MedAmine-source/Ameloration-of-old-industrial-machinery/new version machine beta/robot-gripper-mechanism-v2-1.snapshot.5/hvataljka v2.jpg

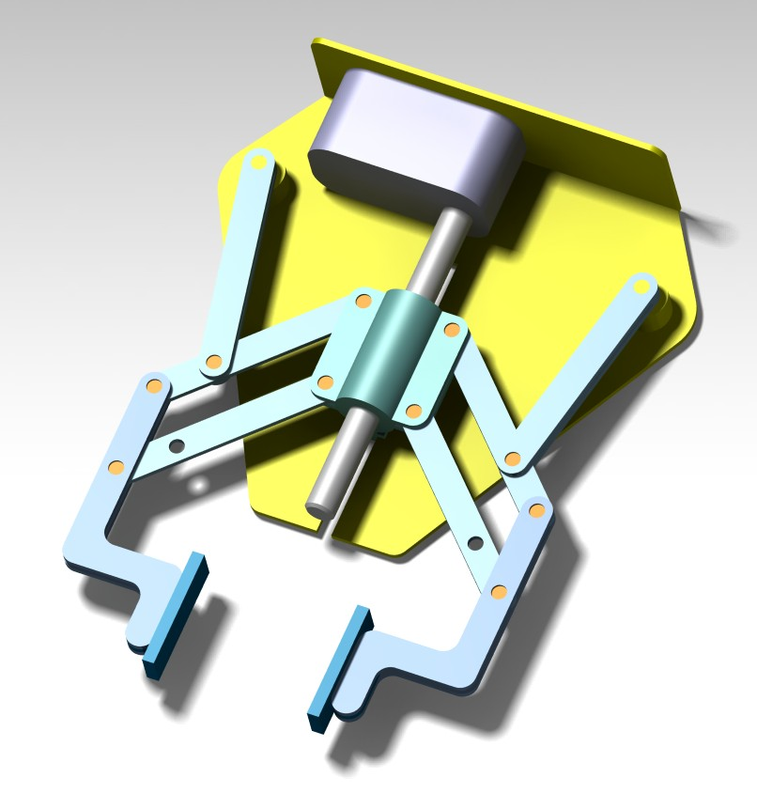
new version machine beta/robot-gripper-mechanism-v2-1.snapshot.5/hvataljka v2.jpg
