MedAmine-source/Ameloration-of-old-industrial-machinery/README.md

# Ameloration-of-old-industrial-machinery
this project is a full work to improve an old machine installed in a wheels factory . the main function of it is the Gluing the 'apex' material in metallic form is called 'trangle' to support the wheel being manufactured.
