MedAmine-source/Ameloration-of-old-industrial-machinery/old version machine/mechanical design/apex machine.docx

Introduction générale

# CHAPITRE 1: Recherche bibliographie

## 1.1 Description de machine :

La machine d’application Apex sur tringle est un équipement industriel utilisé dans le processus de fabrication des pneus. Elle permet l’assemblage d’une bande de caoutchouc rigide appelée « Apex » autour de la tringle métallique du pneu. Cette opération est essentielle car elle contribue à renforcer la zone basse du pneu et à améliorer sa rigidité ainsi que sa stabilité structurelle.

L'installation actuelle repose sur une architecture de commande ancienne utilisant des composants devenus obsolètes, ce qui engendre des difficultés de maintenance, de disponibilité des pièces de rechange et de fiabilité opérationnelle.

## 1.2 Les types de machines :

- Automatic Apex Application System – Steelastic:

L’Automatic Apex Application System[1] développé par Steelastic est une machine industrielle entièrement automatisée utilisée dans le processus de fabrication des pneus. Elle permet l’application précise et continue de la bande Apex autour de la tringle métallique (bead) avant l’étape d’assemblage du pneu.

Ce système intègre :

- Un mécanisme d’alimentation automatique de la bande Apex
- Un système de positionnement et de rotation contrôlée de la tringle
- Des rouleaux presseurs assurant une adhérence uniforme
- Des capteurs de contrôle de tension et de position
- Un système de commande par automate programmable (PLC)

L’objectif principal de cette machine est d’assurer :

- Une haute précision d’application
- Une répétabilité constante
- Une réduction des erreurs humaines
- Une amélioration significative de la productivité

Ce type de solution est généralement utilisé dans les usines modernes de fabrication de pneus à grande capacité de production.

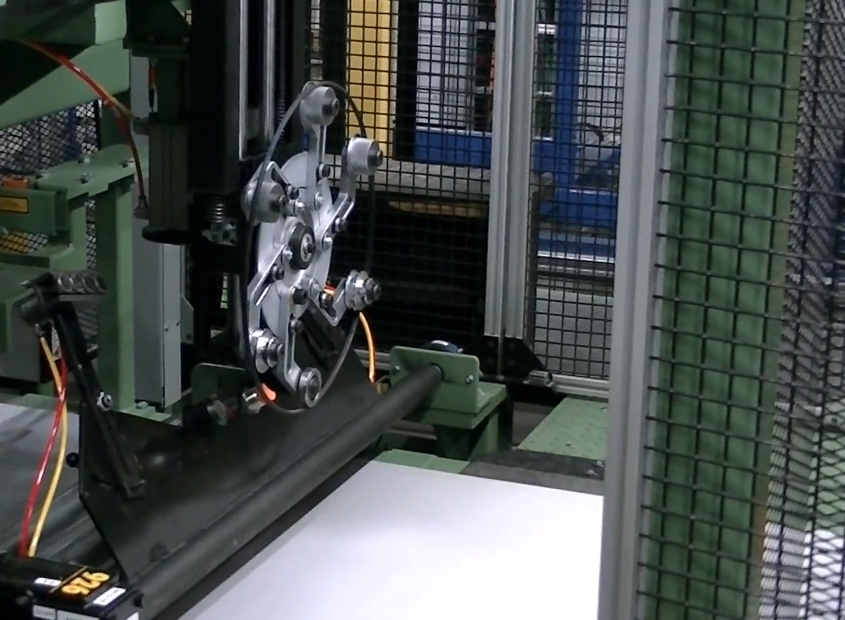
[picture p2: figure]

Figure 1:machine apex steelastic

- Bead Apexing Machines – Intereuropean:

Les Bead Apexing Machines[2] développées par Intereuropean sont des équipements industriels automatiques destinés à l’application de la bande Apex sur la tringle (bead) dans le processus de fabrication des pneus.

Ces machines sont conçues pour garantir une application précise, uniforme et répétable de l’Apex, contribuant ainsi à améliorer la rigidité structurelle et la qualité finale du pneu.

Le système comprend généralement :

- Une unité d’alimentation ou d’extrusion de la bande Apex
- Un dispositif de positionnement et de rotation automatique de la tringle
- Des rouleaux de pression assurant une adhérence optimale
- Des capteurs de contrôle de position et de tension
- Un système de commande automatisé (PLC + interface opérateur)

Les machines d’Intereuropean peuvent être intégrées dans une ligne complète comprenant également l’application du flipper, permettant ainsi une automatisation avancée du processus de préparation de la tringle.

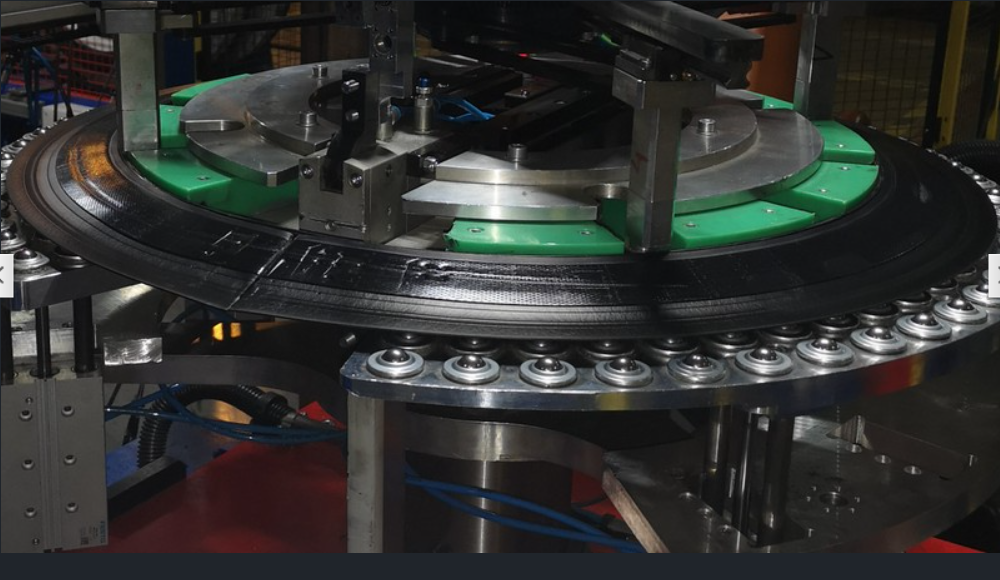
[picture p3: figure]

Figure 2: machine apex INTEREUROPEAN

- Bead Apexing Machines – VIPO:

Les machines semi-automatiques et automatiques d’application Apex[3] développées par VIPO sont destinées au montage précis de la bande Apex sur la tringle dans le processus de fabrication des pneus.

Ces équipements sont conçus pour améliorer la qualité d’assemblage, réduire l’effort humain et garantir une meilleure répétabilité par rapport aux systèmes manuels traditionnels.

Selon le modèle (PCR, TBR, AGRO), les machines peuvent inclure :

- Un système d’alimentation contrôlée de la bande Apex
- Un dispositif de rotation motorisée de la tringle
- Des rouleaux de pression assurant une application uniforme
- Un contrôle de tension de la bande
- Un système de commande programmable (PLC)
- Une interface opérateur pour le réglage des paramètres
- Automatic Truck Bead Apex System:

Les versions semi-automatiques comme le machine apex de la qualité Bartell Machinery [4] nécessitent encore l’intervention de l’opérateur pour certaines étapes (chargement, positionnement), tandis que les versions automatiques assurent un cycle presque entièrement contrôlé par le système de commande.

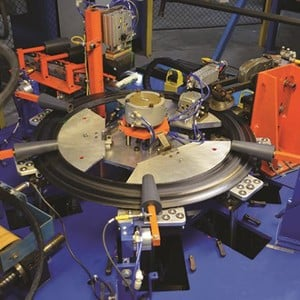
[picture p4: figure]
Automatic Truck Bead Apex System-Image

Figure 3: machine apex Bartell Machinery

- Machine apex tourisme STIP-AMINE :

Le machine apex STIP-AMINE est une machine semi-manuel permet d’assembler le matière apex sur le support trangle par l’opérateur.

L'installation actuelle repose sur une architecture de commande ancienne utilisant des composants devenus obsolètes, ce qui engendre des difficultés de maintenance, de disponibilité des pièces de rechange et de fiabilité opérationnelle

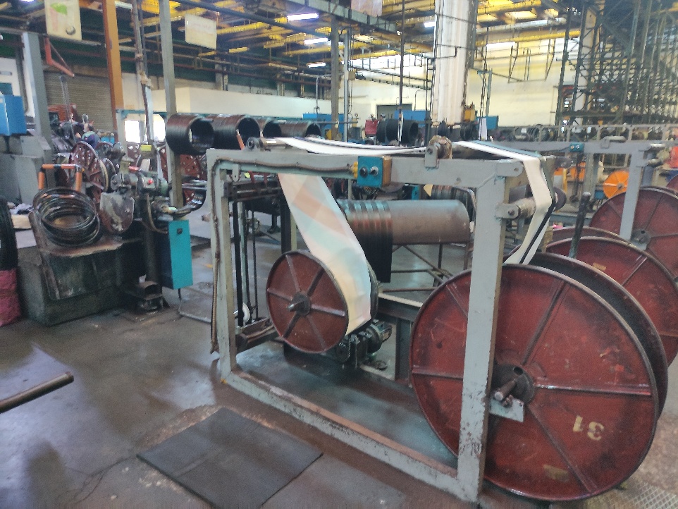
[picture p5: figure]

Figure 4:machine apex tourisme STIP

## 1.3 Domaine d’application des machines Apex :

- Industrie concernée :

Ces machines sont utilisées dans :

- L’industrie des pneus automobiles (PCR – Passenger Car Radial)
- L’industrie des pneus poids lourds (TBR – Truck and Bus Radial)
- L’industrie des pneus agricoles (AGRO)
- L’industrie des pneus industriels et génie civil (OTR – Off The Road)

Les grandes entreprises du secteur pneumatique utilisent ce type d’équipement dans leurs lignes de production automatisées.

- Rôle dans le processus de fabrication :

Dans le processus de fabrication d’un pneu, l’Apex est une bande de caoutchouc rigide appliquée autour de la tringle métallique. Son rôle est :

- D’assurer la rigidité de la base du pneu
- De renforcer la zone de contact avec la jante
- D’améliorer la stabilité et la durabilité du pneu

La machine d’application Apex intervient avant l’assemblage du pneu vert (green tire) et avant la phase de vulcanisation.

- Types de production concernés :

Ces machines sont adaptées aux :

- Lignes de production à grande cadence
- Systèmes de fabrication automatisés
- Usines à haute exigence de qualité
- Environnements industriels nécessitant une précision répétable
- Importance industrielle :

L’application correcte de l’Apex influence directement :

- La qualité du pneu final
- La sécurité du véhicule
- La durée de vie du pneu
- La performance mécanique

Une mauvaise application peut provoquer des défauts structurels ou un déséquilibre du pneu.

## 1.4 Étude de l’existante :

### 1.4.1 Partie mécanique :

La machine se compose principalement de :

-Système de transmission à poulies et courroies.

-Guides mécaniques en queue d’hirondelle.

-Vérins pneumatiques pour des opérations de manutention spécifiques.

-Éléments de transport qui permettent le déplacement de différents axes.

- Limites observées :

-Corrosion mécanique de certains composants.

-Le jeu mécanique affecte la précision.

-Difficulté à ajuster les positions.

-Maintenance fréquente.

### 1.4.2 Partie électrique :

L’armoire électrique contient :

-Connecteurs.

-Relais électromécaniques.

-Sources d’énergie.

-Capteurs de fin de course.

-Électrovannes pneumatiques.

- Limites observées

-Câblage complexe.

-Difficulté à diagnostiquer les erreurs.

-Manque de supervision moderne.

-Maintenance coûteuse.

## 1.5 Conclusion :

Le domaine de la préparation de la tringle dans l’industrie du pneumatique, une étape critique influençant la qualité et la sécurité du produit final.

# CHAPITRE 2: Analyse fonctionnelle

## 2.1 Introduction :

L’analyse fonctionnelle est une démarche méthodologique utilisée en ingénierie pour identifier, structurer et formaliser les fonctions qu’un système doit assurer, indépendamment des solutions techniques adoptées. Dans le cadre du projet de rénovation de la machine d’application Apex, l’analyse fonctionnelle constitue une étape essentielle afin de comprendre le fonctionnement global du système actuel et de définir les améliorations nécessaires.

## 2.2 Analyse de besoin :

### 2.2.1 Saisi de besoin :

Le machine d’apex a plusieurs problèmes a regluer :

- Augmenter la fiabilité du système.
- Améliorez la précision des mouvements.
- Réduire les temps de maintenance.
- Mettez à jour l’interface du lanceur.
- Faciliter le diagnostic des défauts.
- Permettre le développement futur du système.

### 2.2.2 ENONCE DU BESOIN :

- À qui rend service la machine ?

Utilisateur : Opérateur industriel

- Sur quoi agit-elle ?

Matière d’œuvre : Tringle + bande Apex

- Dans quel but ?

Assurer l’application correcte de l’Apex sur la trangle

Diagramme bête corne :

Opérateur industriel

Tringle et bande apex

Machine apex tourisme

Assurer l’application correcte de l’Apex sur la tringle

À qui la machine sert- il

A qui l’imprimante 3D sert- il

Sur quoi agit-il

Sur quoi agit-il

Dans quel but le produit existe-il

Dans quel but le produit existe-il

Figure 5:diagramme bête corne

### 2.2.3 VALIDATION DU BESION :

La machine d’application Apex sur tringle est conçue pour répondre au besoin d’assurer un assemblage précis, uniforme et sécurisé de la bande Apex autour de la tringle métallique dans le processus de fabrication des pneus. Cette opération est essentielle pour garantir la rigidité structurelle et la qualité finale du produit.

Cependant, le système actuellement en service repose sur un fonctionnement semi-manuel nécessitant une intervention humaine permanente, ce qui limite la précision, la répétabilité et la productivité du processus. La modernisation de cette machine vise donc à améliorer l’efficacité de production, à réduire les variations liées à l’opérateur et à renforcer les conditions de sécurité.

Dans un contexte industriel où les exigences de qualité, de performance et d’automatisation sont en constante évolution, il est indispensable que la machine d’application Apex évolue afin de répondre aux standards modernes de l’industrie pneumatique et de maintenir la compétitivité de l’entreprise sur le marché.

### 2.2.4 Diagramme SADT :

Le diagramme SADT (Structured Analysis and Design Technique) est une méthode de modélisation fonctionnelle qui permet de représenter un système de manière structurée, en allant du général vers le détail. Il est particulièrement adapté aux systèmes industriels où coexistent plusieurs flux tels que la matière d’œuvre, l’énergie et les informations de commande.

Dans le cas de la machine d’application Apex, la modélisation SADT repose sur l’interaction entre quatre éléments fondamentaux :

• La fonction globale, qui consiste à assembler la matière Apex sur la tringle métallique afin d’obtenir une tringle assemblée prête pour l’étape suivante du processus de fabrication du pneu.

• Les moyens ou mécanismes (processeurs) intégrés dans le périmètre du système, tels que le moteur réducteur, la structure mécanique, ainsi que le système de logique câblée assurant la mise en marche.

• La matière d’œuvre, représentée par l’ensemble « Apex + tringle non assemblée » en entrée, transformé en « tringle assemblée » en sortie.

• Les données de contrôle et ressources, comprenant l’intervention de l’opérateur, la logique câblée, la commande de mise en marche et l’énergie électrique nécessaire au fonctionnement du système.

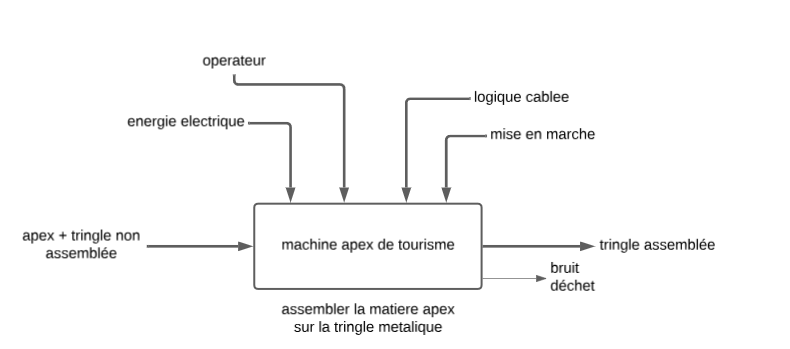
[picture p6: figure]

Figure 6:diagramme SADT

Par ailleurs, le système génère également des éléments secondaires en sortie, tels que le bruit et les déchets, qui constituent des flux environnementaux associés au fonctionnement de la machine.

Ainsi, le diagramme SADT permet de visualiser clairement le rôle de la machine Apex dans la transformation de la matière d’œuvre, tout en identifiant les interactions entre les flux d’énergie, de contrôle et de production.

### 2.2.5 Identification des fonctions de services principales et complémentaires :

Figure 7:diagramme pieuvre

FP

Apex machine tourisme

Milieu ambient

précision

Energie électrique

Utilisateur

Tringle +apex

FC1

FC2

FC3

Énonce des fonctions :

FP : assembler l’apex sur la tringle par un opérateur industriel

FC1 : résister à l’environnement industriel

FC2 : travailler sur une énergie électrique

FC3 : garantir une précision suffisante

### 2.2.6 Comparaison et valorisation des fonctions de services :

Pour hiérarchiser les fonctions de services du système, on utilise l’outil « Tri-croisé » qui correspond à un tableau contenant les différentes fonctions et leurs poids respectifs. Les notes sont attribuées selon la démarche de priorité suivante :

0 : Pas de supériorité.

1 : Légèrement supérieur.

2 : Moyennement supérieur.

3 : Nettement supérieur.

Tableau 1:tri croisé

| FC1 | FC2 | FC3 | Score
FP | 3/FP | 1/FP | 3/FP | 7
| FC1 | 3/FC2 | 3/FC1 | 3
| | FC2 | 1/FC3 | 2
| | | FC3 | 1
| | | TOTAL | 13

Figure 8: histogramme de la fonction

### 2.2.7 Digramme FAST :

Le diagramme FAST (fig.9.) (Function Analysis System Technique) permet d’établir le lien entre le besoin fondamental et l’architecture d’un produit en passant par les fonctions de service et les fonctions techniques.

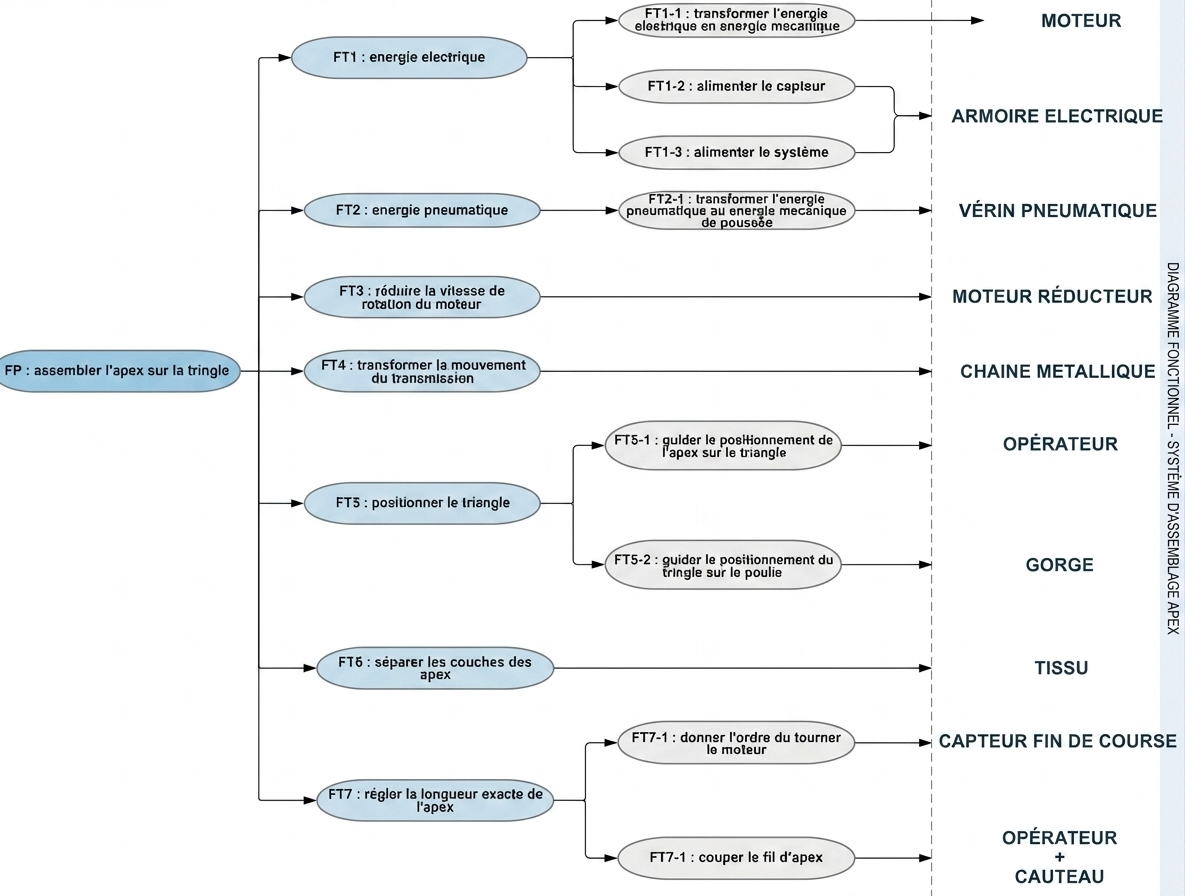
[picture p7: figure]

Figure 9:diagramme FAST

## 2.4 Reduction cahier de charge fonctionnel :

Le cahier des charges fonctionnel vise à définir les exigences nécessaires pour moderniser la machine d’application Apex. L’objectif principal est d’assurer un assemblage précis et fiable de la bande Apex sur la tringle, tout en améliorant la sécurité, la productivité et en réduisant l’intervention humaine. Cette machine a plusieurs problèmes retenus j’ai le diffuser sur plusieurs défauts

Tableau 2:tableau réduction de défauts

Défauts | | Les défauts
D1 | Système de freinage manuel | -usure a cause de pression non ajustée -réglage lente -maintenance lente
D2 | Sécurité | -Faible sécurité limite au buttons de l’urgence
D3 | Vibration de moteur principale | -moteur a haute couple causée de jetée le chaine, cassure le réducteur
D4 | Système de translation | -coincement lors de translation -un mauvais contact avec la capture qui commande le moteur principal a cause de l’emplacement incomplète de rouleau

## 2.5 Proposition des solutions :

Tableau 3:proposition des solutions

Prototypes proposée | | Image | Avantages (+) | Inconvénients (-)

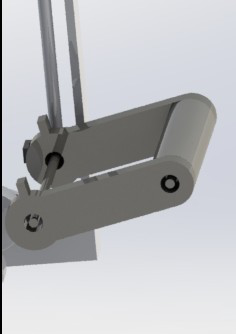
[picture p8: figure]

S1 | Levier rotatif | | -cout réduite -complexité de fabrication faible -vitesse élevée | -faible charge supportée -précision limitée

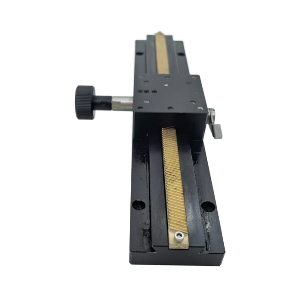
[picture p9: figure]

S2 | Queue d’aronde | | -précision très élevée -bon rigidité -support des charges lourds | -cout très élevée -fabrication complexe

## 2.6 Comparaison entre les solutions :

- Choix de critère :

Pour l’obtention d’une solution bien adaptée au besoin, il est nécessaire de respecter les critères suivants

Tableau 4:choix de critère de la solution

| Les critères
C1 | Cout
C2 | Maintenance
C3 | Facilement de montable et démontable
C4 | La durée de fabrication
C5 | Vitesse de fonctionnement

- Valorisation par critère :

Pour chaque critère, on a attribué une note qui varie entre 1 et 3 suivant l’intérêt de la solution :

Tableau 5:tableau valorisation du choix

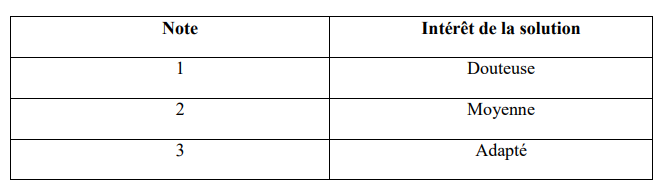
[picture p10: figure]

A partir la valorisation des critères on a dressé le tableau de la valorisation globale sur les solutions proposées ci-dessous :

Tableau 6:valorisation de critère sur solution D4

| Les solutions
| S1 | S2
C1 | 3 | 1
C2 | 3 | 2
C3 | 2 | 3
C4 | 3 | 1
C5 | 3 | 1

- Valorisation globale :

La valorisation globale est donnée par une note de 1 à 5 suivant l’importance des critères :

Tableau 7:Tableau de coefficient

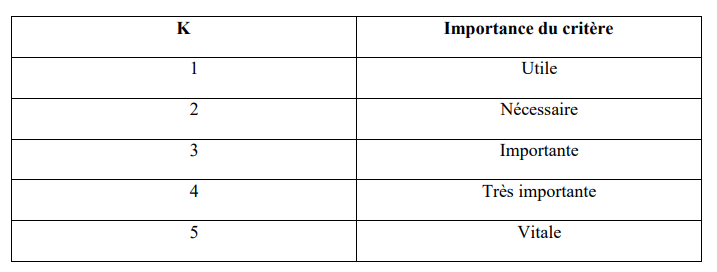
[picture p11: figure]

On applique cette valorisation globale sur les solutions proposées :

Tableau 8:valorisation globale du solution D4

| K | Solutions
| | S1 | | S2
| | note | total | note | total
C1 | 5 | 3 | 15 | 1 | 5
C2 | 2 | 3 | 6 | 2 | 4
C3 | 4 | 2 | 8 | 3 | 12
C4 | 5 | 3 | 15 | 1 | 5
C5 | 3 | 3 | 9 | 1 | 3
Total | | 53 | | 29

## 2.7 Analyse de résultats :

La solution retenue est le type S1 un levier rotatif car elle possède un total pondéré le plus élevé et globalement la plus intéressante

## 2.8 Choix des solutions :

## 2.9 Choix des actionneurs :

Le tableau ci-dessous représente les avantages et les inconvénients de chaque type des actionneurs, mais ça n’est pas suffisant. Les deux tableaux suivants fournissent une évaluation base sur d’autres critères afin que la sélection la plus précise puisse être faite :

Tableau 9:choix de actionneurs

N° | Type | Fonction principale | Avantages (+) | Inconvénients (-)

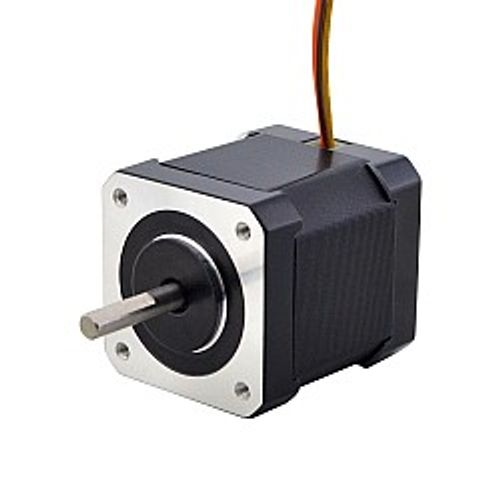
[picture p12: figure]
Nema 17 Moteur pas à pas haute température 59Ncm(84oz.in) Classe d'isolation H 180C

1 | Moteur pas à pas | Produire un mouvement précis | - Positionnement précis - Pas d'encodeur nécessaire - Coût faible - Facile à piloter | - Couple diminue à haute vitesse - Moins performant qu'un servo - Chauffe au maintien

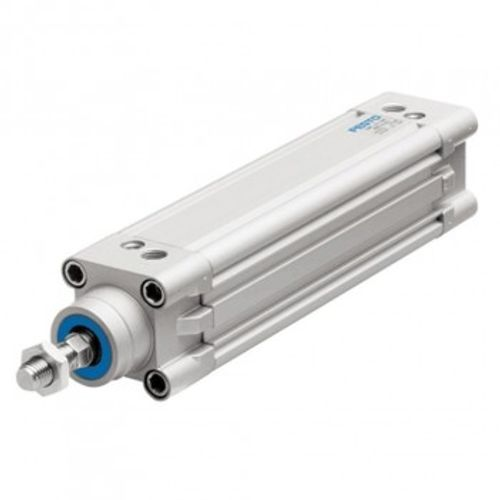
[picture p13: figure]

2 | Verin pneumatique | Produire une translation rapide | - Très grande force - Mouvement rapide - Robuste | - Nécessite une installation - Cout élevée - Positionnement précis difficile - Bruit

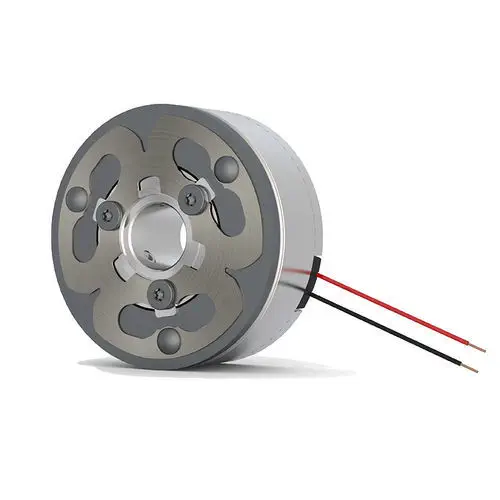
[picture p14: figure]

3 | Aiment à excitation | Bloquer une position | - Maintien sans consommation - Sécurité en cas de coupure électrique - Réponse rapide | - Ne produit pas de mouvement - Sert uniquement à bloquer ou maintenir - Couple limité selon la taille

### 2.9.1 Choix de actionneurs pour système de freinage :

- Choix de critère :

À partir du cahier de charge fonctionnel on choisit de remplacer le système D1donc va décider d’installer actionner de type N°3 ou bien N°2. On choisit de fixer les critères du type d’actionneur comme indique le tableau suivant :

Tableau 10:choix de critère pour les actionneurs D1

| Les critères
C1 | Adaptée au fonctionnement de système
C2 | Performance
C3 | Prix

Valorisation des critères sur les solutions : qui est indiqué dans le tableau

A partir la valorisation des critères on a dressé le tableau de la valorisation globale sur les solutions proposées ci-dessous :

Tableau 11:valorisation de critère du solution D1

| Verin pneumatique | Aiment à excitation
C1 | 3 | 1
C2 | 3 | 2
C3 | 1 | 3

- Valorisation globale :

La valorisation globale est donnée par une note de 1 à 5 suivant l’importance des critères : qui est présenter dans le tableau

On applique cette valorisation globale sur les solutions proposées :

Tableau 12:valorisation globale sur le solution D1

| | S1 | | S2
Critère | K | Note | Totale | Note | Totale
C1 | 5 | 3 | 15 | 1 | 5
C2 | 3 | 3 | 9 | 2 | 6
C3 | 5 | 1 | 5 | 3 | 15
Totale | | 29 | | 26

- Analyse du résultat :

Le vérin obtient une bonne note en termes Adaptée au fonctionnement de système car elle peut combiner avec un patin Ferro pour diminuer l’usure dans le système précèdent et a une performance et durée de vie élevée.

Aiment à excitation obtient le meilleur note en termes de cout car elle se caractériser par le simple mécanisme de fonctionnement qui agir sur elle prix.

### 2.9.2 Choix de critère pour le système automatique :

- Choix de critère :

À partir du cahier de charge fonctionnel on choisit de fabriquer un système intermédiaire pour augmenter la correction de défaut D1 et diminuer le temps perte en production va décider d’installer actionner de type N°1ou bien N°2. On choisit de fixer les critères du type d’actionneur comme indique le tableau suivant :

Tableau 13:choix de critère pour les actionneurs

| Les critères
C1 | Besoin de Structure et des composants auxiliaires
C2 | Précision
C3 | Prix

Valorisation des critères sur les solutions : qui est indiqué dans le tableau

A partir la valorisation des critères on a dressé le tableau de la valorisation globale sur les solutions proposées ci-dessous :

Tableau 14:valorisation des actionneurs

| Verin pneumatique | Moteur pas a pas
C1 | 1 | 3
C2 | 1 | 3
C3 | 1 | 3

- Valorisation globale :

La valorisation globale est donnée par une note de 1 à 5 suivant l’importance des critères : qui est présenter dans le tableau

On applique cette valorisation globale sur les solutions proposées :

Tableau 15:valorisation globale des actionneurs

| | S1 | | S2
Critère | K | Note | Totale | Note | Totale
C1 | 5 | 1 | 5 | 3 | 15
C2 | 3 | 1 | 3 | 3 | 9
C3 | 5 | 1 | 5 | 3 | 15
Totale | | 13 | | 39

- Analyse du résultat :

La solution retenue est le type S2 moteur pas à pas car elle possède un total pondéré le plus élevé et globalement la plus intéressante

## 2.10 Choix d’automatisation :

Pour augmenter les critères des défauts retenus dans la partie réduction de rapport on choisit de faire d’automatisée le système. Le tableau ci-dessous représente les avantages et les inconvénients de chaque type de partie commande qui a une fonctionne principale commun consiste de commander et automatiser notre machine :

Tableau 16:choix d'automatisation de système

N° | Type | Avantages (+) | Inconvénients (-)

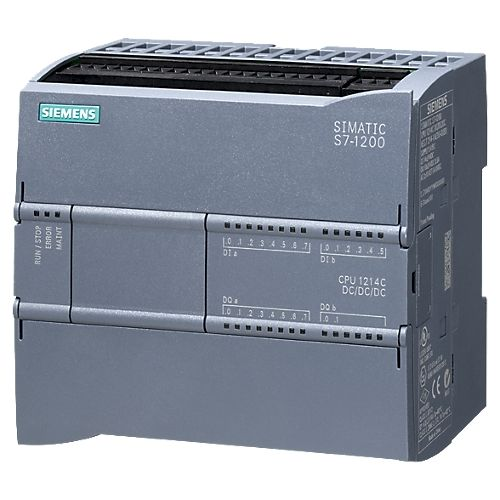
[picture p15: figure]
Unité centrale automate compacte S7-1200 Siemens

1 | Automate s7-1211 | -Fiabilité industrielle Élevée -Logique machine avancée, séquençage, temporisations, compteurs intégrés -diagnostic facile, forçage des variables en live | -Seulement 2 PTO intégrés -Prix élevé comparé aux microcontrôleurs -Écosystème fermé difficile à interfacer avec du matériel non-Siemens

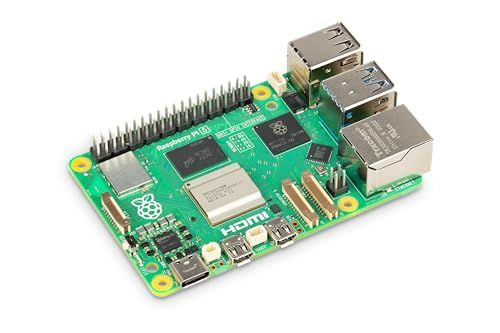
[picture p16: figure]
Raspberry Pi 5 8GB

2 | Carte Raspberry pi 5 | -Puissant quad-core 2.4 GHz, 8 Go RAM -Eco système complète avec écran tactile, interface graphique riche -Très bon rapport qualité/prix | -Aucun PTO hardware impossible de contrôler directement les steppers Sensible aux coupures de courant sans arrêt propre

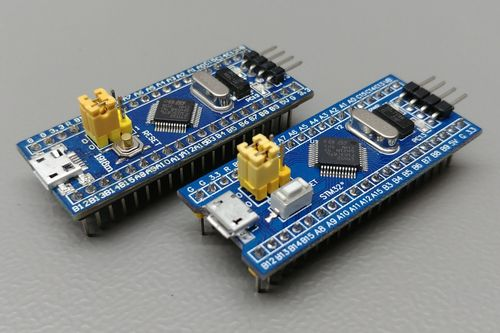
[picture p17: figure]
Blue Pill: Variants

3 | STM32F103 Blue Pill | -Temps réel parfait -7 hardware PTO précis à 72 MHz -Prix imbattable -Consommation très faible ~50 mA en fonctionnement | -Pas de HMI — aucun affichage intégré -Logique machine complexe difficile à programmer (pas de ladder) -Pas de diagnostic facile en production -RAM limitée (20 KB) pas adapté aux traitements lourds
4 | Intégration STM32F103 avec s7-1211 | -7 hardware PTO précis à 72 MHz -Coût bien inférieur au S7-1214C pour le même résultat -Évolutif facile | -Synchronisation entre les 2 systèmes -Câblage supplémentaire RS485, MAX485, alimentation STM32

- Choix de critère :

Le tableau ci-dessous représente les avantages et les inconvénients de chaque type d’API et cartes embarques, mais ça n’est pas suffisant. Les deux tableaux suivants fournissent une évaluation base sur d’autres critères afin que la sélection la plus précise puisse être faite :

Tableau 17:choix de critère pour les appareilles de commandes

| Les critères
C1 | Adaptée au fonctionnement de système
C2 | Performance
C3 | Prix

Valorisation des critères sur les solutions : qui est indiqué dans le tableau

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

Tableau 18:valorisation de cartes

| Automate s7-1211 | Carte Raspberry pi 5 | STM32F103 Blue Pill | Intégration STM32F103 avec s7-1211
C1 | 2 | 1 | 2 | 3
C2 | 3 | 2 | 2 | 3
C3 | 3 | 1 | 1 | 3

- Valorisation globale :

La valorisation globale est donnée par une note de 1 à 5 suivant l’importance des critères : qui est présenter dans le tableau

On applique cette valorisation globale sur les solutions proposées :

Tableau 19:valorisation globale de appareilles de commande

| | S1 | | S2 | | S3 | | S4
Critère | K | Note | Totale | Note | Totale | Note | Totale | Note | Totale
C1 | 4 | 2 | 8 | 1 | 4 | 2 | 8 | 3 | 12
C2 | 3 | 3 | 9 | 2 | 6 | 2 | 6 | 3 | 9
C3 | 5 | 3 | 15 | 1 | 5 | 1 | 5 | 3 | 15
Totale | | | 32 | | 15 | | 19 | | 36

- Analyse du résultat :

Intégration STM32F103 avec s7-1211obtient la meilleure note en termes de compatibilité.

Le point clé à retenir : le seul vrai inconvénient de cette combinaison c'est qu'il faut maîtriser deux environnements de développement en même temps TIA Portal pour le PLC et STM32CubeIDE pour le microcontrôleur.

Mais en contrepartie tu gagnes une architecture industrielle robuste pour moins cher que le S7-1214C seul.

## 2.11 Partie semi-automatique :

Pour diminuer le perte temps de production et augmenter la sécurité de système je suis décédé de faire un mécanisme automatique sur la partie chauffe du système aussi augmente peu la précision de système.

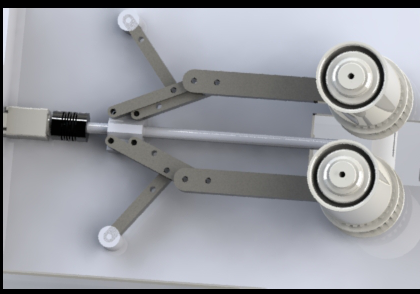
[picture p18: figure]

Figure 10:systeme semi-automatique

## 2.12 Guidage en translation :

Le tableau ci-dessous représente les avantages et les inconvénients de chaque type du système de guidage en translation. Les deux tableaux suivants fournissent une évaluation base sur d’autres critères afin que la sélection la plus précise puisse être faite :

Tableau 20:comparaison entre les différents systèmes de guidages

N° | Système | Avantage | Inconvénient

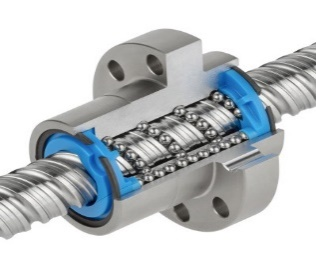
[picture p19: figure]

1 | Vis à bielle | - Résiste aux frottements. - Fonctionnement souple garce au système de recyclage des bielles. - Longue durée de vie. | - A cause du faible coefficient de frottement, les vis à billes n’ont pas d’auto blocage.

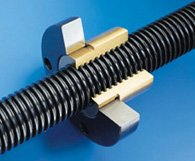
[picture p20: figure]

2 | Vis écrou | - Ce mécanisme peu importe des forces et des pressions importantes. | - Ce mécanisme génère beaucoup de frottement. .

- Choix de critère :

À partir du cahier de charge fonctionnel on choisit de fixer les critères du type de vis comme indique le tableau suivant :

Tableau 21:choix de critère pour les système de translation

| Les critères
C1 | Précision
C2 | Rendement
C3 | Résistance
C4 | Coût

- Valorisation par critère :

Pour chaque critère, une note allant de 1 à 3 a été attribuée, en fonction de l'intérêt de la solution, comme décrit dans le tableau

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

Tableau 22:valorisation de systèmes du guidage

Les critères | S1 : Vis à bille | S2 : Vis écrou
C1 : Précision | 3 | 2
C2 : Rendement | 3 | 2
C3 : Résistance | 2 | 3
C4 : Coût | 1 | 2

- Valorisation globale :

La valorisation globale est donnée par une note de 1 à 5 en fonction de l'importance des critères, comme le montre le tableau.

On applique cette valorisation globale sur les solutions proposées :

Tableau 23:valorisation globale de système de translation

| | S1 | | S2
Critère | K | Note | Totale | Note | Totale
C1 | 3 | 3 | 9 | 2 | 6
C2 | 3 | 3 | 9 | 2 | 6
C3 | 4 | 2 | 8 | 3 | 12
C4 | 3 | 1 | 3 | 2 | 6
Totale | | | 29 | | 30

- Analyse du résultat :

De ces analyses et calculs des valeurs revenant à chaque solution on conclut que la solution 2, le système vis écrou, est la solution la plus efficace pour notre système.

## 2.13 Conclusion :

Permis d’identifier les fonctions essentielles du système et de mettre en évidence les contraintes techniques à prendre en compte lors de sa rénovation. L’étude de l’existant a également révélé plusieurs limites affectant les performances, la sécurité et la fiabilité de la machine.

Sur la base des résultats obtenus et des évaluations multicritères réalisées, les solutions techniques les plus adaptées ont été retenues, notamment le levier rotatif pour le guidage, le moteur pas à pas comme actionneur principal, le vérin pneumatique pour le freinage, l’association STM32F103–S7-1211C pour la commande ainsi que le système vis–écrou pour la translation. Ces choix constituent une base solide pour la suite du projet. Le chapitre suivant sera consacré à la conception détaillée, au dimensionnement et à la validation des différents composants mécaniques et électriques de la machine rénovée.

# CHAPITRE 3: Modélisation et calcul

## 3.1 Introduction :

Dans ce chapitre, nous détaillerons les étapes de la modélisation et du dimensionnement de la machine Apex Tourisme dans le cadre de sa rénovation et de son automatisation. Cette étude comprend l’analyse du fonctionnement mécanique et électrique de la machine, ainsi que l’évaluation des mouvements et des différents systèmes intégrés afin d’assurer un fonctionnement fiable et performant.

Nous présenterons également les calculs nécessaires pour le choix des moteurs, des capteurs, des actionneurs et des composants mécaniques et électriques adaptés aux exigences du système.

L’objectif principal de cette étude est de concevoir une solution de rénovation optimisée, garantissant une amélioration des performances, de la précision et de la sécurité de la machine tout en répondant aux besoins industriels demandés.

## 3.2 Étude cinématique :

### 3.2.1 Schéma cinématique :

Le schéma cinématique de la solution retenue est élaboré comme suit :

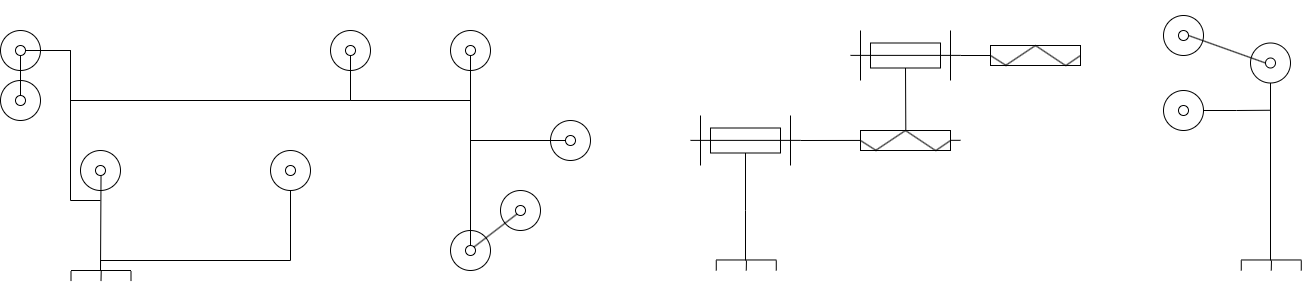
[picture p21: figure]

Figure 11:schéma de système cinématique 2d

## 3.3 Étude dimensionnelle de la solution retune :

Dans cette section, nous aborderons l’étape du dimensionnement des composants de notre système. Pour les composants standard, nous avons utilisé des documents techniques, tels que des catalogues de différents fabricants spécialisés dans des domaines spécifiques. Cependant, pour les pièces nécessitant un usinage et une fabrication, une étape de conception et de modélisation a été réalisée à l'aide du logiciel SolidWorks, parallèlement aux calculs appropriés.

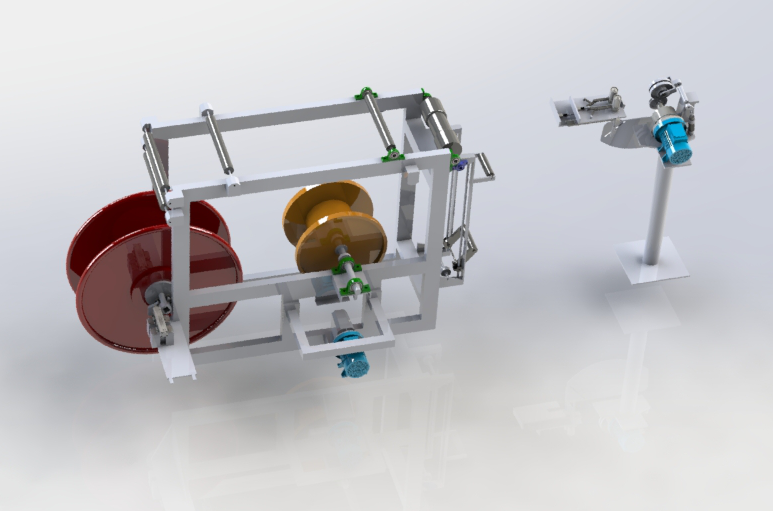
[picture p22: figure]

Figure 12:innovation de machine apex tourisme

## 3.4 Choix de moteurs :

- Charge appliquée en levier rotatif :

On va calculer la force de pesanteur applique à levier rotatif pour calculer exactement la caractéristique de moteur à obtenir. On va simplifier le système pour mieux comprendre on a 2 masses trouvée en notre système m1 et m2

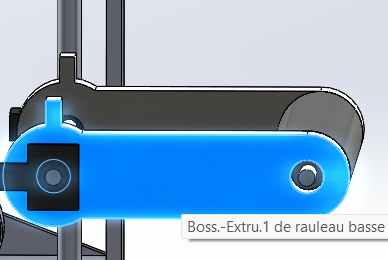
[picture p23: figure]

F

m1

XG

m2

P

Figure 13:concentration de forces

D’après la figure Il faut déterminer le point de centration XG (centre de masse) pour attient la force de pesanteur P

x_G =(∑ mi*xi)/(∑ mi)

x_G =(m1*L/2+m2*L)/(m1+m2)

or m1=3.00696 kg , m2=1.69891 kg et L=0.15 m

x_G =(3.00696*0.15/2+1.69891*0.15)/4.70587=0.10207 m=102.07 mm

=>P=(m1+m2)*g=4.70587*9.81=46.1646 N

Alors après déterminer la force p et sa position il faut calculer la force F nécessaire pour cette étude :

d_F =L=0.15

D’après PFS (principe fondamentale de la statique)

∑ M_(F_(ext)) =0 [1]

M_F -M_G =0

F*L=(m1+m2)*g*x_G

F*0.15=4.70587*9.81*0.10207

F=31.41 N

Donc F = 31,41 N est la force exacte nécessaire pour maintenir la barre en équilibre statique.

=>Si F > 31,415 N → la barre pivote vers le haut ↑

=>Si F <31,415 N → la barre pivote vers le bas ↓

=>Si F = 31,415 N → la barre reste parfaitement immobile

D’après le PFD nous souhaitons d’attient 90 dégrée en 4 secondes

La deuxième loi de rotation de Newton :

∑ M_(Fext) =I*α [ SEQ Équation \* ARABIC 2 ]

Alors utilisant la cinématique pour calculer l’accélération angulaire :

θ=ω_0 *t+1/2*α*t^2 [ SEQ Équation \* ARABIC 3 ]

ou θ=90°=π/2 ,t=4 s et ω_0 =0(car il commence par le repos)

=>π/2=1/2*α*4^2

=>α=π/16=0.1963 rad/s^2

Pour Calculer le moment d’inertie I j’ai la décomposition de la forme il contient rectangle avec deux demi-cercles

M_(F_(ext)) :moment de force exterieur

I :moment d’interie

l_(rect) =longeur de forme rectangle

w=largeur

d_(rect) :position centre de masse

A_(rect) :aire de rectangle

A_(circle) :aire de circle

d_(circle) :position de circle

I_(totale) =I_(m1) +I_(m2) [ SEQ Équation \* ARABIC 4 ]

I_(m1) =I_(rect) +I_(circle) [ SEQ Équation \* ARABIC 5 ]

I_(rect) =(m_(rect))/12*(l_(rect)^2 *w^2 )+m_(rect) *d_(rect)^2 [ SEQ Équation \* ARABIC 6 ]

I_(circle) =1/2*m_(circle) *R^2 +m_(circle) *d_(circle)^2 [ SEQ Équation \* ARABIC 7 ]

l_(rect) =150 mm

A_(rect=) l_(rect) *2R=0.15*0.05=0.0075 m^2 [ SEQ Équation \* ARABIC 8 ]

A_(circle) =π*R^2 =π*0.025^2 =0.001963 m^2

- Fraction des masses :

(m_(rect))/(m1)=(A_(rect))/(A_(circle))=0.0075/0.009463=0.7925

(m_(circle))/(m1)=0.001963/0.009463=0.2075

Avec m1 = 3.00696 kg :

m_(rect) =0.7925*3.00696=2.3830 kg

m_(circle) =0.2075*3.00696=0.6239 kg

- Positions des Centres de Masse :

d_(rect) =R+(l_(rect))/2=0.025+0.075=0.1 m [ SEQ Équation \* ARABIC 9 ]

d_(circle) =R+ l_(rect) = 0.025+0.15 = 0.175 m [10]

=≫I_(rect) =(m_(rect))/12*(l_(rect)^2 +(2*R)^2 +m_(rect) *d_(rect)^2 [ SEQ Équation \* ARABIC 11 ]

I_(rect) =2.3830/12*(0.15^2 +0.05^2 )+2.3830*0.1^2

I_(rect) =0.004965+0.02383=0.02879 kg.m^2

=≫I_(circle) =1/2*m_(circle) *R^2 +m_(circle) *d_(circle)^2 [ SEQ Équation \* ARABIC 12 ]

I_(circle) =1/2*0.6239*0.025^2 +0.6239*0.175^2

I_(circle) =0.000195+0.019094=0.019289 kg.m^2

=≫I_(m1) =0.02879+0.01929=0.04808 kg.m^2

I_(m2) =I_(plein) -I_(trou)

I_(plein) =(m_(plein))/12*(3R^2 *L^2 )+m_(plein) *d^2 [ SEQ Équation \* ARABIC 13 ]

I_(plein) =1.7696/12*(3*0.025^2 +0.19^2 )+1.7696*0.2^2

I_(plein) =0.076391 kg. m^2

I_(trou) =(m_(trou))/12*(3r^2 *L^2 )+m_(trou) *d^2

I_(trou) =0.07069/12*(3*0.005^2 +0.19^2 )+0.07069*0.2^2

I_(trou) =0.003041 kg.m^2

I_(m2) =I_(plein) -I_(trou)

I_(m2) =0.076391-0.003041=0.07335 kg.m^2

Le moment inertie globale :

I_(totale) =I_(m1) +I_(m2)

I_(totale) =0.04808+0.07335=0.12143 kg.m^2

Alors d’après le PFD :

F*L=(m1+m2)*g*x_G +I_(totale) *α

F*0.15=4.70587*9.81*0.10207+0.12143*0.1963

F=31.57 N

- Tension de pose :

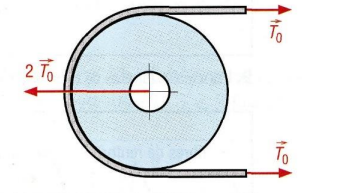
[picture p24: figure]

Figure 14:division d’une force sur la poulie

Alors la force de pose nécessaire dépendent aux nombre cordes de rouleaux en connexion

F_(pouse) =F/(nbre cordes)=31.57/2=15.79N [14]

- Couple moteur :

C_m =F_(pouse) *r_(poulie) =15.79*0.05=0.79 N.m [ SEQ Équation \* ARABIC 15 ]

- Force de vérin de freinage :

Après la validation de choix dans le chapitre précèdent on remplacer le mécanisme manuel de freinage Ancient par un nouveau mécanisme contient un vérin pneumatique avec un patin en Ferro pour résister le mouvement crée par le moteur principal

Vérin

F

Roue de bobine apex

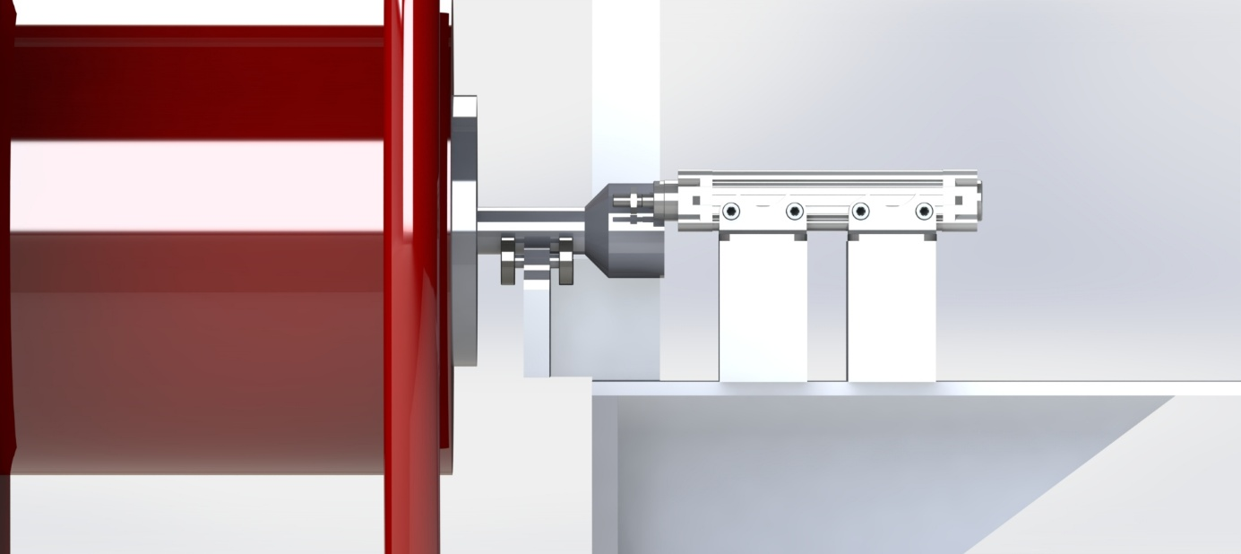
[picture p25: figure]

Figure 15:force appliquée sur la bobine d'apex

La force applique par le vérin produit une force de frottement Ff

F_f =μ*N [ SEQ Équation \* ARABIC 16 ]

D’après le PFD :

∑ M_(Fext) =I*α

M_(moteur) -M_(frottement) =I*α

Accélération :

α=(ω_(moteur))/(t_(arret)) ou t_(arret) =4sec

La vitesse angulaire de moteur

ω_(moteur) =(2πN)/60=2π*140/60=14.661 rad/s [ SEQ Équation \* ARABIC 17 ]

=≫α=14.661/4=3.665 rad/s^2

Moment de freinage :

M_(frottement) =M_(moteur) -I*α

Moment d’inertie calculée :

D’après l’annexe on va calculer le moment d’inertie de chaque roue de système on a deux. Une fixée avec la rotation de moteur principale (roue moteur) et l’autre amené l’apex et le tissu (roue de freinage)

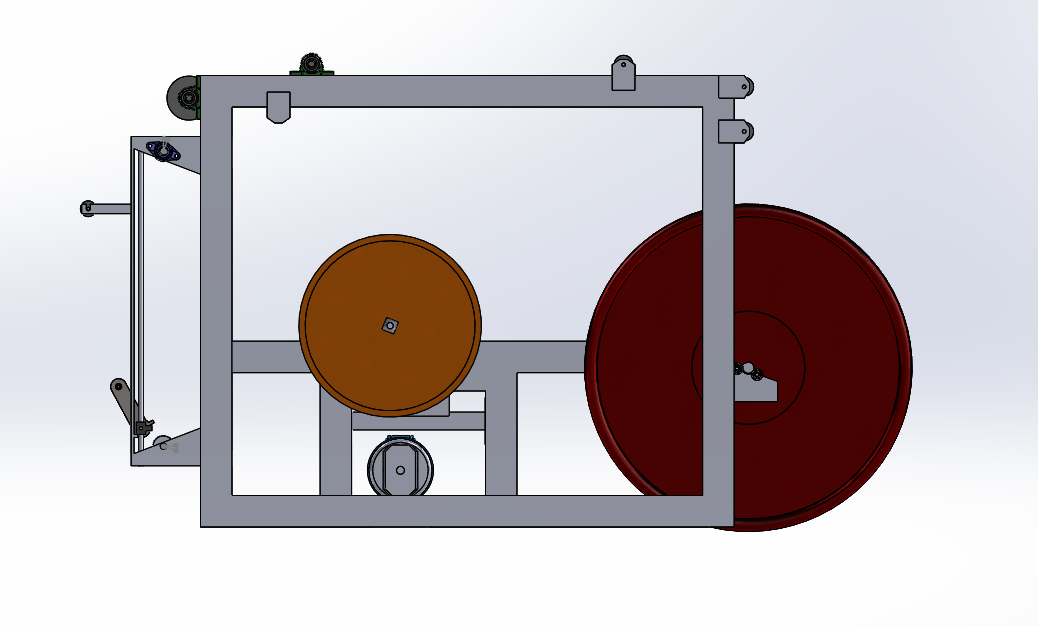
[picture p26: figure]

Roue freinage

Roue motrice

Figure 16:focus sur le mouvement de transmission

I=1/2m(R^2 +r^2 )

- Identification des roues :

Dimension | Valeur
Diamètre extérieur | 580 mm
Diamètre intérieur | 540 mm
Diamètre moyeu | 300 mm
Largeur totale | 365 mm
Épaisseur flasque | 40 mm
Épaisseur gorge | 120 mm
Masse | 48 kg

I_(menee) =1/2*48*(0.29^2 +0.27^2 )

I_(menee) =3.768 kg.m^2

Dimension | Valeur
Diamètre extérieur | 380 mm
Diamètre intérieur | 360 mm
Diamètre axe | 35 mm
Largeur totale | 375 mm
Rayon gorge | 20 mm
Largeur gorge | 285 mm
Masse | 20 kg

I_(motrice) =1/2*20*(0.19^2 +0.18^2 )

I_(motrice) =0.685 kg.m^2

R₁ = 150 mm = 0.15 m ; R₂ = 180 mm = 0.18 m

Rapport de Transmission :

r=(R2)/(R1)=0.18/0.15=1.2

Vitesse de roue freinage :

N_(menee) =(N_(moteur))/r=140/1.2=116.67 tr/min

ω_(menee) =116.67*(2π)/60=12.217 rad/s

Inertie menée ramenée sur l’arbre moteur :

I_(menee)^(ramenee) =I_(menee) *1/(r^2)=3.768/(1.2^2)=2.617 kg.m^2

Moment d’inertie totale :

I_(totale) =I_(menee)^(ramenee) +I_(motrice)

I_(totale) =0.685+2.617

I_(totale) =3.302 kg/m^2

alors le moteur a un reducteur de rapport1/10 le couple finale de moteur egale 51.16 N.m

donc =≫ M_(frottement) =M_(moteur) -I*α

M_(frottement) =51.16-(3.302*3.665)

M_(frottement) =39.06 N.m

Le force de vérin :

Le vérin est assemblé avec un patin de frottement pour éjecter l’usure en plateau de vérin. Ce patin en forme prismatique de longueur et largeur égale 45.5 mm avec un distance loin de centre de roue de 64 mm

R_(contact) =√((R/2)^2 +d^2) [ SEQ Équation \* ARABIC 18 ]

R_(contact) =√((45.5/2)^2 +64^2)

R_(contact) =67.92 mm=0.06792 m

F_f =(M_(freinage))/(R_(contact))=39.06/0.06792=574.9 N

Le contact de frottement se passe par deux matériaux diffèrent acier inoxydable/Ferro avec de coefficient de frottement μ=0.2

N_(verin) =(F_f)/μ=574.9/0.2=2874 N

Pression d’installation dans usine P=6 bars

Alors P=F/S ou S=(πd^2)/4 [ SEQ Équation \* ARABIC 19 ]

d= √(4*F/(Pπ)) [ SEQ Équation \* ARABIC 20 ]

d=√((4*2874)/(π*60000))=78 mm

→il faut choisir un verin avec diamatere de piston suprieur a 80 mm

→finalement j^(') ai choisi verin de type 'Festo DNC_80_125_PPV_A '

## 3.5 Conclusion :

Dans ce chapitre, j’ai rassemblé tous les calculs mécaniques essentiels pour dimensionner les éléments moteurs et de transmission du système. On a d’abord dimensionné les vérins, puis choisi et vérifié le moteur, calculé les poulies, et fini par évaluer la concentration des masses. Ces calculs ont permis de choisir des composants vraiment adaptés aux efforts réels et aux conditions de fonctionnement définies dans le cahier des charges. On remarque aussi que les résultats (couples, forces, inerties et rapports de transmission) restent cohérents entre eux, ce qui confirme qu’on tient une solution mécanique fiable. Toutes ces données dimensionnelles donnent une base technique solide pour la phase de conception, qu’on verra au prochain chapitre. Elles vont servir à modéliser le système dans SolidWorks et à établir les plans d’implantation de la solution définitive.

# CHAPITRE 4: Conception et élaboration sur la solution

## 4.1 Introduction :

Ce chapitre est consacré à la conception et au développement de la solution proposée, constituant le noyau technique du projet. Après avoir analysé les besoins et défini les exigences fonctionnelles dans les chapitres précédents, il s’agit maintenant de traduire ces spécifications en une solution concrète et réalisable, à la fois électriquement et mécaniquement.

La conception a été réalisée selon deux axes complémentaires et inséparables :

D’une part, la conception électrique, réalisée à l’aide du logiciel EPLAN, couvre la modélisation des schémas électriques, le câblage, la distribution de puissance et l’intégration des composants de contrôle et de puissance. Cette étape assure la cohérence, la sécurité et la conformité de l’architecture électrique de la solution.

D’autre part, la conception mécanique, développée sous SolidWorks, permet de définir la structure physique du système, les assemblages, les dimensions des pièces et leur disposition dans l’espace. Il assure la faisabilité de l’intégration des composants électriques au sein du châssis ou de l’armoire.

Enfin, une attention particulière est portée à la liste des composants à acquérir, établie à partir des deux études précédentes, afin d’orienter les choix d’approvisionnement en tenant compte des contraintes techniques, de la disponibilité et des coûts.

L’objectif global de cette approche est de produire une conception fiable et documentée qui peut être utilisée directement pour la phase de mise en œuvre.

## 4.2 Conception mécanique :

La conception mécanique ce fait par SolidWorks pour faire la conception de diffèrent composantes de machine apex à l’aide de Equipment de mesure comme pied a coulisse pour dimensionner chaque pièce et le redessiner sur le logiciel à cause de la anciennement et manquant de mises en plans de machine. la conception suivante est la reconception de machine en son version zéro avant la rénovation

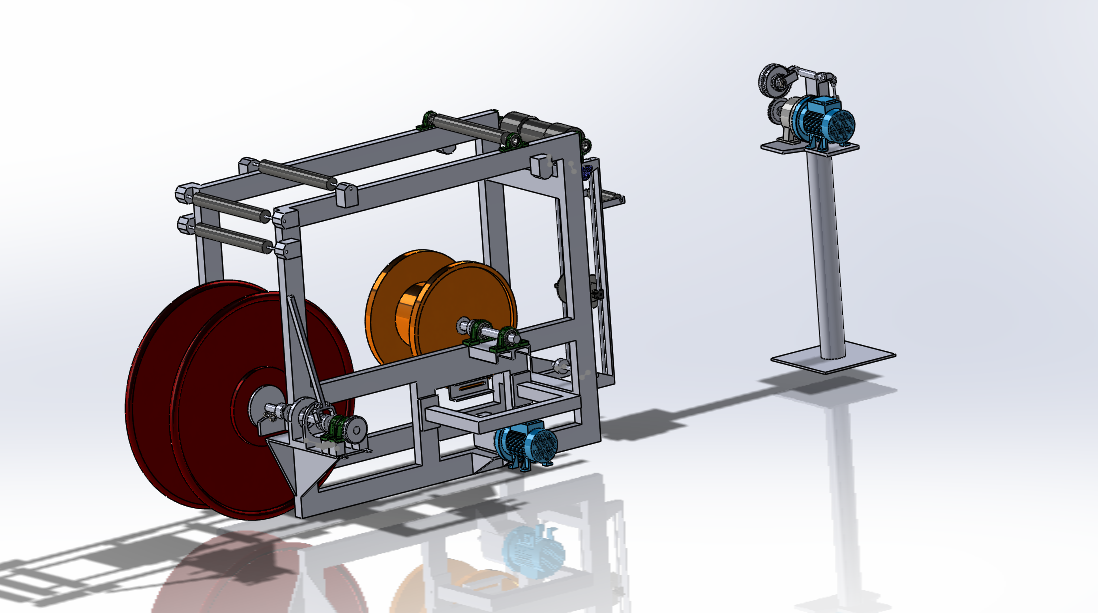
[picture p27: figure]

Figure 17:la reconception de machine apex

### 4.2.1 Les défauts mécaniques de machine Ancient :

Il y a 2 grandes défauts mécaniques dans la machine apex :

- Rouleau apex : Coincement rouleau d’apex lors de transmission par l’attirer inaliéné par l’opérateur fait un stoppage tout à coup du système. Ce rouleau a un capteur de contact lors d’attirer de l’apex cette rouleau va monter qui effectuer une un contact avec le capteur qui excité le moteur pour tourner.

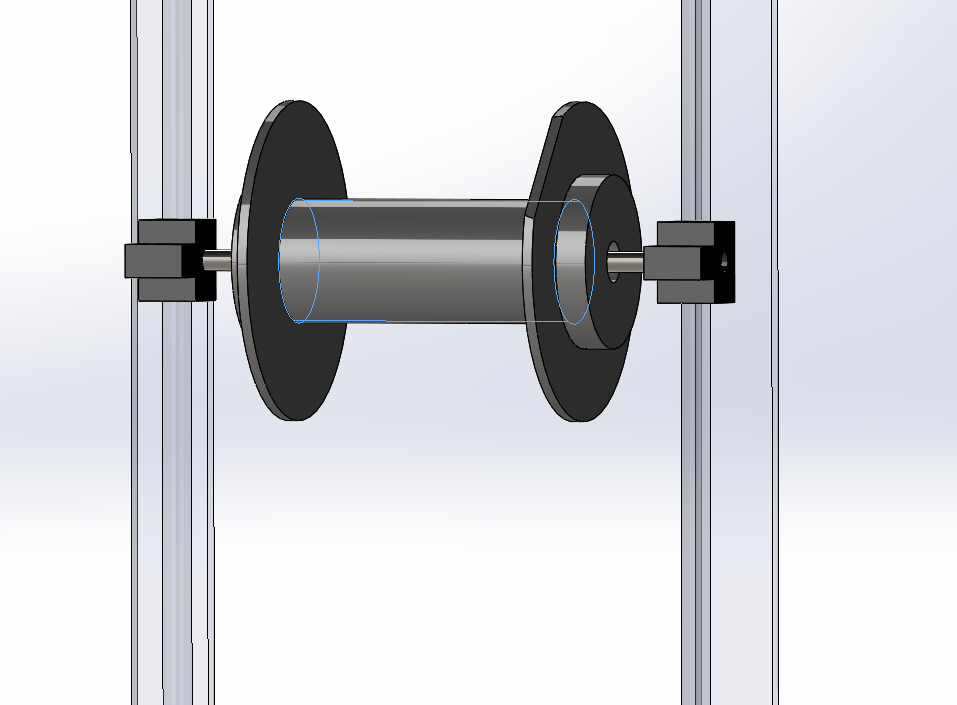
[picture p28: figure]

Figure 18:rouleau d'apex

- Système de freinage : ce système fait un freinage manuel de la bobine d’apex pour résister leur mouvement de rotation de but ne rejeter pas le produit apex. Ce système ne pas faire un freinage complet ou n’est freinée pas dans certains cas a cause de l’usure de son piston et le frottement interne par ses arbres.

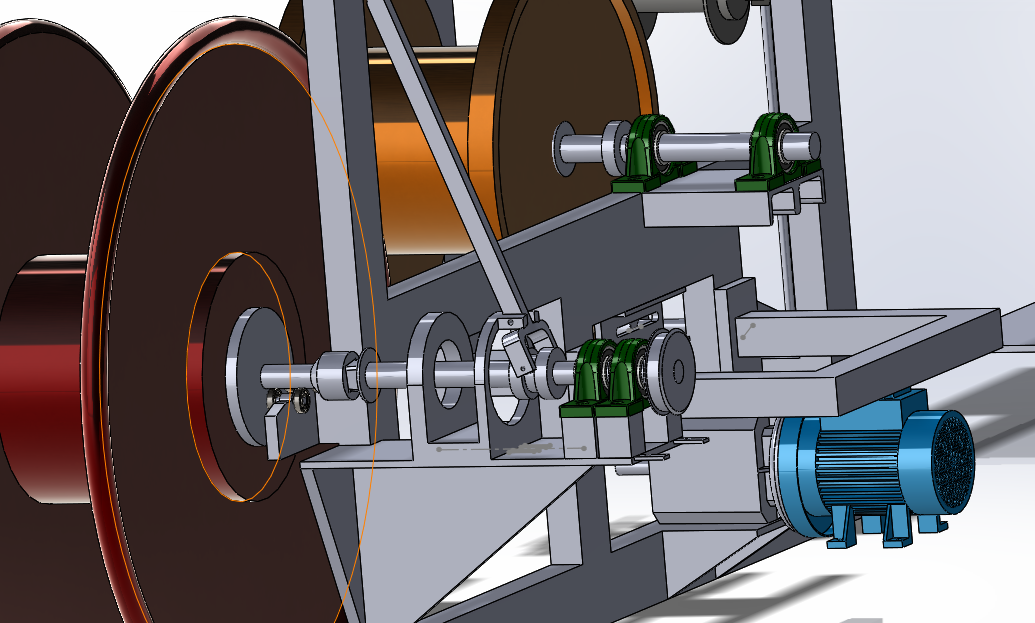
[picture p29: figure]

Figure 19:systeme de freinage Ancient

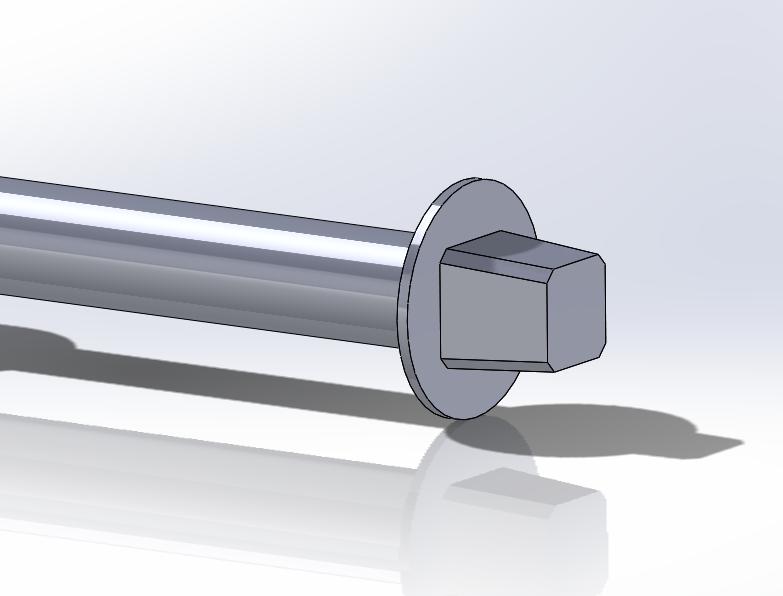
[picture p30: figure]
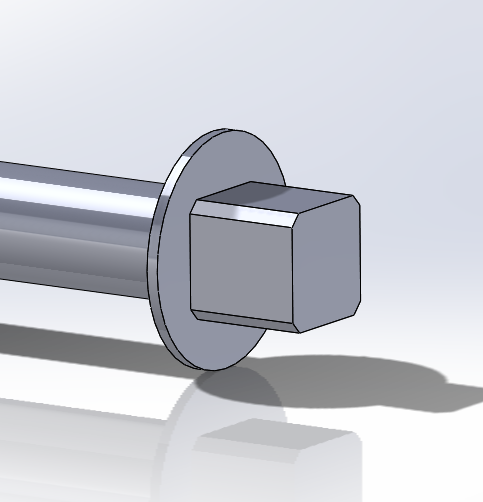
[picture p31: figure]

Usure

Forme originale

Figure 20:usure du piston de freinage

### 4.2.2 Les solutions mécaniques proposées :

- Levier rotatif : Le levier rotatif est un mécanisme de guidage et de serrage constitué d'un bras articulé autour d'un axe de rotation fixé sur le bâti de la machine. Dans le cadre de la rénovation de la machine Apex tourisme, il remplace le système de guidage existant défaillant en assurant le maintien et le serrage de la bande Apex contre la tringle lors de l'opération d'assemblage.

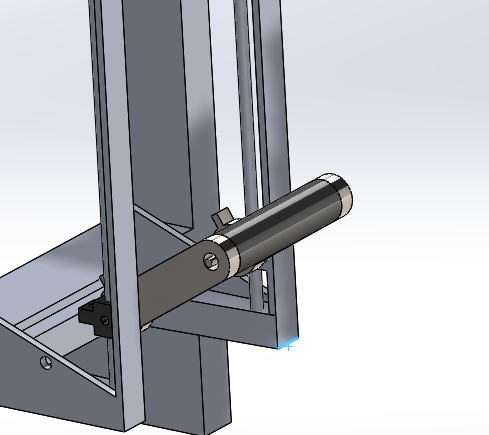
[picture p32: figure]

Figure 21:levier rotatif

- Système de freinage pneumatique (vérin) : Le système de freinage pneumatique est la solution retenue pour remplacer le mécanisme de freinage manuel ancien (D1) qui présentait une usure excessive de son piston et un freinage insuffisant ou inexistant dans certains cas de fonctionnement. Il est constitué d'un vérin pneumatique double effet Festo DNC-80-125-PPV-A (diamètre d'alésage 80 mm, course 125 mm) associé à un patin en matériau Ferro fixé à l'extrémité de la tige du vérin. Ce patin vient exercer une force de frottement contrôlée sur la roue de la bobine Apex pour résister à son mouvement de rotation et éviter le rejet incontrôlé du produit lors de l'arrêt du moteur principal MS2.

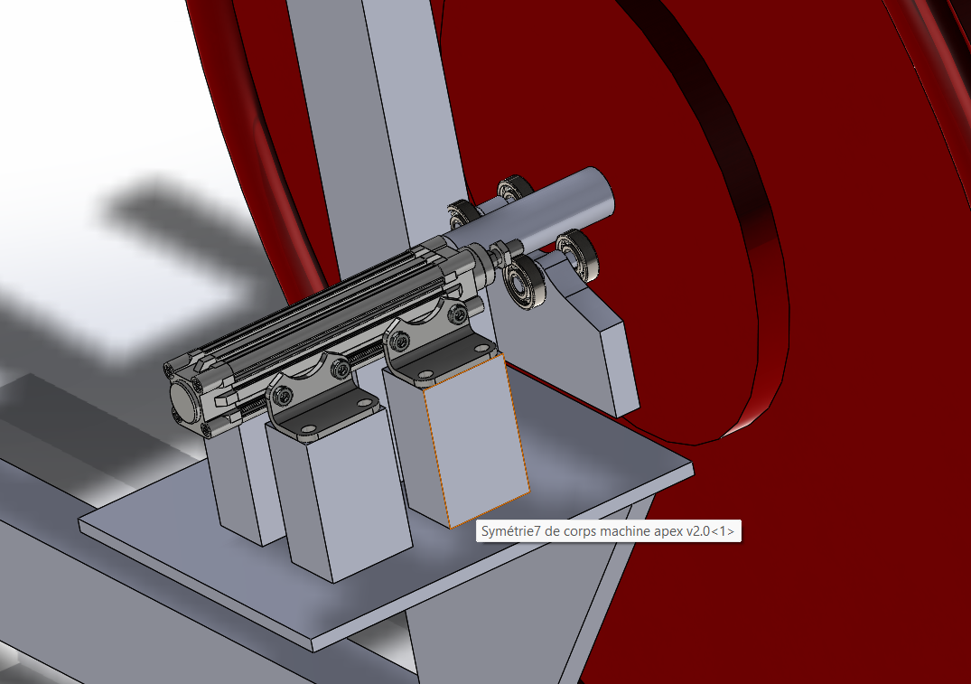
[picture p33: figure]

Figure 22:système de freinage pneumatique

## 4.3 Appareillage :

Afin d’améliorer le fonctionnement de notre machine et de renforcer sa fiabilité,

Nous envisageons d’ajouter les équipements suivants : capteurs, alimentation électrique, protection, Commande, actionneur, pré-actionneur …

### 4.3.1 Les captures :

Capteur de proximité inductif : Un capteur de proximité inductif NPN est un capteur électronique capable de détecter la présence d’un objet métallique sans contact physique. Il fonctionne grâce à un champ électromagnétique généré par son côté sensible. Lorsqu’un objet métallique pénètre dans la zone de détection, le champ électromagnétique est perturbé et le capteur modifie l’état de sa sortie électrique.

Le terme NPN signifie que la sortie du capteur est de type collecteur ouvert NPN (enfonçage). Lorsque le capteur détecte un objet, il relie sa sortie au potentiel 0 V (masse).

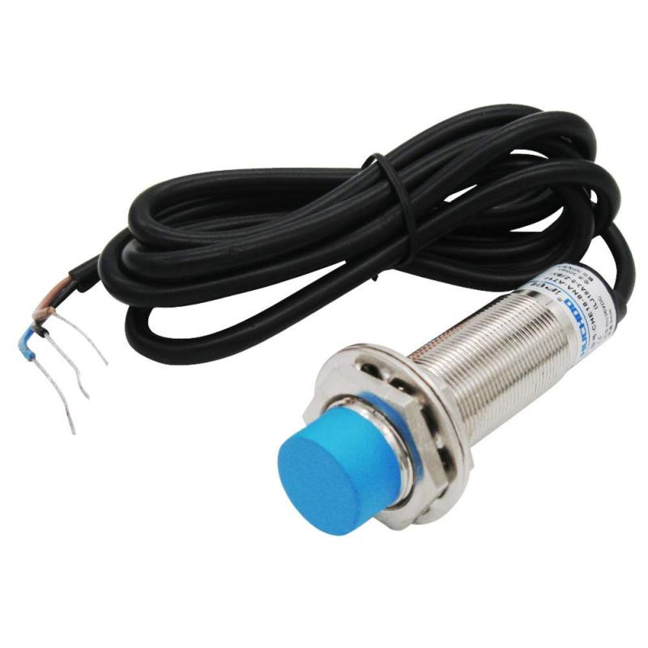
[picture p34: figure]

Figure 23:capteur de proximité NPN

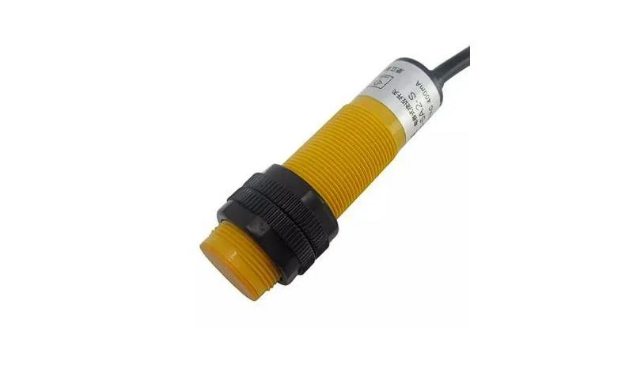
[picture p35: figure]

Capteur de proximité capacitif : Un capteur de proximité capacitif est un capteur électronique capable de détecter la présence ou l’approche d’un objet avec ou sans contact, en mesurant la variation de capacité électrique créée par l’objet dans son champ électrique. Le capteur crée un champ électrique devant son côté sensible. Lorsqu’un objet entre dans cette zone, la capacité électrique du système change. L’électronique interne détecte cette variation et commute la sortie du capteur

Figure 24:CJM18M-8A1 capteur de proximité capacitif

### 4.3.2 Dispositifs de commandes :

Automate programmable (API) :

Le Siemens S7-1211C DC/DC/DC est un automate programmable industriel compact utilisé pour le contrôle et l'automatisation des machines industrielles.il offre 6 entrées numériques, 2 analogiques et 4 sorties numériques avec deux sorties du train d’impulsions (PTO) pour le contrôle des moteurs pas à pas et des servomoteurs. Communication Ethernet intégrée (Profinet).

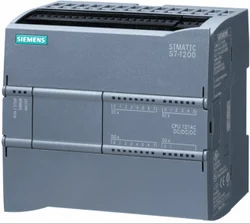
[picture p36: figure]
6ES7214-1AG40-0XB0 Siemens S7-1200, CPU 1214C, DC/DC/DC

Figure 25:Siemens S7-1211C DC/DC/DC

Carte de développement STM32 :

Le STM32F103 est un microcontrôleur 32 bits basé sur l'architecture ARM Cortex-M3 développé pour la commande intelligente des systèmes son bute dans ce projet est commandée les moteurs pas à pas car Le S7-1211C possède seulement 2 sorties PTO intégrées.

Figure 26:microcontrôleur STM32F103

### 4.3.3 Les actionneurs :

Verin double effet :

Le vérin Festo DNC-80-125-PPV-A à double effet est un actionneur Avec un diamètre d'alésage 80mm qui produit un mouvement linéaire bidirectionnel (extension et rétraction) en utilisant la pression d’un fluide (huile ou air) appliqué alternativement des deux côtés du piston. Contrairement au vérin à simple effet, qui dépend d’un ressort ou de la gravité pour le retour, le vérin à double effet offre un contrôle précis et une force constante dans les deux directions.

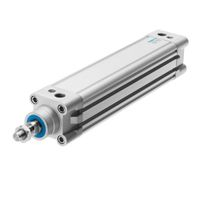
[picture p37: figure]

Figure 27:verin Festo DNC-80-125-PPV-A

Moteur pas à pas NEMA 17 avec réducteur :

Le moteur pas à pas NEMA 17 est un actionneur électromécanique qui convertit les impulsions électriques en mouvements angulaires précis. Il est largement utilisé dans les systèmes automatisés nécessitant un contrôle précis de la position et de la vitesse. C’est un excellent choix pour les applications qui nécessitent une bonne précision mais à faible coût parce que le réducteur de la série MG intègre un accouplement d’arbre, vous pouvez facilement changer le moteur ou le réducteur.

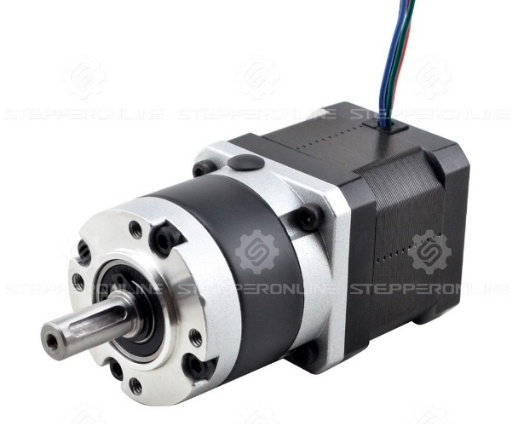
[picture p38: figure]

Figure 28:moteur pas à pas 17HS15-1584S-MG10

### 4.3.4 Les Pré-actionneurs :

Électrovanne 33w :

Électrovanne est un dispositif électromécanique pour contrôler l’ouverture ou la fermeture d’un flux de fluide (air, eau, huile, etc.) à l’aide d’un signal électrique. Le nombre 33W indique que la bobine consomme 33 watts. L’énergie électrique lorsqu’elle est activée.

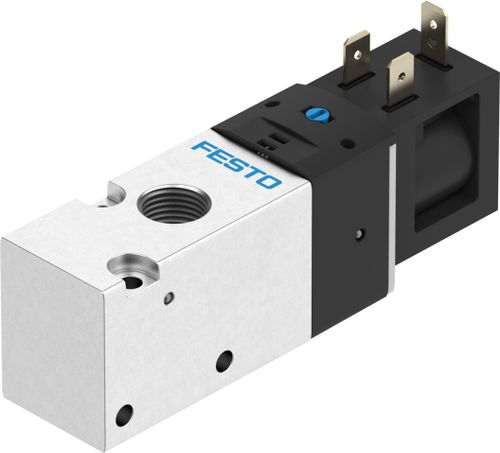
[picture p39: figure]
VUVS-LK25-M32C-AD-G14-1B2-S

Figure 29:electrovanne Festo VUVS-LK25-M32C-AD-G14-1B2-S

Variateur de moteur pas à pas :

Le TB6600 est un contrôleur de moteur pas à pas bipolaire (2 phases) professionnel conçu pour entraîner des moteurs de puissance tels que NEMA 17, 23 et 34. Son rôle principal est de recevoir des signaux de commande numériques (impulsion et direction) d’un microcontrôleur et de fournir le courant nécessaire au moteur.

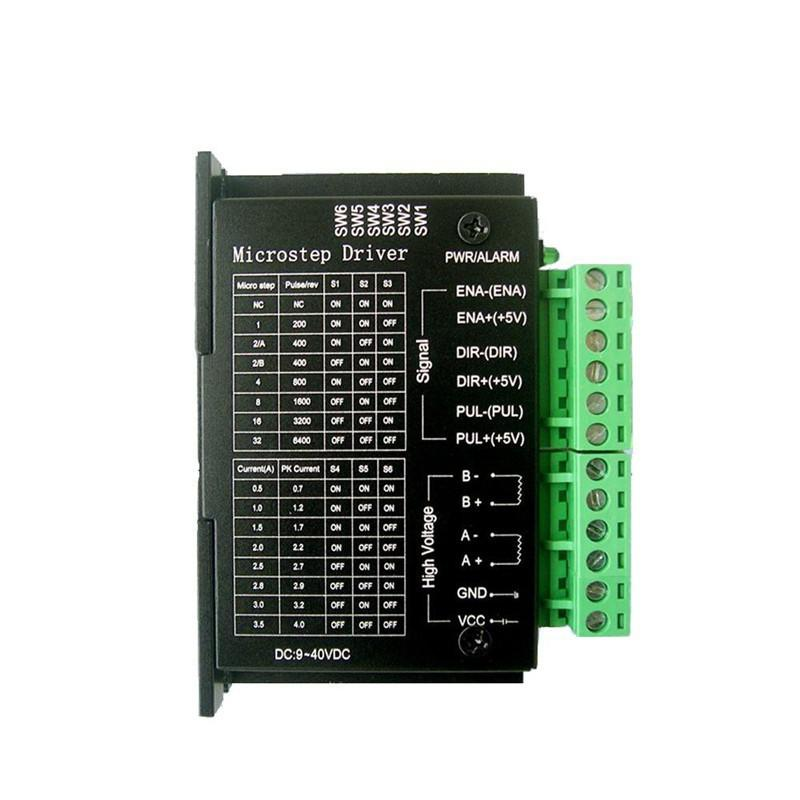
[picture p40: figure]

Figure 30:variateur de moteur pas à pas TB6600

### 4.3.5 Cartes de communication :

CB1241 : Le CB1241 est une carte de communication RS485 (Communication Board) fabriquée par Siemens, conçue spécifiquement pour les CPU S7-1200. Il ajoute un port série RS485 physique au CPU S7-1211C qui n'en possède pas nativement. Il se branche directement sur le dessus du CPU dans le slot prévu à cet effet. Le S7-1211C n'a pas de port RS485 intégré. Le CB1241 lui permet de communiquer en Modbus RTU avec le STM32.

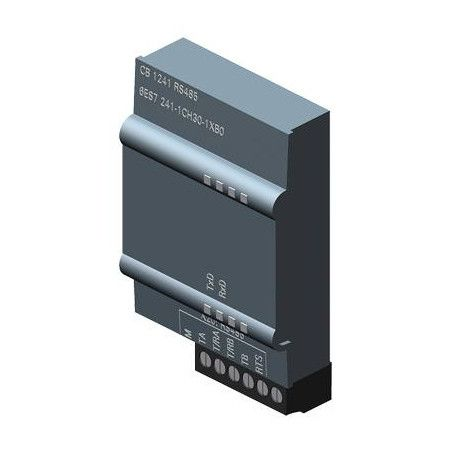
[picture p41: figure]
Moduł CB 1241, RS485

Figure 31:carte de communication RS485

MAX485 : Le MAX485 est un circuit intégré transceiver RS485 fabriqué par Maxim Integrated. Il convertit un signal UART logique (TX/RX) en signal différentiel RS485 (A+/B−) et vice versa. Il joue le rôle d'adaptateur de protocole et de niveau de tension. Le STM32F103 communique nativement en UART (3.3V logique) mais ne peut pas piloter directement un bus RS485 industriel.

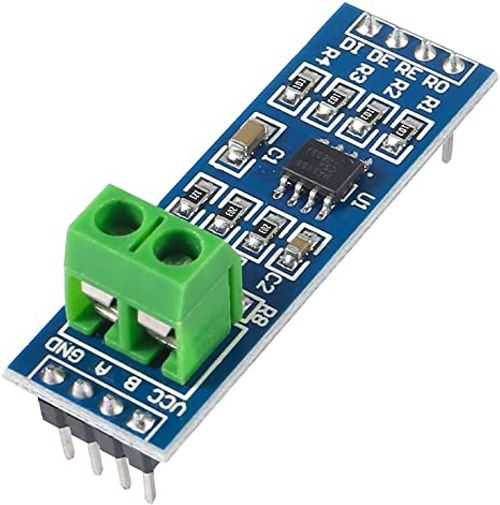
[picture p42: figure]
5PCS MAX485 RS485 Transceiver Module TTL UART Serial to RS485 Instrument Interface Module Max458 Chip RS-485 Communication Transceiver 5V SCM Development Accessories Board for Raspberry Pi - SunFounder

Figure 32:circuit intégré transceiver MAX485

## 4.4 Principe de fonctionnement :

Le principe de fonctionnement de système s’effectuer selon 3 modes qui présente par 3 buttons MPN (mode production normal), MM (mode manuelle) et MA (mode automatique) on a deux voyants qui signifie que le machine en marche MAS ou en arrête MAN.

Mode automatique : l’opération commence après l’mise en marche de machine et avant l’appuie sur Button de mode a choisi MA dans notre cas par place de tissu dans la roue moteur et attirer la ligne apex à assembler jusqu’à a la partie semi-automatique qui contient les deux bras en forme ciseau amenée chaque rouleau de rotation, adaptée sur la largeur de apex sélectionnée.

Après l’appuie sur MA et la présence d’apex par le capteur capacitif CAP1. Les deux rouleaux ferment sur le produit (apex) par le moteur pas à pas M3. Le plateau d’accrochement apex (semi-automatique) commence a avancé grâce motrice pas à pas M2 jusqu’à une distance déterminée pour coller l’extrémité d’apex afin de touche un couteau chaud commande par un moteur pas à pas M4. Afin de collage sur de l’apex sur poulie et la déclenche de temporisateur temp2 l’ouvrir de rouleaux d’accrochage et lorsque le plateau revenir à son position précèdent les rouleaux raccrocher sur l’apex pour guide la transmission d’apex.

Après le collage de apex sur la poulie de moteur de rotation 1 MS1(moteur asynchrone) simultanée avec le verin1qui démente la poulie haut a l’apex pour guide son trajectoire sur tringle le moteur pas a pas M1 qui actionnée montage du la levier rotatif pour devient sans contact avec la capteur indicatif CAP2 alors cette étape actionner la rotation de moteur de rotation 2 MS2 (moteur principale) qui guider la rotation de bobine apex pour aider l’envoie de l’apex à la position d’accrochage.

Après certain temp compter par le temporisateur temp1 les moteurs M1, MS1, MS2 s’arrêtent et le boucle se répéter.

Remarque : lorsque le moteur principal MS2 s’arrête simultanée le vérin 2 de freinage sorti pour freiner la bobine d’apex et rendre en position initiale quand le moteur revient a tournée

Mode manuelle : cette mode est une décomposition de chaque action se faire en mode automatique pour faciliter le test et la maintenance de système ou bien l’accès à la certaine étape a problème de fonctionnement.

-appuie sur le button MD11 pour permet d’exécuter la moteur principale MS1 à tourner dans le sens1 et MD12 pour le sens 2.

-appuie sur le button MD21 pour permet d’exécuter la moteur MS2 à tourner dans le sens1 et MD22 pour le sens 2.

-appuie sur le button M1+ (rouleau tourne dans sens 1) qui permet de tourner le moteur M1 dans le sens 1 et M1- dans le sens contraire.

-appuie sur le button F1 qui permet de fermer les deux bras et F2 dans le sens contraire.

-appuie sur le button A1 qui permet de l’avance de plateau et A2 dans le sens contraire.

-appuie sur le button C1 pour sortie de couteau chauffant et C2 dans le sens contraire.

-VF1 pour sortie le vérin 2 de freinage et VF2 pour revenir à sa position initiale.

-V1 pour sortie le vérin 1 et V2 pour revenir à sa position initiale.

Mode production normale : ce le mode de fonctionnement similaire a l’Ancient de système avant la rénovation de système. Ce un mode facile permet de tourner le moteur MS2 lorsque la CAP2 ne détecte pas la levier rotatif (levier montée) Et appuie sur le bouton MD11(pour tourner MS1) lorsque l’opérateur lisser avec le couteau chauffant séparée et collage l’apex sur poulie de MS1.

-clique sur V1 fait sortie le vérin 1 pour descende sur le tringle et V2 pour revenir à sa position initiale.

Tableau 24:tableau les sorties physiques d'API

| Les composantes | Symbole | Adresse | Type
Sorties | Moteur MS1 tourne dans sens 1 | MS11 | | Bool
| Moteur MS1 tourne dans sens 2 | MS12 | | Bool
| Moteur MS2 tourne dans sens 1 | MS21 | | Bool
| Moteur MS2 tourne dans sens 2 | MS22 | | Bool
| Sortie Verin1 | EV11 | | Bool
| Retour Verin1 | EV12 | | Bool
| Sortie Verin de freinage | EV21
| Retour Verin de freinage | EV22 | | Bool
| Bouton MS2 sens2 | MD22
| Lampe mode automatique | LA | | Bool
| Lampe mode manuel | LM | | Bool
| Lampe mode production normale | LPN | | Bool
| Lampe mise en marche | Ldcy | | Bool
| Lampe arrête d’urgence | ALR | | Bool

Tableau 25:tableau les entrées physiques d'API

| Les composantes | Symbole | Adresse | Type
Entrées | Bouton mise en marche | m1 | | Bool
| Bouton mode automatique | MA | | Bool
| Bouton mode manuel | MM | | Bool
| Bouton mode production normale | MPN | | Bool
| Bouton d’urgence | URG | | Bool
| Bouton amène d’apex (MS1 sens1) | MD11 | | Bool
| Bouton MS1 sens2 | MD12
| Bouton MS2 sens1 | MD21 | | Bool
| Bouton MS2 sens2 | MD22
| Bouton rouleau sens1 | M1+ | | Bool
| Bouton rouleau sens2 | M1-
| Bouton fermeture de bras | F1 | | Bool
| Bouton ouverture de bras | F2
| Bouton l’avancement de plateau | A1 | | Bool
| Bouton revenir de plateau | A2
| Bouton montant de couteau | C1 | | Bool
| Bouton descendent de couteau | C2
| Bouton freinage | VF1 | | Bool
| Bouton lèchement de freinage | VF2
| Bouton sortie verin1 | V1 | | Bool
| Bouton position initiale verin1 | V2
| Capture de présence apex | CAP1 | | Bool
| Capture de contact levier | CAP2 | | Bool

- Grafcet point de vue système : représente le comportement global et structuré d’un système automatisé, indépendamment des détails d’implémentation. Il décrit les états (ou phases) que traverse le système et les conditions de passage entre ces états

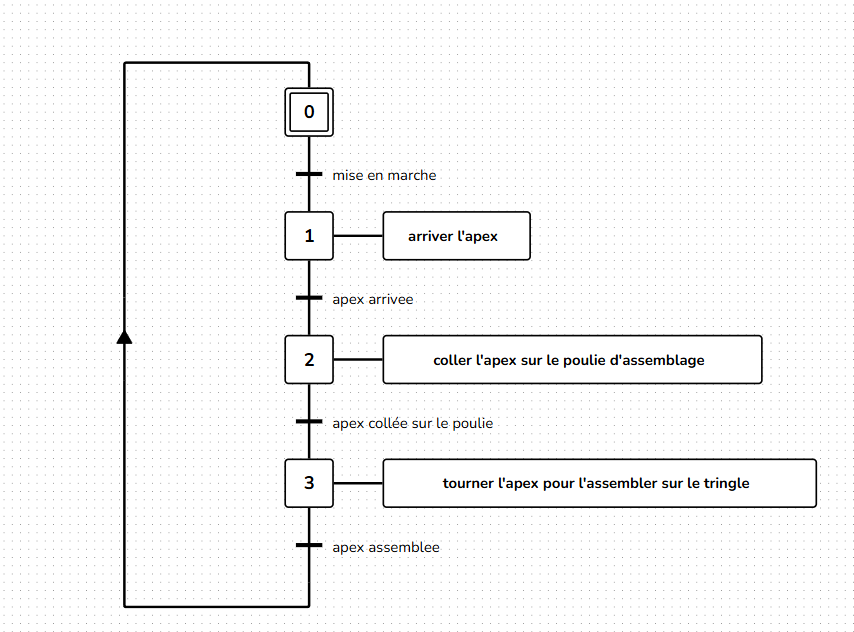
[picture p43: figure]

Figure 33:Grafcet point de vue système pour Mode Automatique

## 4.5 Schema électrique :

La conception électrique de système fait en but d’organisée les entrées et les sorties de système pour faciliter l’application en programmation automatisme et le câblage entre les composantes réellement.

# CHAPITRE 5: Automatisation de système

## 5.1 Introduction :

Dans le cadre de la rénovation de la machine d'application Apex tourisme STIP-AMINE, l'automatisation constitue l'objectif central de ce projet. L'analyse fonctionnelle du chapitre précédent a mis en évidence les limites du système semi-manuel existant manque de précision, faible répétabilité et risques pour l'opérateur justifiant le passage à une architecture de commande automatisée. L'architecture retenue repose sur trois niveaux complémentaires. L'automate Siemens S7-1211C, programmé en Ladder sous TIA Portal, assure la logique de séquençage et le traitement des capteurs. Le microcontrôleur STM32F103, programmé en C++, génère les signaux de commande précis pour les quatre moteurs pas à pas NEMA17 via ses timers hardware, compensant la limitation du PLC en sorties PTO. La communication entre les deux est assurée par le protocole Modbus RTU sur RS485 via le module CB1241.

Ce chapitre détaille la conception logicielle de cette architecture, depuis la configuration Modbus jusqu'à la programmation des blocs fonctionnels PLC et du firmware STM32.

## 5.2 Objectifs de l’automatisation :

Améliorer la précision de l'application Apex : Remplacer les réglages manuels par des moteurs pas à pas NEMA17 commandés par le STM32F103, garantissant un positionnement répétable au dixième de millimètre lors de l'enroulement de la bande Apex sur la tringle.

Assurer la répétabilité des cycles de production : Le S7-1211C exécute un programme Ladder structuré en blocs fonctionnels FB, garantissant que chaque cycle — détection Apex, fermeture des rouleaux, avancement du plateau, collage, rotation — s'effectue de manière identique et indépendante de l'opérateur.

Réduire le temps de cycle : L'automatisation des séquences de mouvement (M1, M2, M3, M4, MS1, MS2) et des actionneurs pneumatiques (vérin de guidage, vérin de freinage) permet d'enchaîner les opérations sans temps d'attente lié à l'intervention humaine.

Améliorer la sécurité de l'opérateur : L'intégration d'un bouton d'urgence (URG), de capteurs de position (CAP1, CAP2) et d'une logique de surveillance dans le PLC permet de détecter toute anomalie et d'arrêter la machine immédiatement en cas de danger.

Faciliter la maintenance et le diagnostic : Le mode manuel (MM) permet d'actionner chaque composant individuellement pour le test et la maintenance. Le diagnostic en temps réel via TIA Portal.

Optimiser le coût de la solution : L'architecture S7-1211C + STM32F103 retenue offre les performances d'un système de commande pour un coût inférieur à une solution Siemens pure (S7-1214C + HMI Siemens), tout en conservant la fiabilité industrielle requise.

## 5.3 Présentation de l’automate programmable industriel API :

L’automate programmable industriel A.P.I (Programmable Logic Controller PLC) est un appareil électronique programmable. Il est défini suivant la norme Française EN-61131- 1, adapté à l'environnement industriel, et réalise des fonctions d'automatisme pour assurer la commande de pré-actionneurs et d'actionneurs à partir d'informations logiques, analogiques ou numériques. C’est aujourd’hui le constituant essentiel des automatismes.

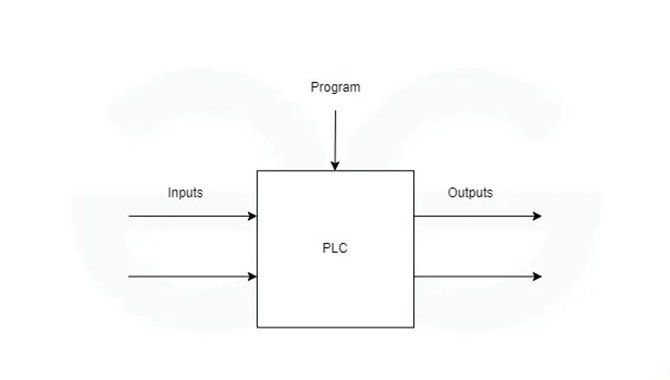
[picture p44: figure]
comment-fonctionne-un-automate-plc

Figure 34:Concept d'un API

### 5.3.1 Structure d’un automate programmable industriel :

Les API comportent quatre principales parties :

- Une unité de traitement (un processeur CPU).

- Une mémoire.

- Des modules d’entrées-sorties.

- Des interfaces d’entrées-sorties.

- Une alimentation 230 V, 50/60 Hz (AC) - 24 V (DC).

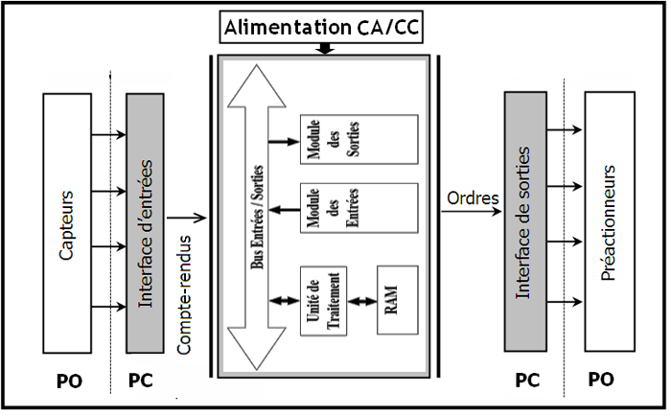
[picture p45: figure]
Structure interne d'un automate programmable industriel (API)

Figure 35:Structure Interne d'un Automate Programmable

## 5.4 Programmation avec STEP7-TIA Portal :

TIA Portal (Totally Integrated Automation Portal) est la plateforme logicielle de Siemens dédiée à la programmation et à la configuration des automates programmables industriels de la gamme S7-1200/1500. Il intègre dans un environnement unique la programmation en langages normalisés IEC 61131-3 (Ladder, FBD, SCL), la configuration matérielle, la gestion des communications et le diagnostic en ligne. Dans le cadre de ce projet, TIA Portal est utilisé pour programmer le S7-1211C en langage Ladder, configurer le module de communication CB1241 en Modbus RTU et développer les blocs fonctionnels FB assurant le séquençage automatique de la machine Apex tourisme.

### 5.4.1 Élaboration du programme :

- Création d’un projet STEP7 : Pour réaliser une tâche d'automatisation au sein d'un gestionnaire de projets, vous devez d'abord créer un nouveau projet :

- Choisissez la commande ‘Créer un projet’.

- Tapez le nom du projet et choisi le chemin d’enregistrement.

- Cliquez sur le bouton "Créer" pour créer le projet.

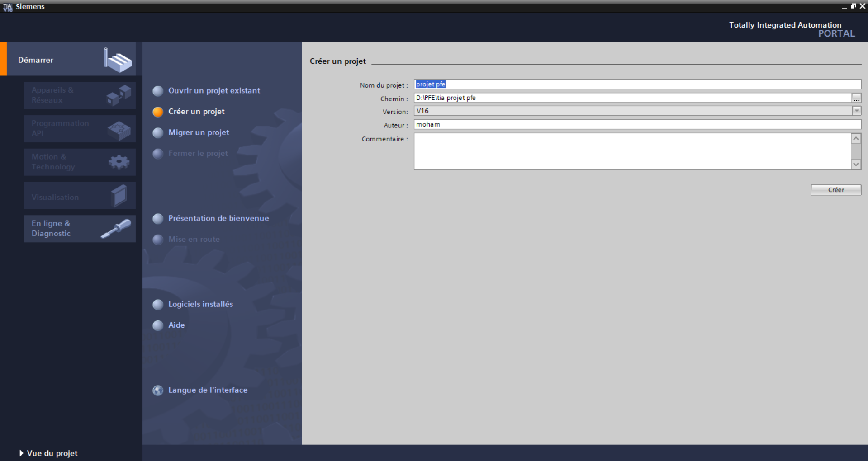
[picture p46: figure]

Figure 36:création d'un projet

- Choix de l’automate : Le choix d'un automate programmable industriel (API) est conditionné par les exigences de la partie commande à programmer. Plusieurs critères ont guidé cette sélection :

-Le nombre d'entrées/sorties nécessaires pour piloter l'ensemble des actionneurs et traiter les signaux capteurs de la machine.

-Le temps de traitement suffisant pour assurer le séquençage en temps réel des cycles de production.

-La capacité mémoire pour stocker le programme Ladder, les blocs fonctionnels FB et les données de communication Modbus.

-La possibilité d'ajouter des modules de communication, notamment le module CB1241 pour assurer la liaison RS485 Modbus RTU avec le STM32F103.

Pour la commande et le contrôle de notre machine Apex tourisme STIP-AMINE, nous avons retenu l'automate Siemens S7-1211C DC/DC/DC, qui répond à l'ensemble de ces critères. Il dispose de 6 entrées numériques, 4 sorties numériques, 2 entrées analogiques et 2 sorties PTO intégrées pour le pilotage direct des moteurs pas à pas. Sa connectivité PROFINET intégrée permet la communication avec l'interface homme-machine

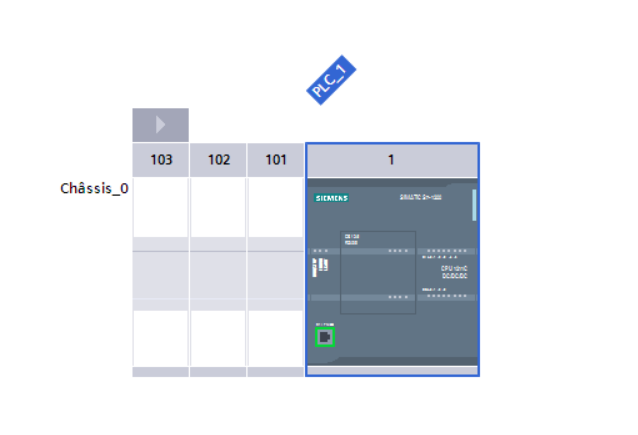
[picture p47: figure]

Figure 37:vue de face de CPU

- Configuration matérielle : Après avoir créé le projet, un appui sur « vue du projet » et on passe à l'importation de matériel :

- Double clique sure « ajouter un appareil ».

- Dans "contrôleur" choisi l’API à utiliser.

- Cliquez sur le bouton "ok" pour valider.

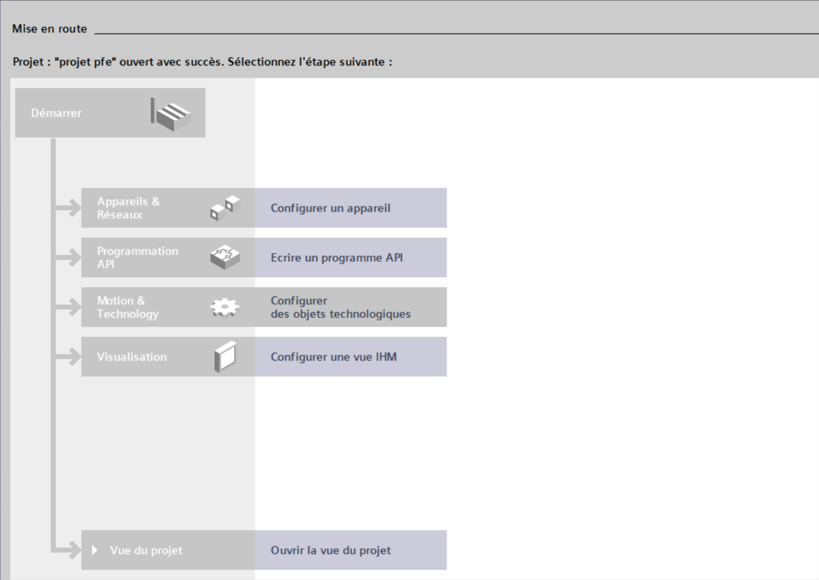
[picture p48: figure]

Figure 38:ouvrir la vue de projet

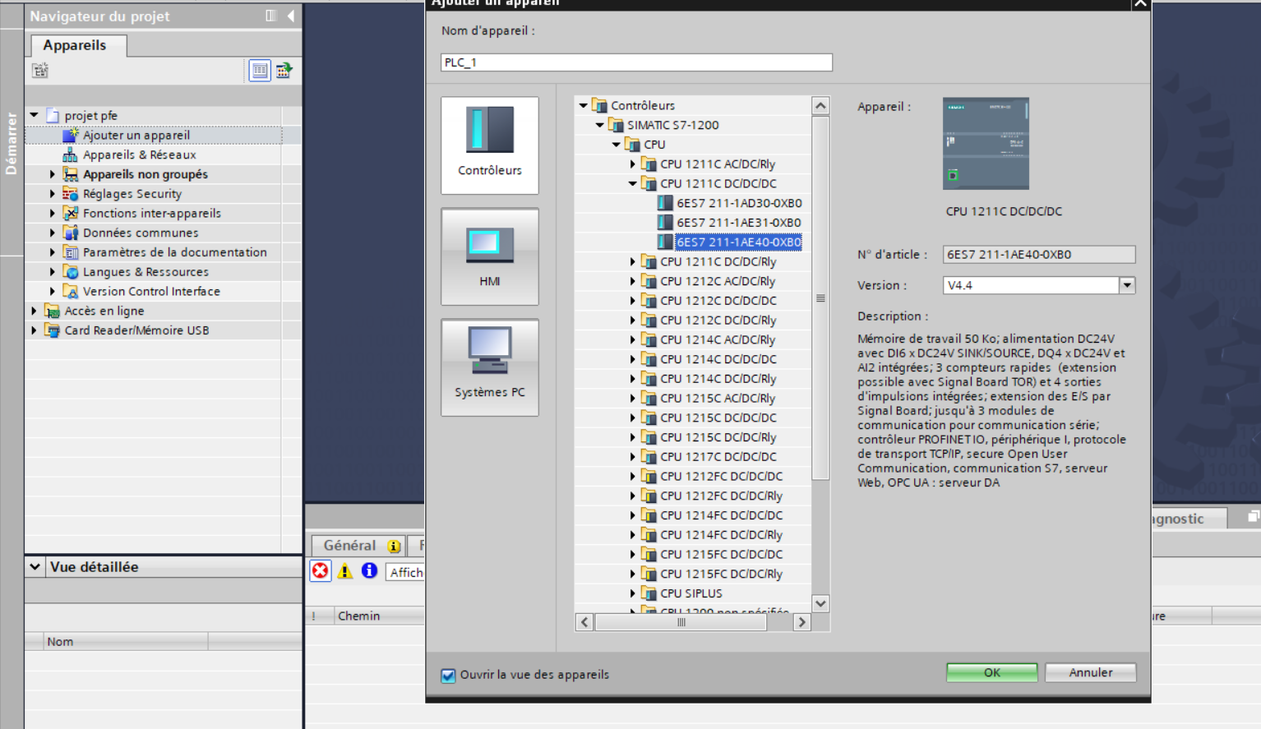
[picture p49: figure]

Figure 39:configuration de l'API

- Ajouter une carte communication : on va ajouter le carte communication CB1241 a cause de limitation des portes PTO (2 PTO dans s7-1211C) on va assembler le carte CB pour acter comme un pont intermédiaire entre API et le carte STM32 qui commander les moteurs pas à pas.

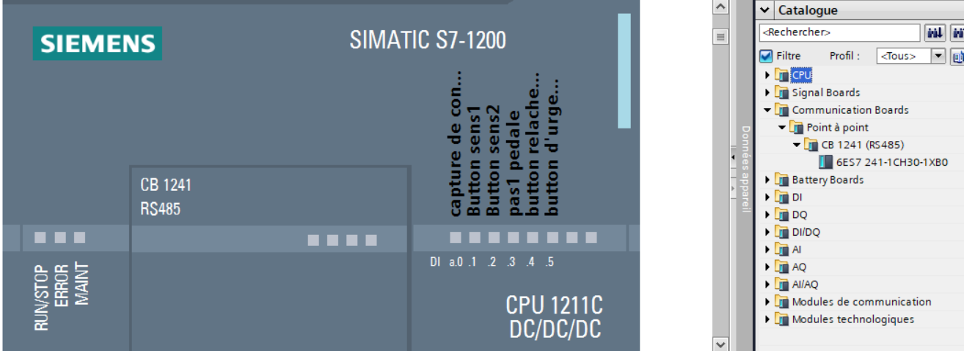
[picture p50: figure]

Figure 40:ajoutation de carte du communication CB1241

Figure 41:concept de carte CB1241

## 5.5 Développement de programme :

Afin de développer notre programme d’une façon organisée et compréhensive, nous avons divisé notre projet en plusieurs fonctions.

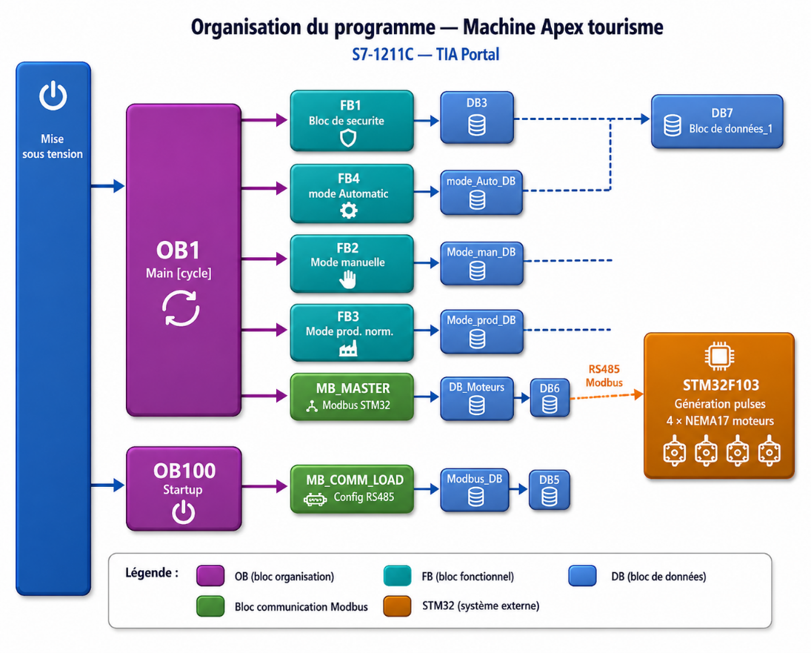
[picture p51: figure]

Figure 42:Organisation du programme

### 5.5.1 Le Bloc MAIN (OB1) :

Le bloc OB1 est souvent appelé Main, c’est un bloc organisationnel principal à exécution cyclique. Normalement, c’est un bloc qui nous permet de faire appel aux autres blocs suivants :

- FC : Un FC (Fonction) est un bloc de programme qui exécute une tâche spécifique et renvoie un résultat. Les fonctions ne conservent pas d'état entre les appels (elles sont sans état), ce qui signifie qu'elles ne mémorisent pas les valeurs de leurs variables locales une fois l'exécution terminée.

- FB : Un FB est un bloc de programme qui peut contenir des données persistantes, ce qui lui permet de conserver des états entre les appels. Cela est utile pour des tâches qui nécessitent de mémoriser des informations entre les cycles de programme.

- DB : Un DB est une zone de mémoire réservée dans le PLC pour stocker des données. Il peut contenir différentes variables de types de données variés (BOOL, INT, REAL, STRING, etc).

### 5.5.2 Le fonction mode automatique (FB4) :

Elle contient des conditions initiales nécessaires au démarrage de cycle. Pour commencer il faut appuie premièrement sur le bouton de mise en marche m1 et bouton mode automatique MA

Et il faut les 2 autre modes sont non active avec l’absence de l’activation d’urgence (si elle active tous les modes sont coupent)

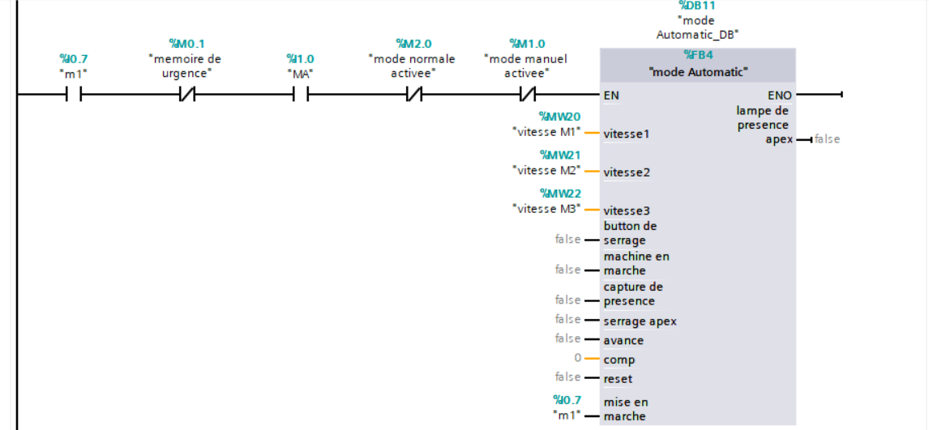
[picture p52: figure]

Figure 43:Capture illustrative de la fonction production appelé dans OB1

### 5.5.3 Le fonction mode manuelle (FB2) :

Cette mode contient les mêmes conditions initiales pour le FB4

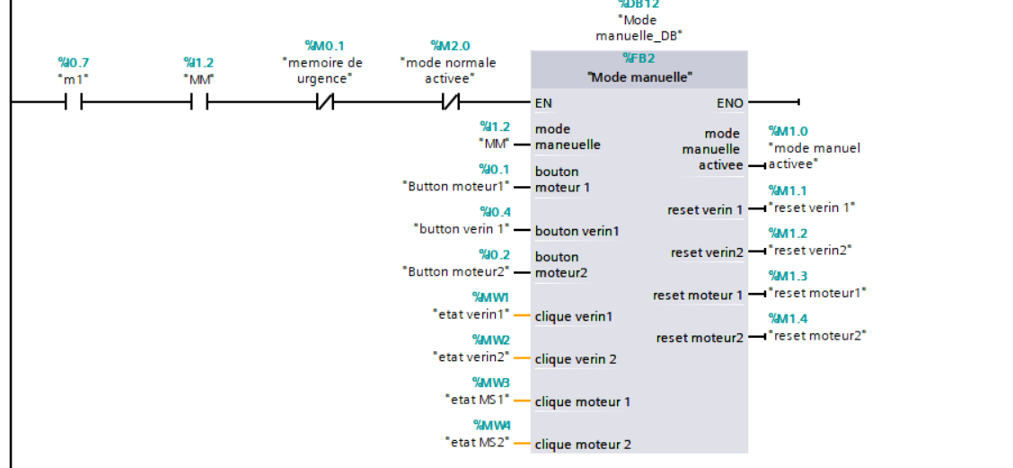
[picture p53: figure]

Figure 44:: Capture illustrative de la fonction action FB2 appelé dans OB1

Il contient possibilité de tester chaque composante et chaque fonction séparée

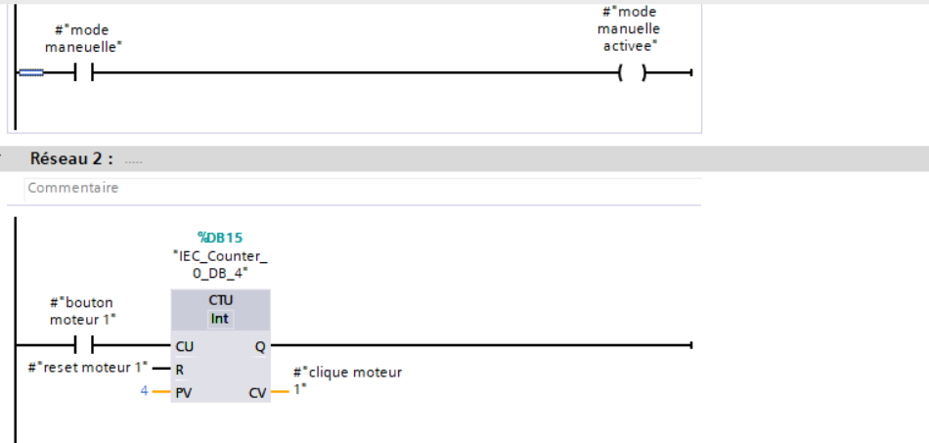
[picture p54: figure]

Figure 45:capture pour l'allumage de mode appuie par bouton

Pour réduire les nombres des buttons entrant et aussi faciliter la commande par l’opérateur nous décident pour applique un seul bouton pour chaque actionner ; Appuie 1(marche), Appuie 2 (arrête), Appuie 3 (marche contraire).

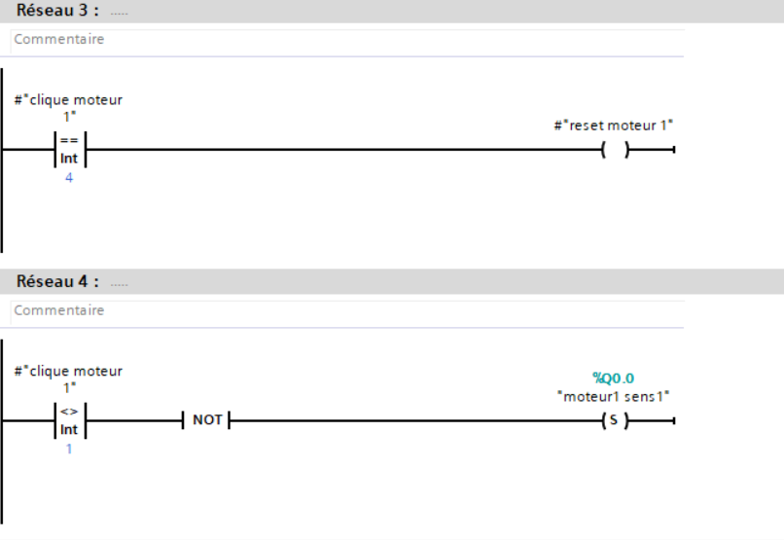
[picture p55: figure]
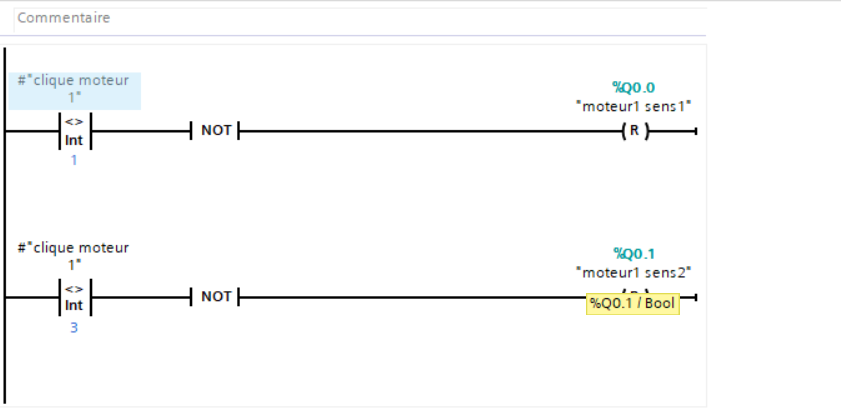
[picture p56: figure]

Figure 46:paramètre de bouton de moteur

### 5.5.4 Fonction de production normale (FB3) :

Cette fonction est la fonction le plus facile et existante dans la machine j’ai faire de reconstruire juste en TiaPortal pour effectuée une machine hybride

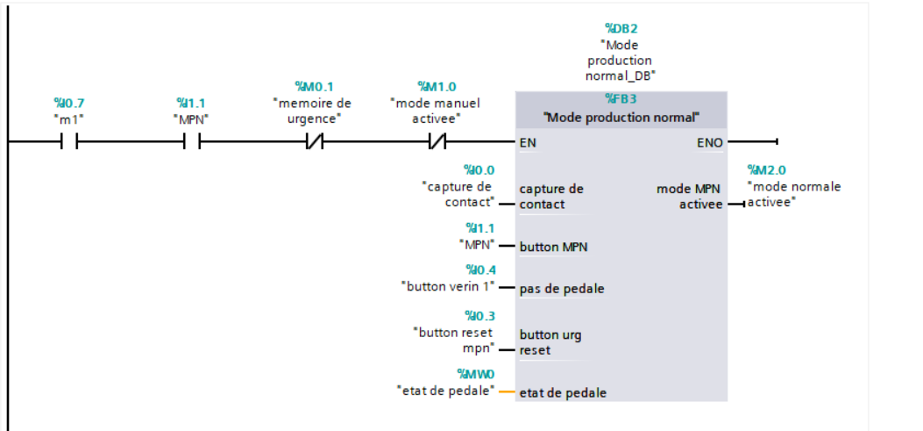
[picture p57: figure]

Figure 47: Capture illustrative de la fonction action FB3 appelé dans OB1

### 5.5.5 Bloc de sécurité (FB1) :

La sécurité industrielle consiste à contrôler voire réduire les risques au sein d’une industrie afin de garantir la sécurité des biens et des personnes, il a été constaté que les activités les secteurs industriels présentent des risques inhérents qui doivent être maîtrisés. Principaux risques de l’industrie est associée à des accidents, ce qui peut avoir un impact significatif sur environnement et dommages causés à des zones entières ainsi qu’à l’emplacement où se trouve le siège de l’entreprise lorsque des réclamations surviennent.

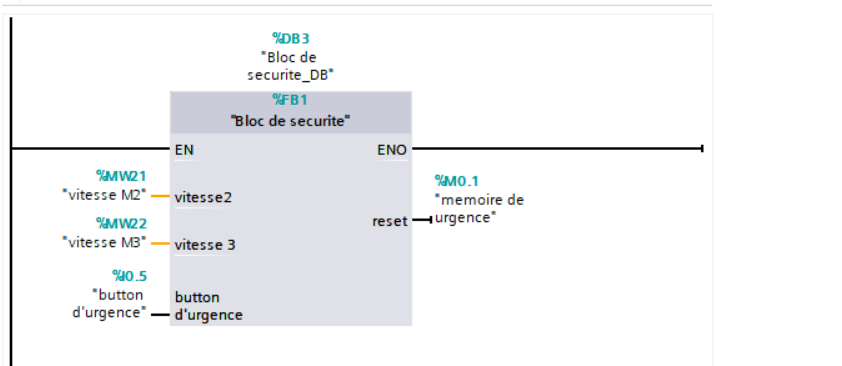
[picture p58: figure]

Figure 48:Capture illustrative de la fonction sécurité appelé dans OB1

### 5.5.6 Paramétrage MODBUS :

A cause de la limitation de ports entrées/sorties sur le s7 1211C nous décidant d’applique une carte communication CB1241(figure 31)

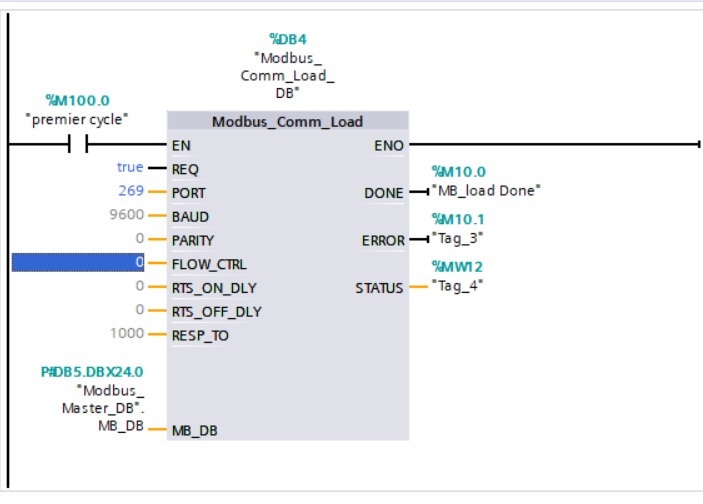
[picture p59: figure]

Figure 49: configuration carte Modbus sur TiaPortal

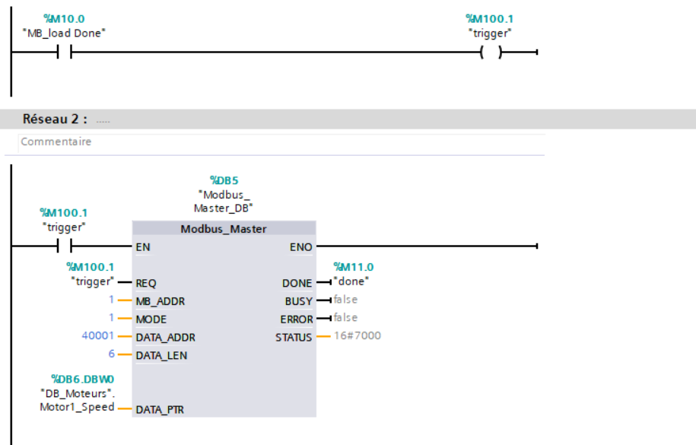
[picture p60: figure]

Figure 50:configuration expéditeur et destinataire de la carte

### 5.5.7 Paramétrages des moteurs pas à pas :

Ce bloc fait les traitements de informations pour les moteurs pas a pas qui va connectée par STM32 à cause de la limitation des portes PTO en notre API

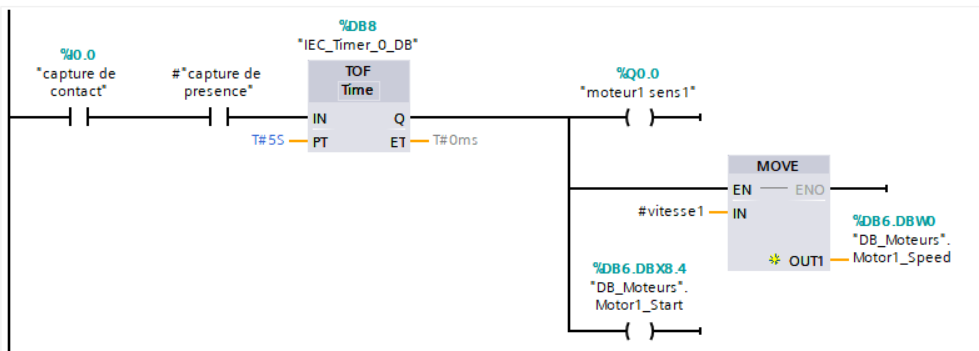
[picture p61: figure]

Figure 51:le bloc de programmation moteur pas à pas 1

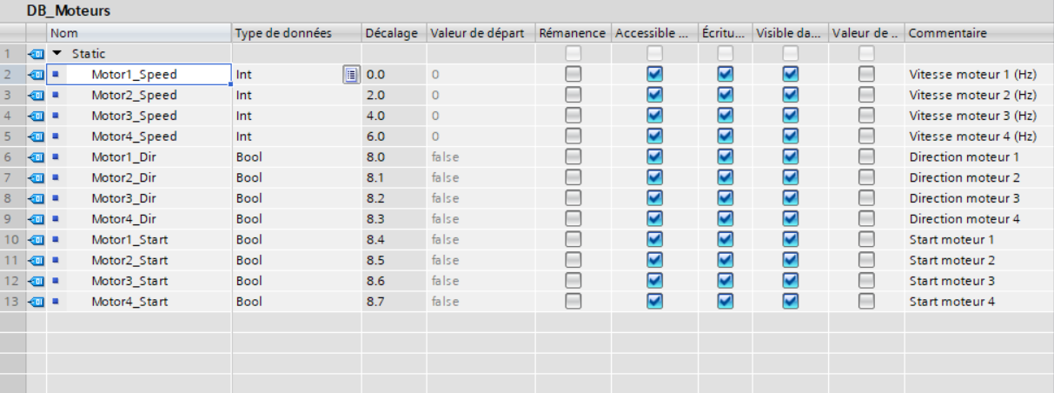
[picture p62: figure]

Figure 52:base de données moteurs pas à pas

### 5.5.8 Programmation de carte STM32 :

Le microcontrôleur STM32F103 (Blue Pill) a été programmé en C++ sous arduino IDE, garantissant une exécution rapide et déterministe des tâches critiques. Le firmware assure principalement la génération des signaux PTO destinés à la commande des trois moteurs pas à pas NEMA17 via les drivers TB6600. Cette fonction est réalisée à l'aide des timers matériels du STM32 (TIM1 à TIM4), configurés en mode PWM à fréquence variable, tandis que les signaux de direction sont gérés par des sorties GPIO dédiées.

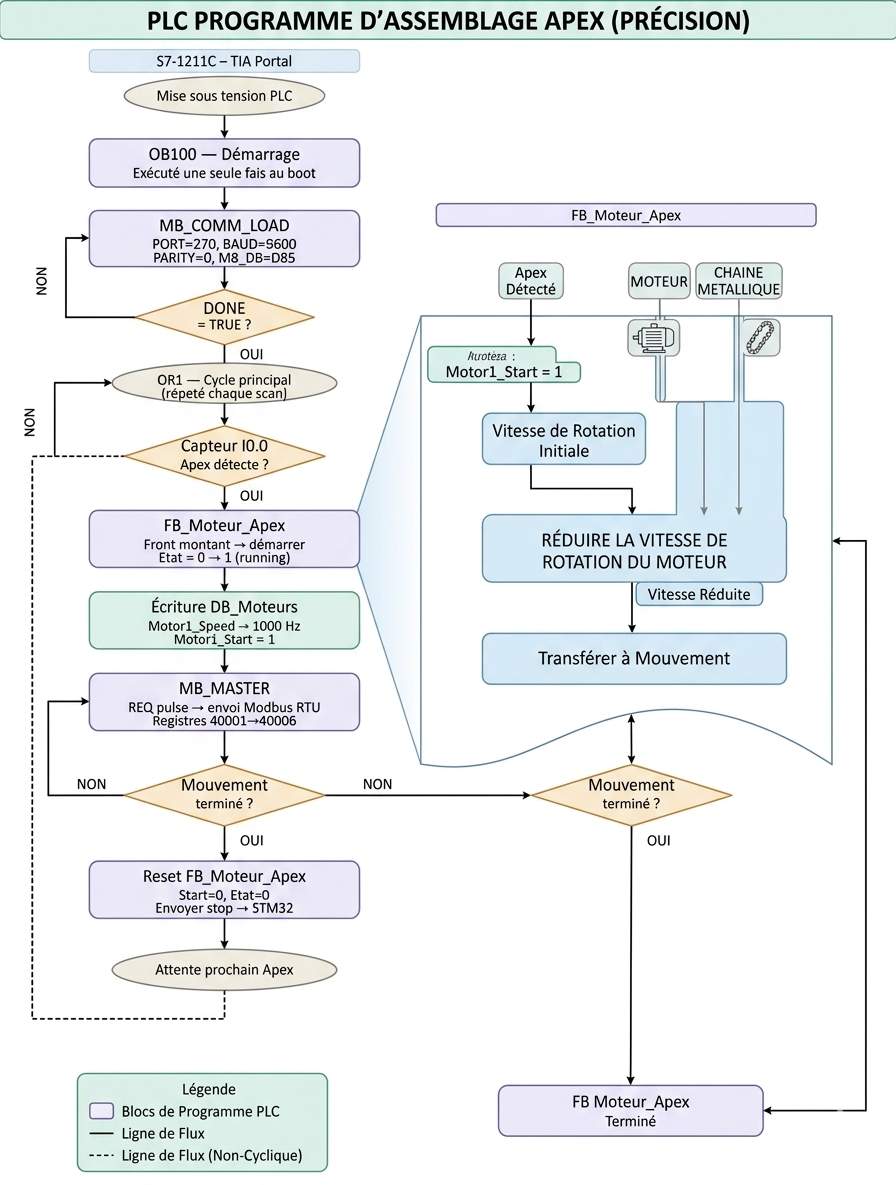
[picture p63: figure]

Figure 53:organigramme de programmation STM32

BIBLIOGRAPHIE

[1] « STEELASTIC® Automatic Apex Machine for Apexed Bead Adhesion ». Consulté le: 15 juin 2026. [En ligne]. Disponible sur: https://www.steelastic.com/tire-component-equipment/apex-application-systems/

[2] I. S. r l-http://www.intereuropean.it, « Home Page », INTEREUROPEAN Tire Machinery Design & Manufacturing. Consulté le: 15 juin 2026. [En ligne]. Disponible sur: http://www.intereuropean.it/index.html

[3] « DUPLEX APEX – TBR – VIPO a.s. » Consulté le: 15 juin 2026. [En ligne]. Disponible sur: https://vipo.sk/en/machinery-electronic/tire/duplex-apex-tbr/

[4] « Automatic Truck Bead Apex System from Bartell Machinery Systems, LLC ». Consulté le: 15 juin 2026. [En ligne]. Disponible sur: https://www.globalspec.com/FeaturedProducts/Detail/BartellMachinerySystems/292043/Automatic_Truck_Bead_Apex_System

ANNEXES

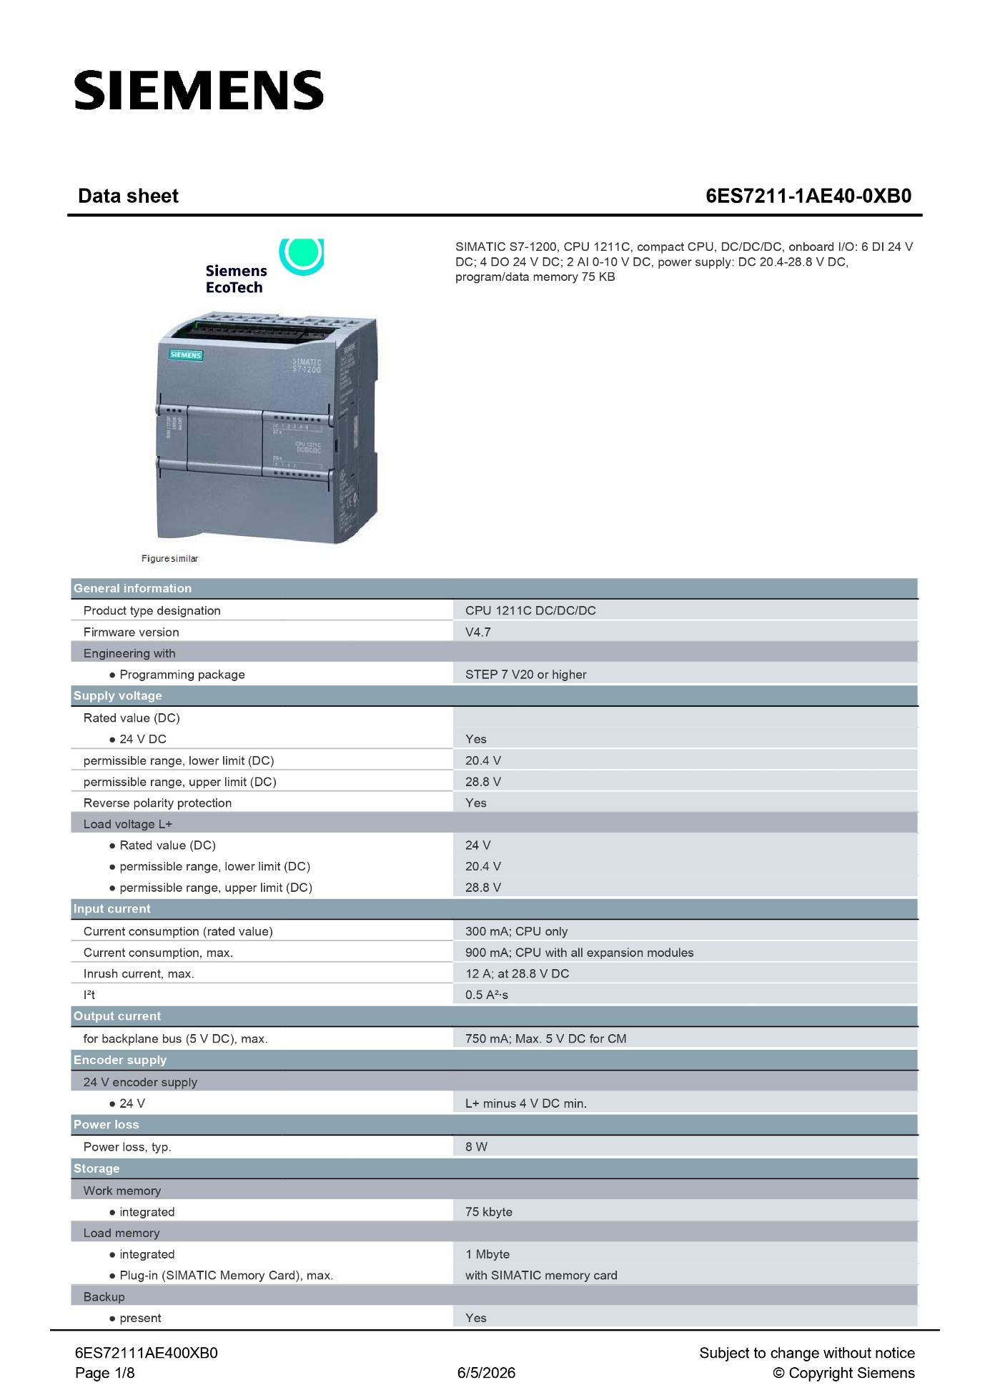
[picture p64: figure]
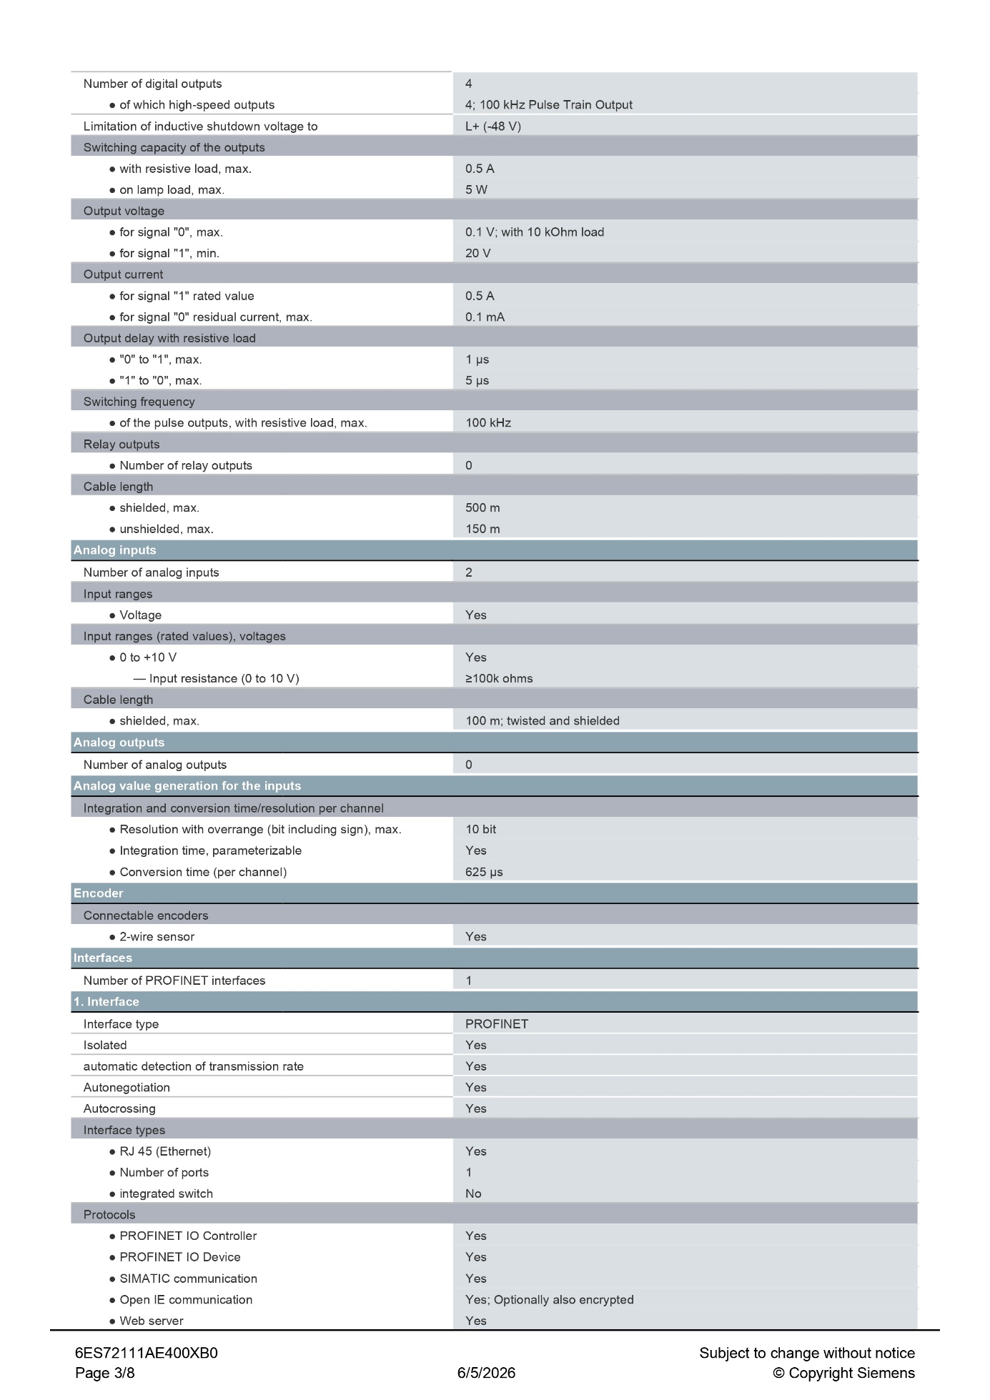
[picture p65: figure]
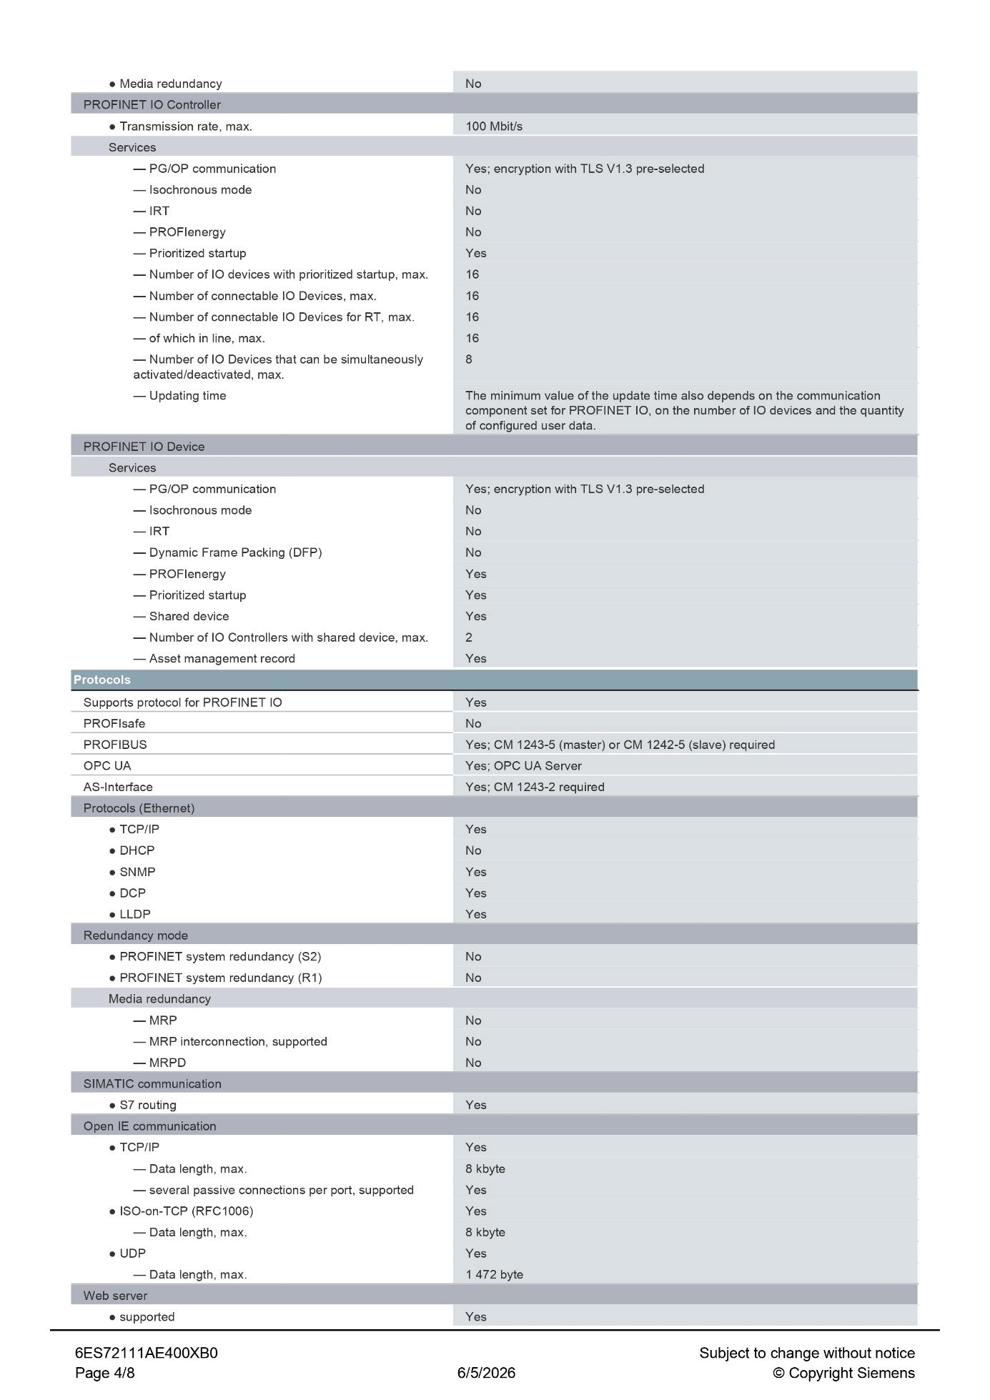
[picture p66: figure]
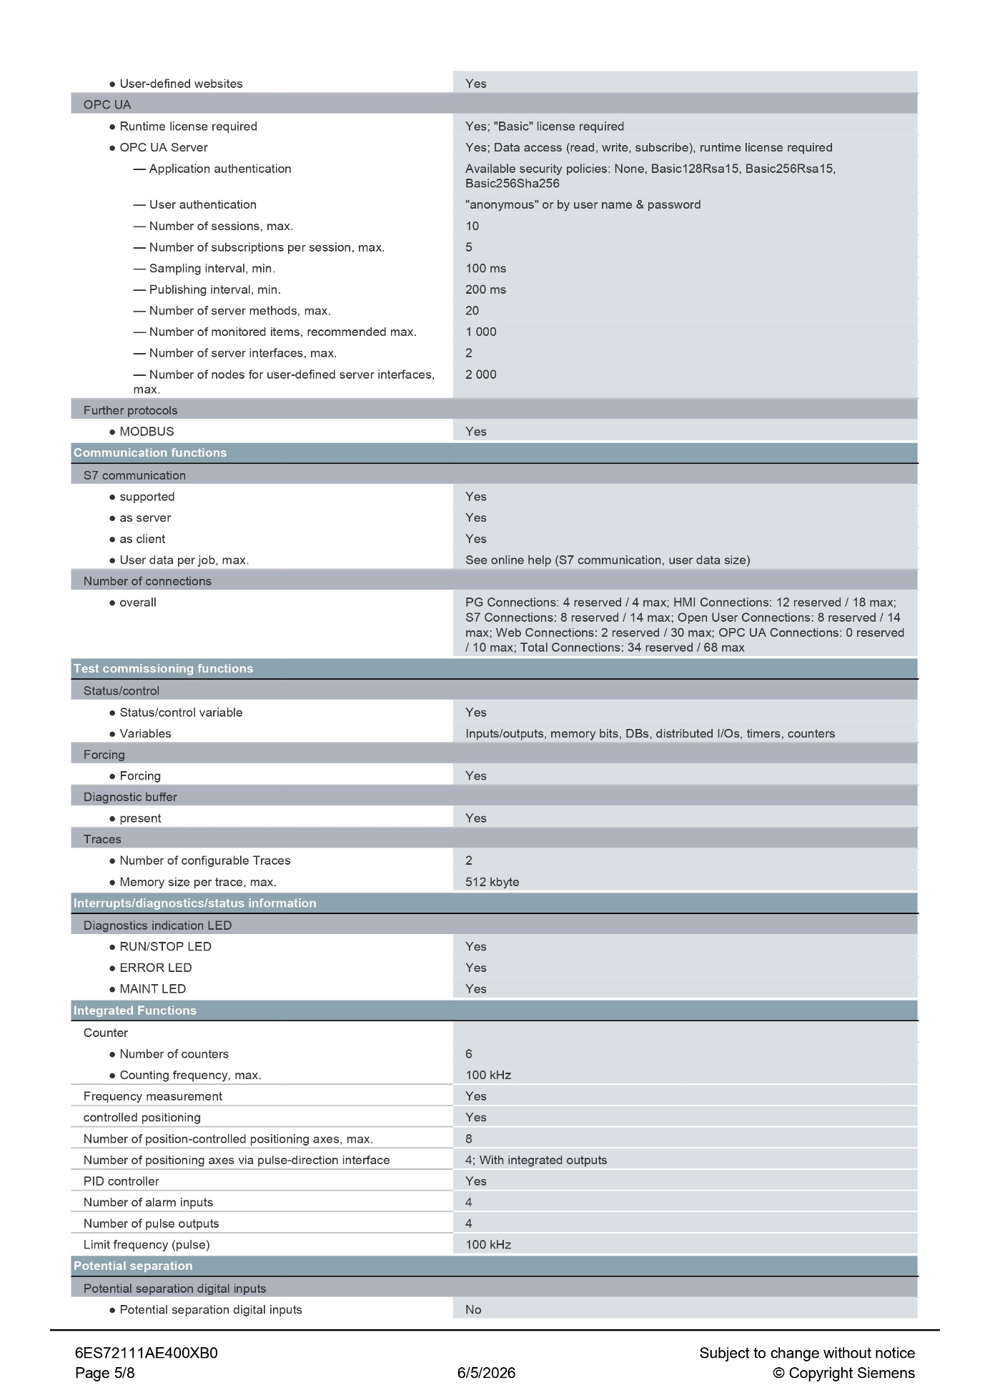
[picture p67: figure]
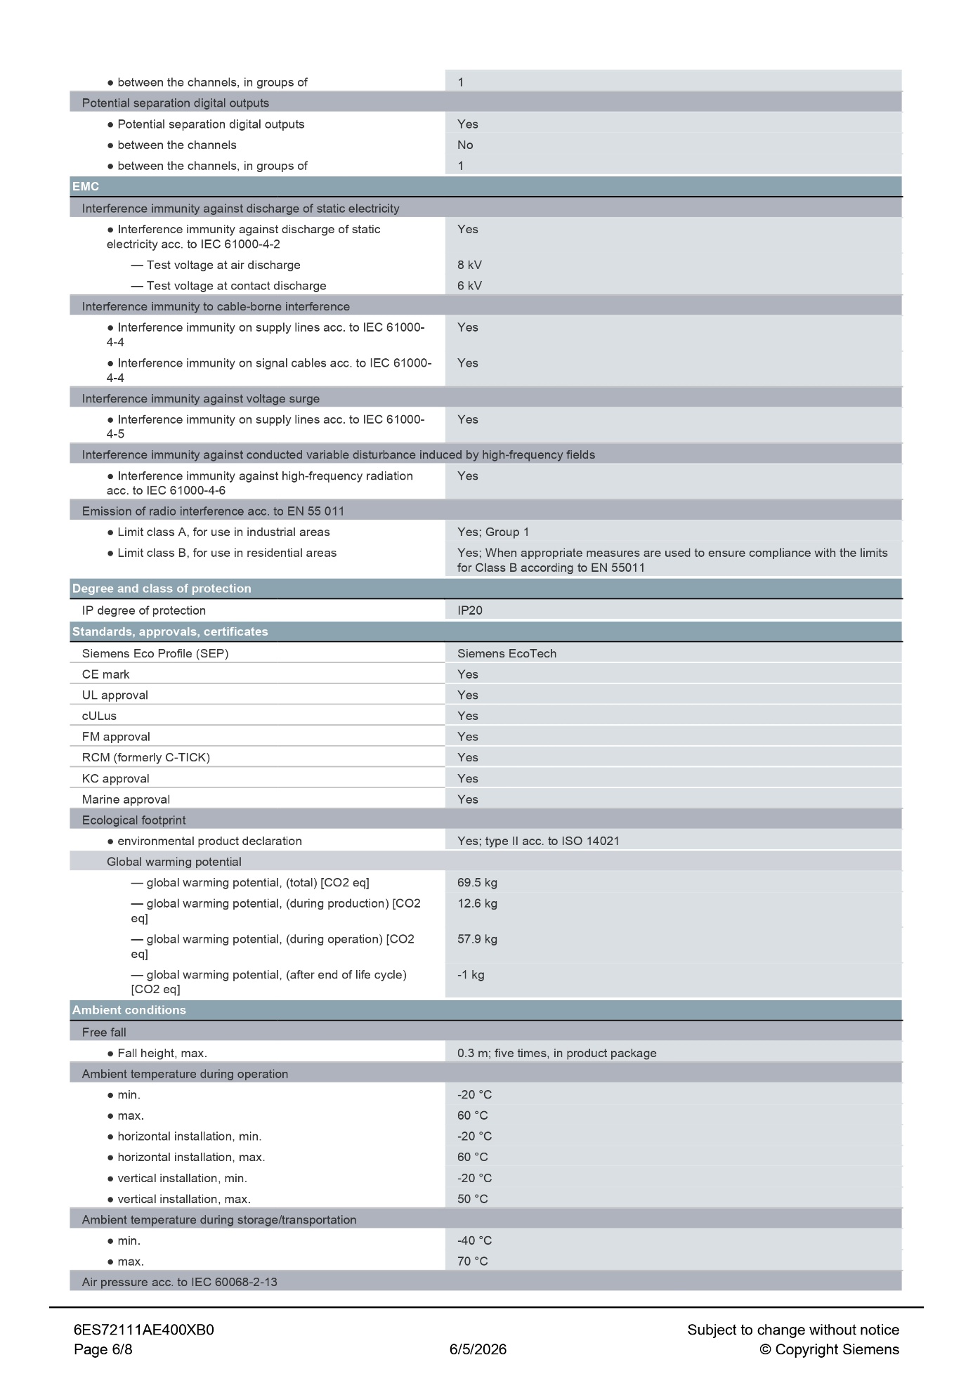
[picture p68: figure]
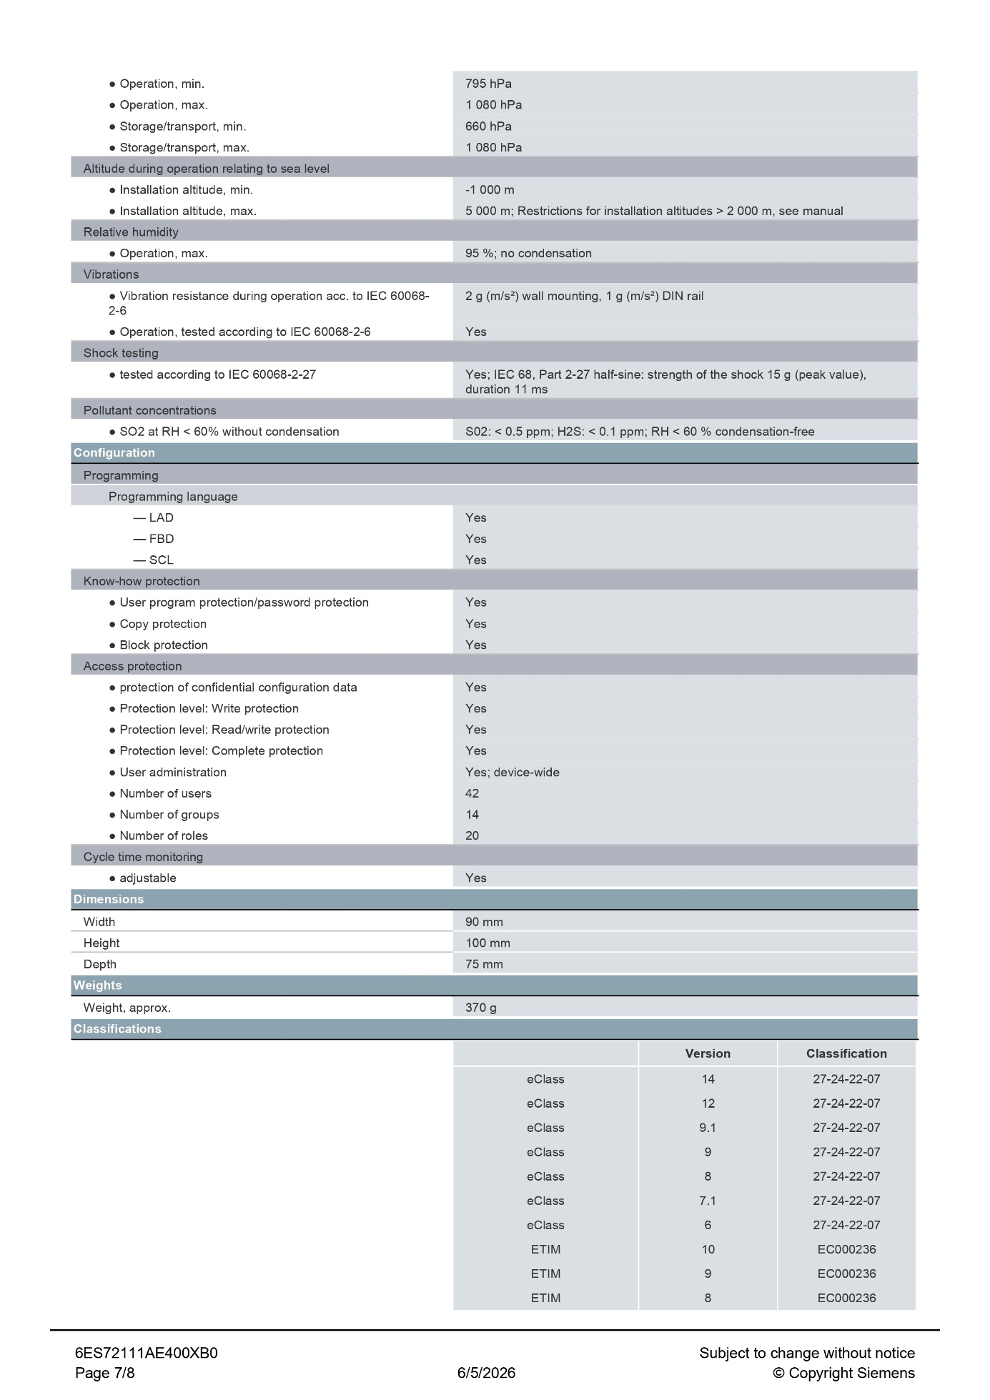
[picture p69: figure]
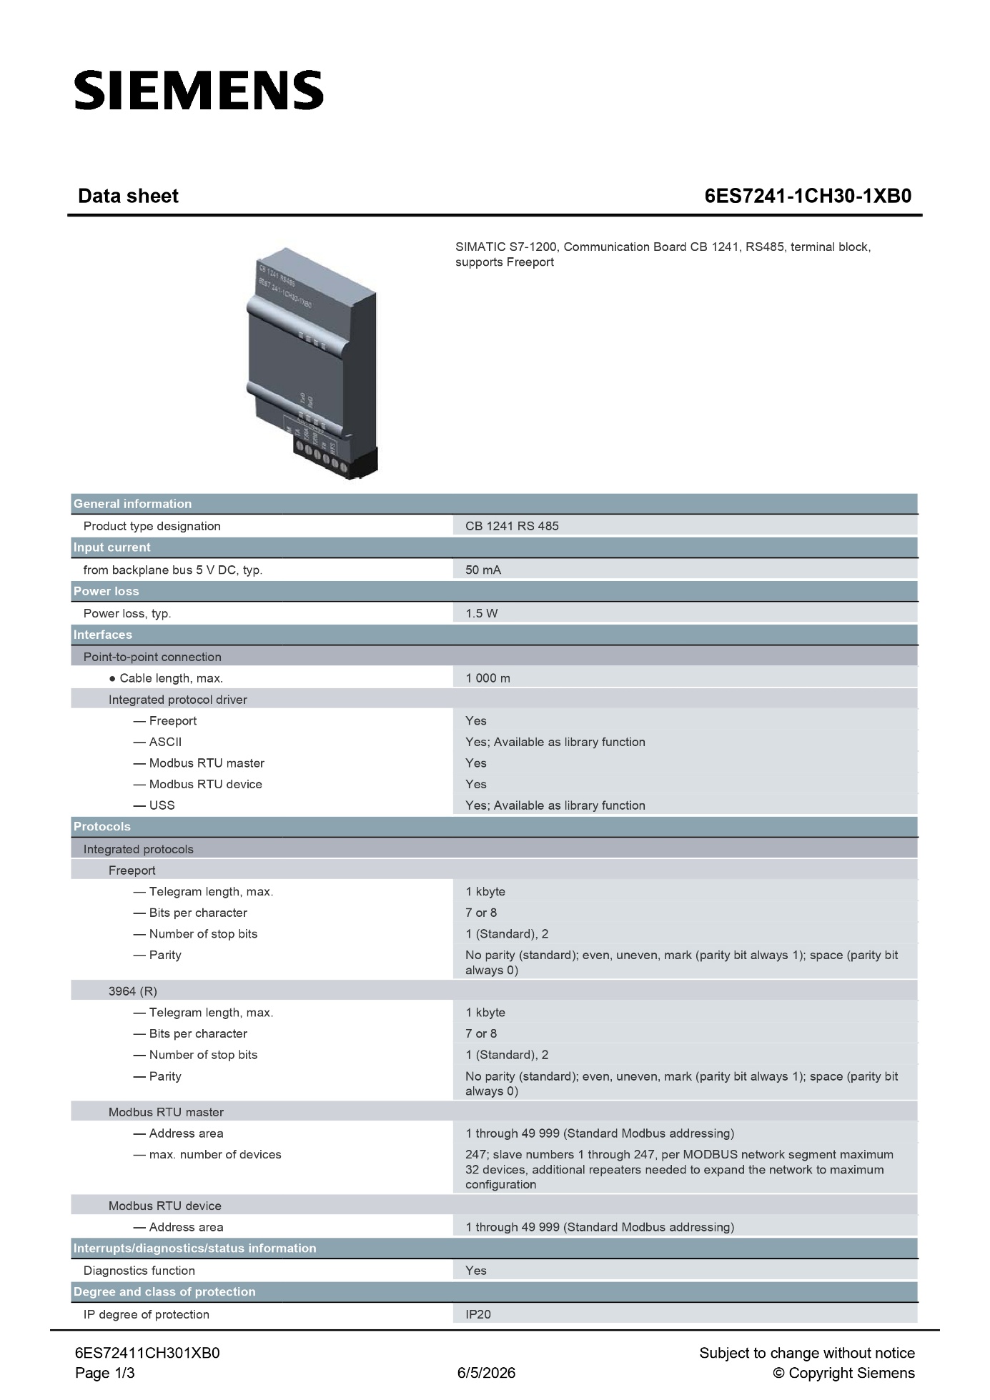
[picture p70: figure]
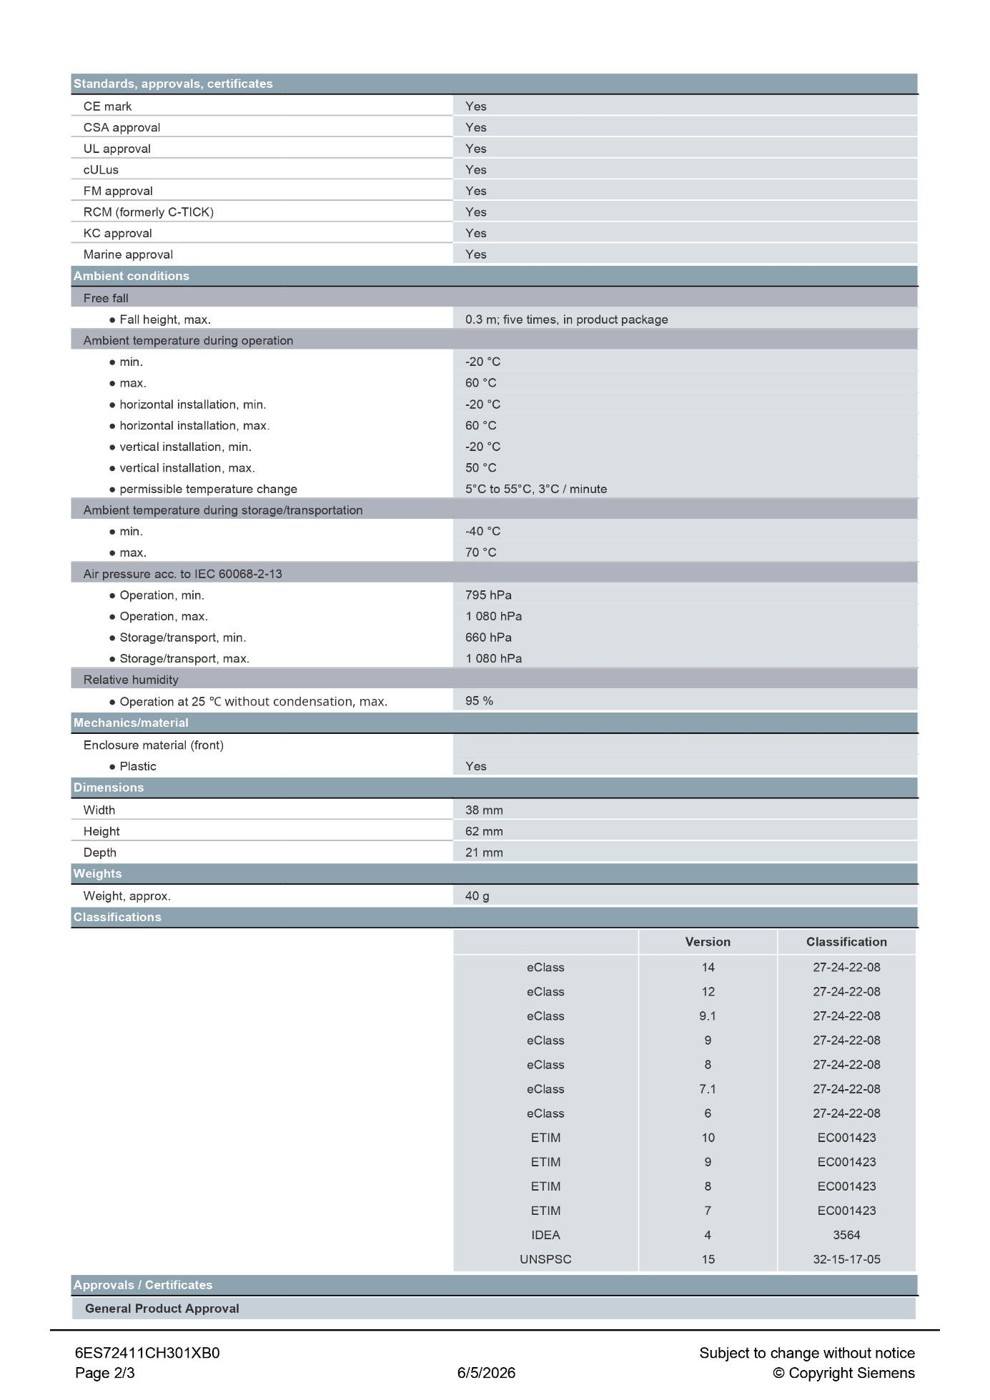
[picture p71: figure]
