MedAmine-source/Ameloration-of-old-industrial-machinery/new version machine beta/Assemblage amine guesmi bbb.SLDPRT

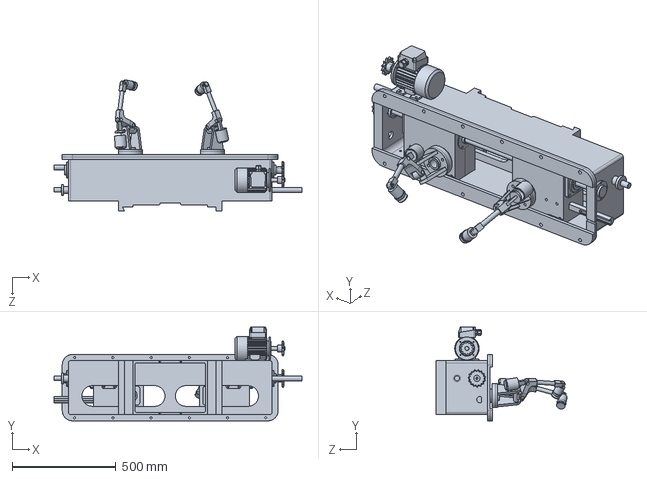
[picture p73: CAD file, 2026-06-09]
new version machine beta/Assemblage amine guesmi bbb.SLDPRT
1194.0 x 451.7 x 632.9 mm
