MedAmine-source/Ameloration-of-old-industrial-machinery/new version machine beta/Assemblage1.SLDASM

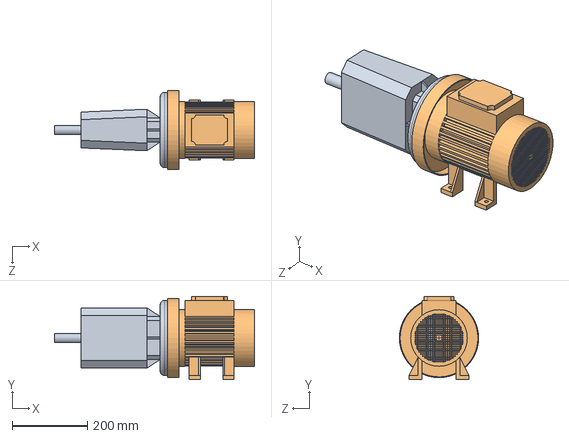
[picture p74: CAD file, 2026-04-25]
new version machine beta/Assemblage1.SLDASM
530.0 x 220.0 x 210.0 mm
moteur stip grand
reducteur moteur
