MedAmine-source/Ameloration-of-old-industrial-machinery/new version machine beta/3dfindit-BENE_INOX_-_Visserie_et_boulonnerie_-_Elé-bene_inox_414653-8X200-0202605121103506540434710e898ce/bene_inox_414653-8X200.sldprt

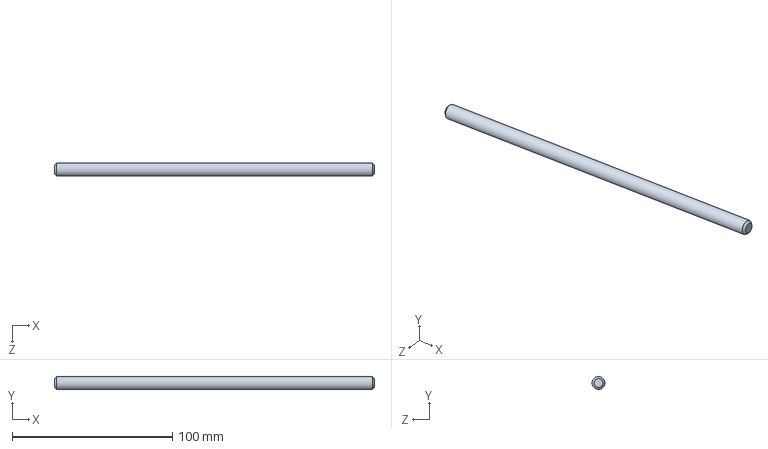
[picture p75: CAD file, 2026-06-09]
new version machine beta/3dfindit-BENE_INOX_-_Visserie_et_boulonnerie_-_Elé-bene_inox_414653-8X200-0202605121103506540434710e898ce/bene_inox_414653-8X200.sldprt
200.0 x 8.00 x 8.00 mm
