MedAmine-source/Ameloration-of-old-industrial-machinery/new version machine beta/corps machine apex v2.0.SLDPRT

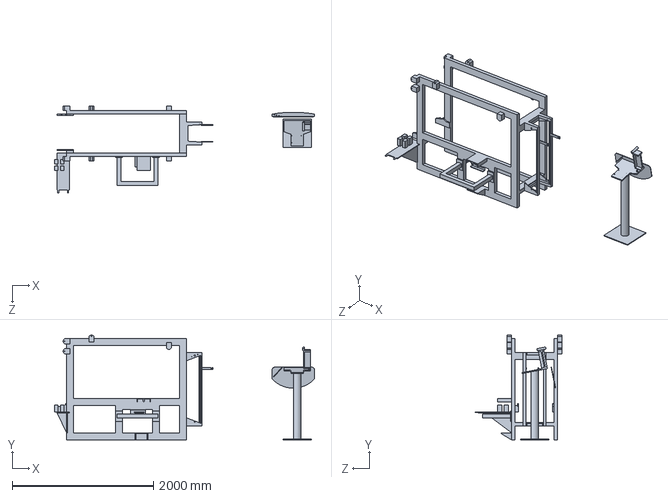
[picture p76: CAD file, 2026-06-09]
new version machine beta/corps machine apex v2.0.SLDPRT
3682.4 x 1485.0 x 1239.0 mm
