MedAmine-source/Ameloration-of-old-industrial-machinery/new version machine beta/robot-gripper-mechanism-v2-1.snapshot.5/hvataljka v2.stp

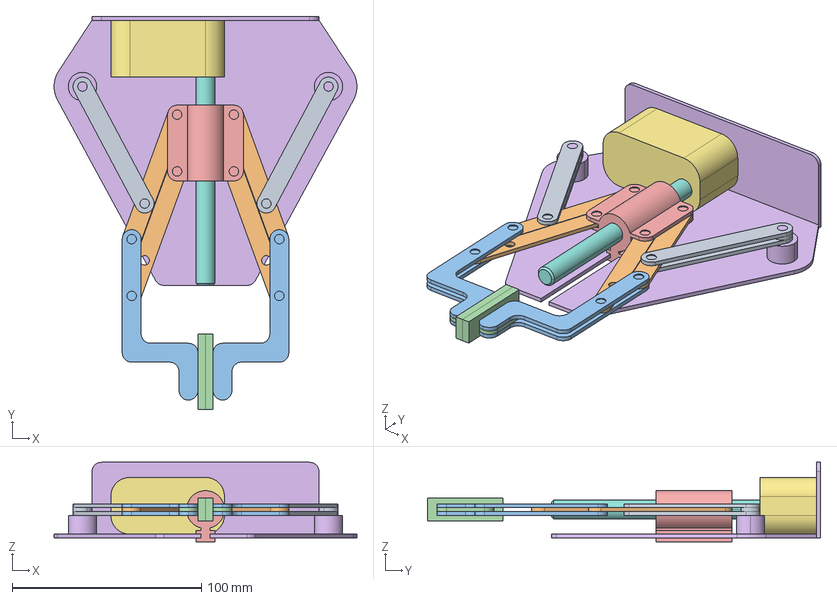
[picture p77: CAD file, 2026-06-09]
new version machine beta/robot-gripper-mechanism-v2-1.snapshot.5/hvataljka v2.stp
160.0 x 207.6 x 42.0 mm
