MedAmine-source/Ameloration-of-old-industrial-machinery/new version machine beta/rouleau support.SLDPRT

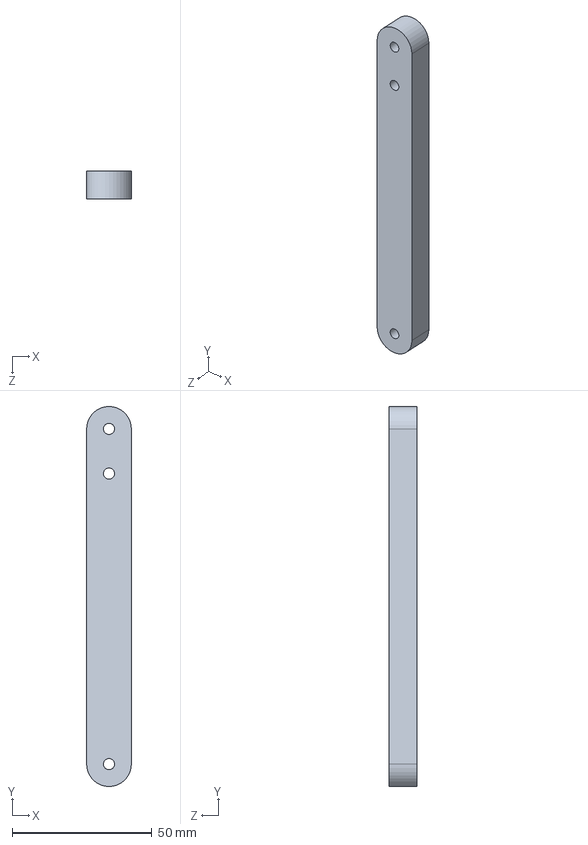
[picture p78: CAD file, 2026-06-09]
new version machine beta/rouleau support.SLDPRT
16.0 x 136.0 x 10.0 mm
