MedAmine-source/Ameloration-of-old-industrial-machinery/new version machine beta/3dfindit-Thomson_Linear-1BA04AH0L12.000-0202605140950544545549810e898ce/SOLIDWORKS/RS-4-12.sldprt

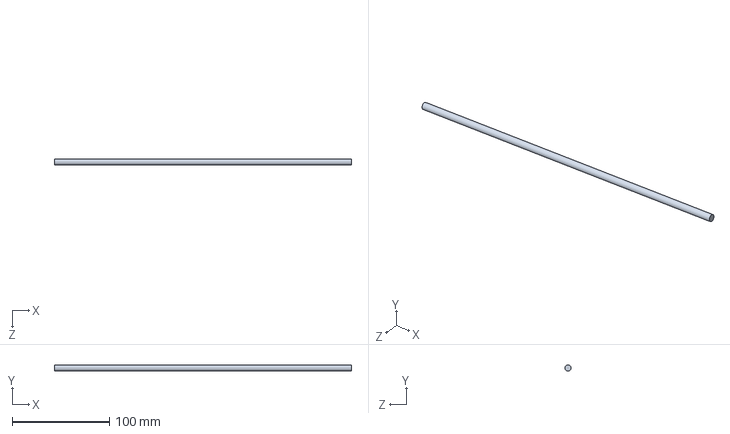
[picture p79: CAD file, 2026-06-09]
new version machine beta/3dfindit-Thomson_Linear-1BA04AH0L12.000-0202605140950544545549810e898ce/SOLIDWORKS/RS-4-12.sldprt
304.8 x 6.35 x 6.35 mm
