MedAmine-source/Ameloration-of-old-industrial-machinery/new version machine beta/support automatique v1.0.SLDPRT

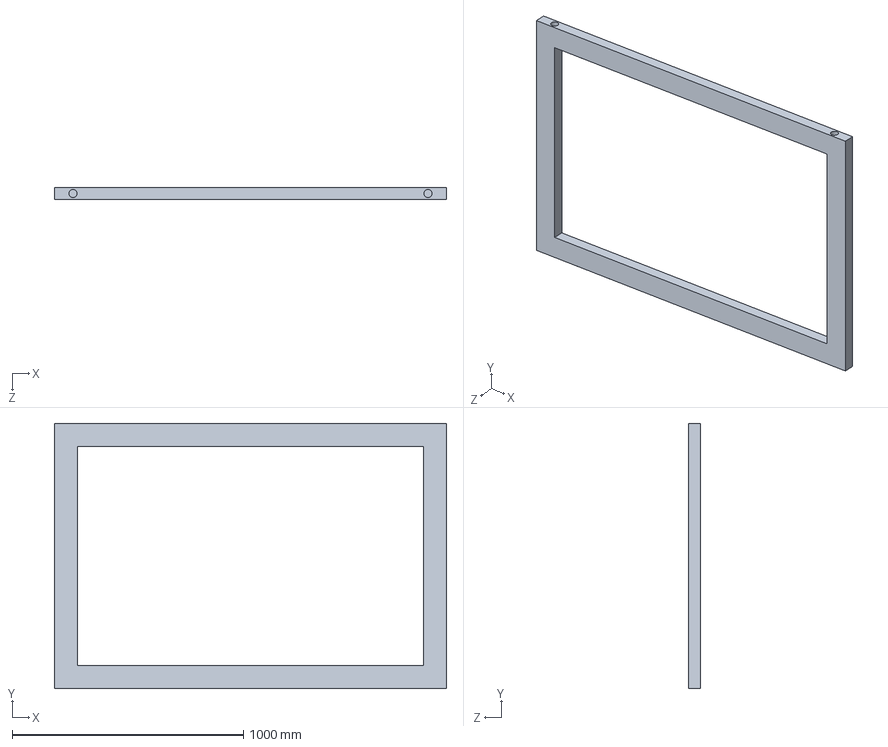
[picture p80: CAD file, 2026-06-09]
new version machine beta/support automatique v1.0.SLDPRT
1695.0 x 1147.0 x 50.1 mm
