MedAmine-source/Ameloration-of-old-industrial-machinery/new version machine beta/cale1 gripper.SLDPRT

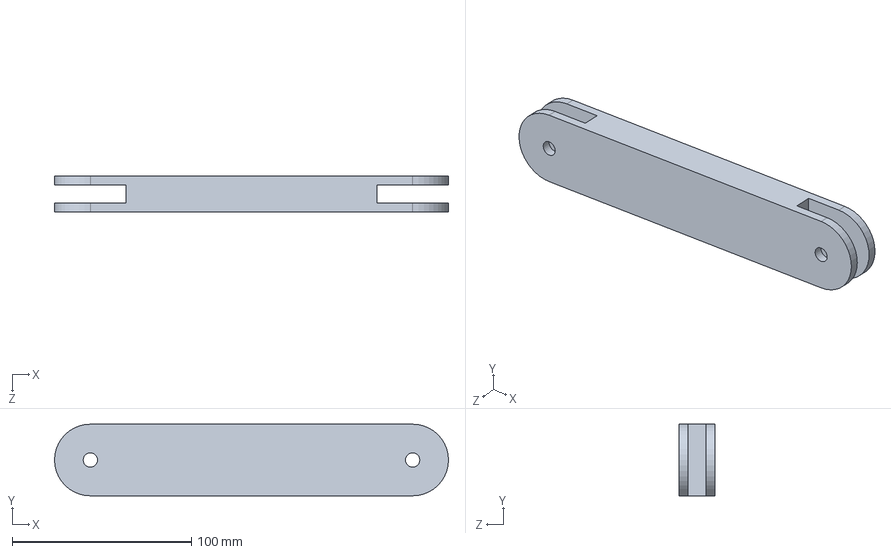
[picture p81: CAD file, 2026-06-09]
new version machine beta/cale1 gripper.SLDPRT
220.0 x 40.0 x 20.0 mm
