MedAmine-source/Ameloration-of-old-industrial-machinery/new version machine beta/Pièce1.SLDPRT

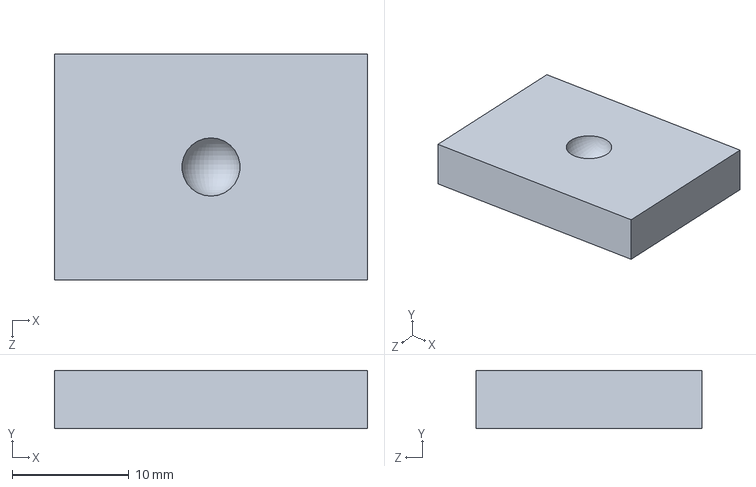
[picture p82: CAD file, 2026-06-09]
new version machine beta/Pièce1.SLDPRT
26.8 x 5.00 x 19.4 mm
