MedAmine-source/Ameloration-of-old-industrial-machinery/new version machine beta/support cale.SLDPRT

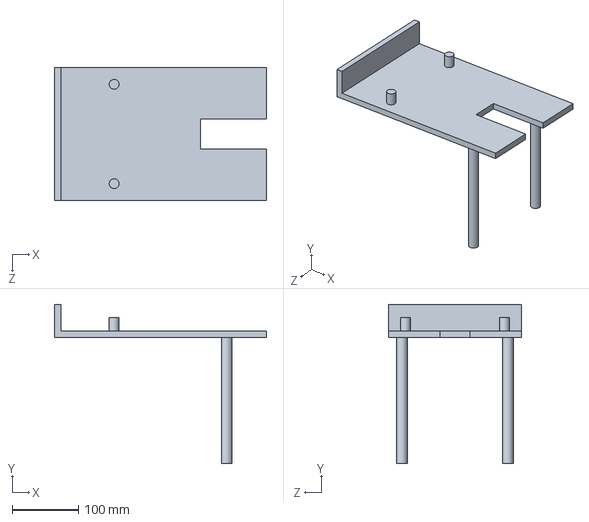
[picture p83: CAD file, 2026-06-09]
new version machine beta/support cale.SLDPRT
320.0 x 240.0 x 200.0 mm
