MedAmine-source/Ameloration-of-old-industrial-machinery/new version machine beta/rauleau basse v2.0.SLDPRT

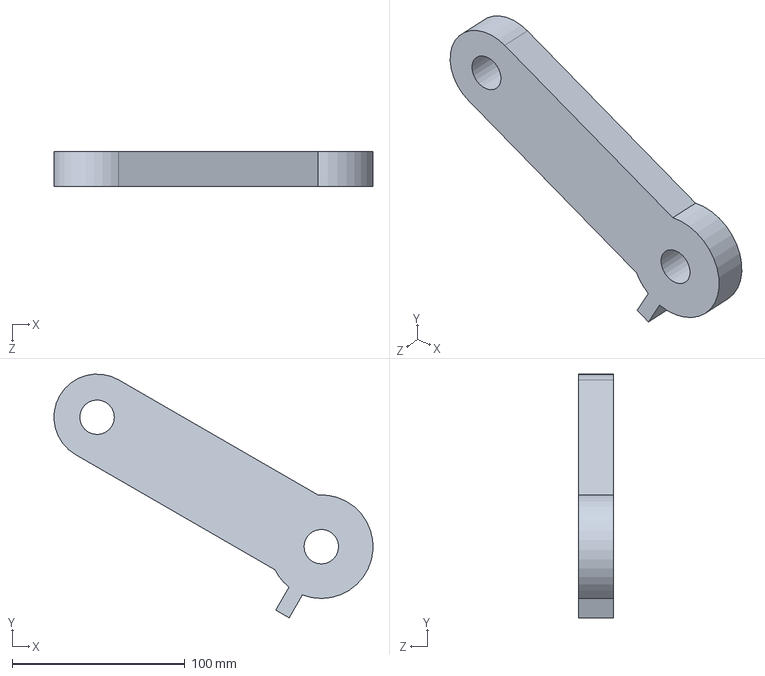
[picture p84: CAD file, 2026-06-09]
new version machine beta/rauleau basse v2.0.SLDPRT
184.8 x 141.2 x 20.0 mm
