MedAmine-source/Ameloration-of-old-industrial-machinery/new version machine beta/test support1.SLDPRT

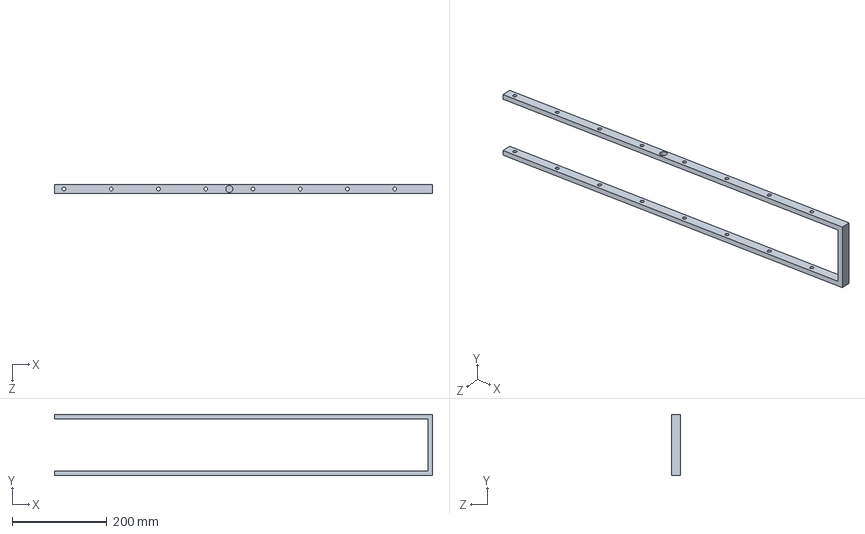
[picture p85: CAD file, 2026-06-09]
new version machine beta/test support1.SLDPRT
800.0 x 130.0 x 20.0 mm
