MedAmine-source/Ameloration-of-old-industrial-machinery/new version machine beta/Pièce4.SLDPRT

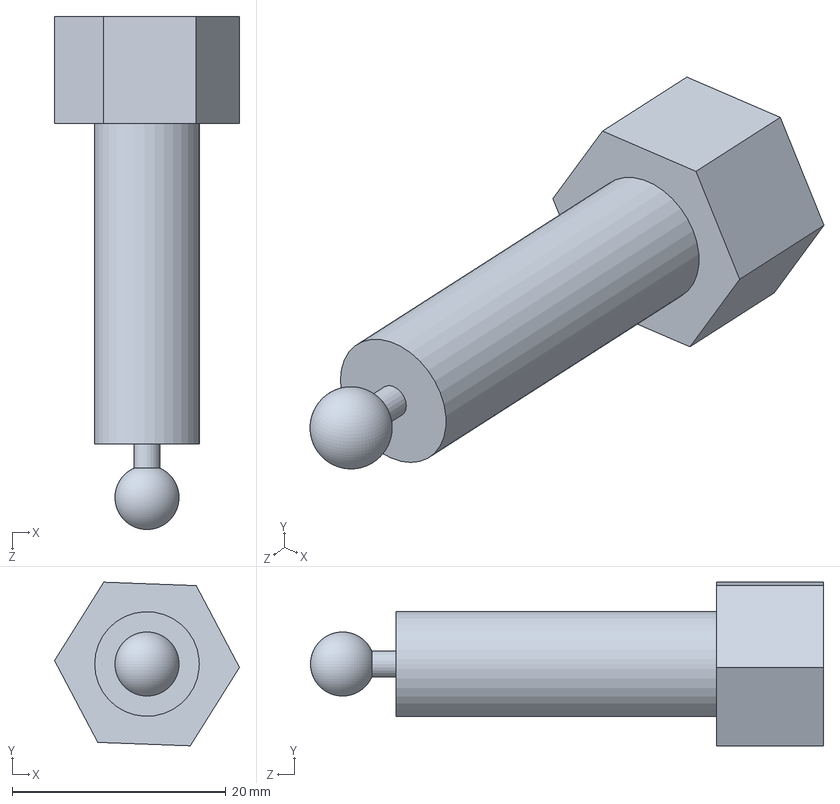
[picture p86: CAD file, 2026-06-09]
new version machine beta/Pièce4.SLDPRT
17.3 x 15.3 x 48.0 mm
