MedAmine-source/Ameloration-of-old-industrial-machinery/new version machine beta/chauffage support.SLDPRT

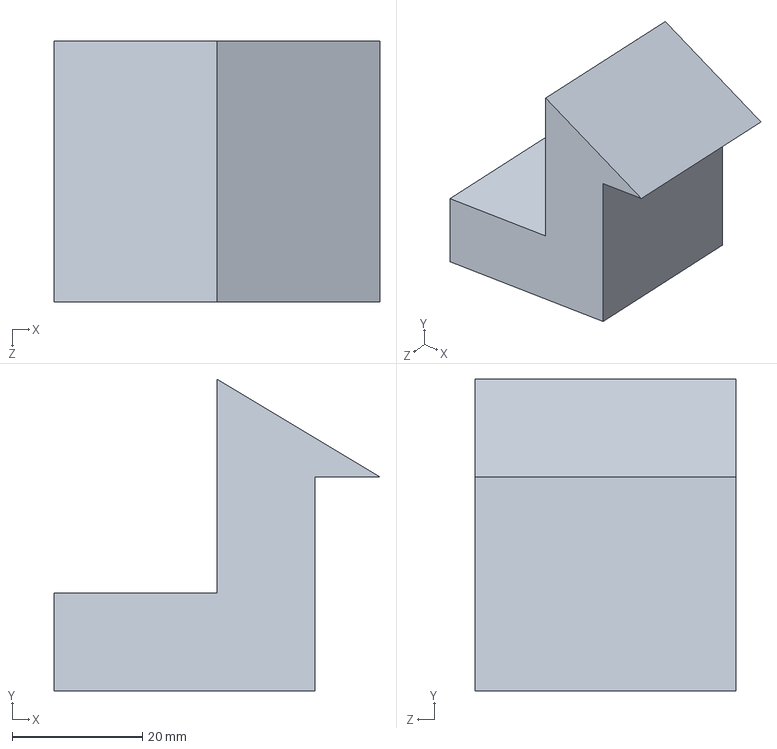
[picture p87: CAD file, 2026-06-09]
new version machine beta/chauffage support.SLDPRT
50.0 x 47.8 x 40.0 mm
