MedAmine-source/Ameloration-of-old-industrial-machinery/new version machine beta/cale2 gripper.SLDPRT

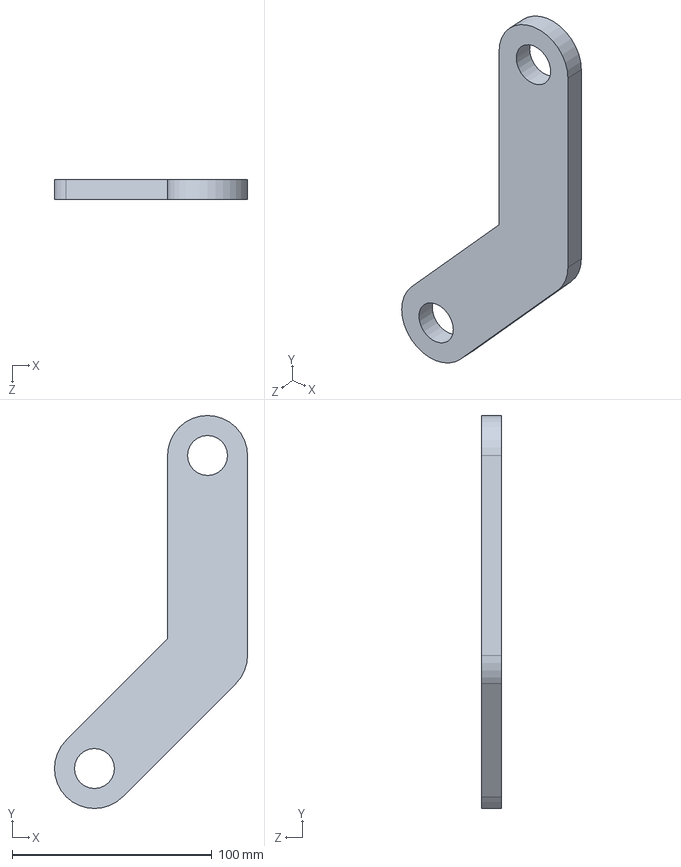
[picture p88: CAD file, 2026-06-09]
new version machine beta/cale2 gripper.SLDPRT
96.6 x 196.6 x 10.0 mm
