MedAmine-source/Ameloration-of-old-industrial-machinery/new version machine beta/tige support.SLDPRT

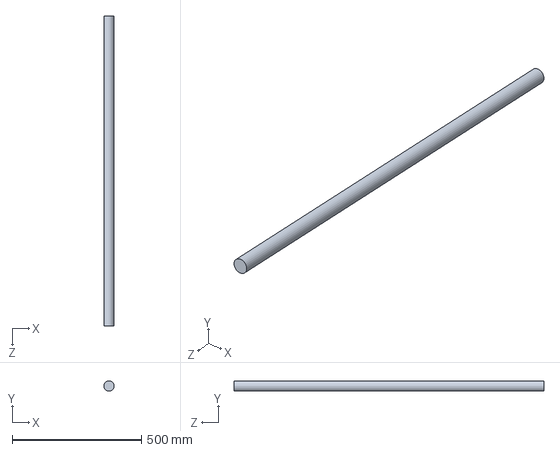
[picture p89: CAD file, 2026-06-09]
new version machine beta/tige support.SLDPRT
40.0 x 39.9 x 1200.0 mm
