MedAmine-source/Ameloration-of-old-industrial-machinery/new version machine beta/Pièce2.SLDPRT

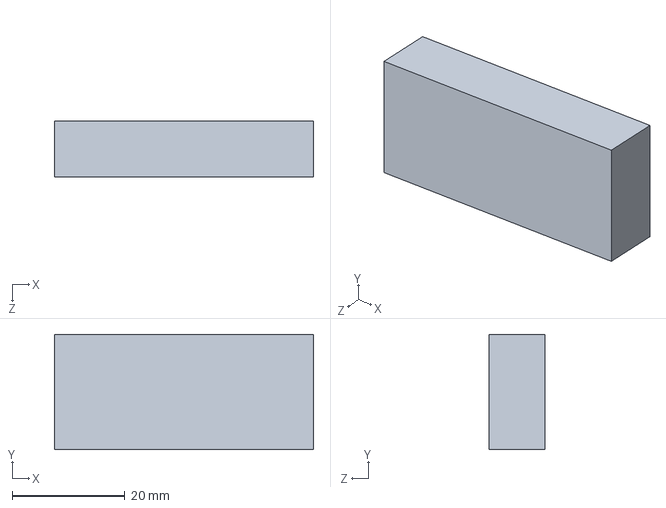
[picture p90: CAD file, 2026-06-09]
new version machine beta/Pièce2.SLDPRT
45.9 x 20.4 x 10.0 mm
