MedAmine-source/Ameloration-of-old-industrial-machinery/new version machine beta/Pièce3.SLDPRT

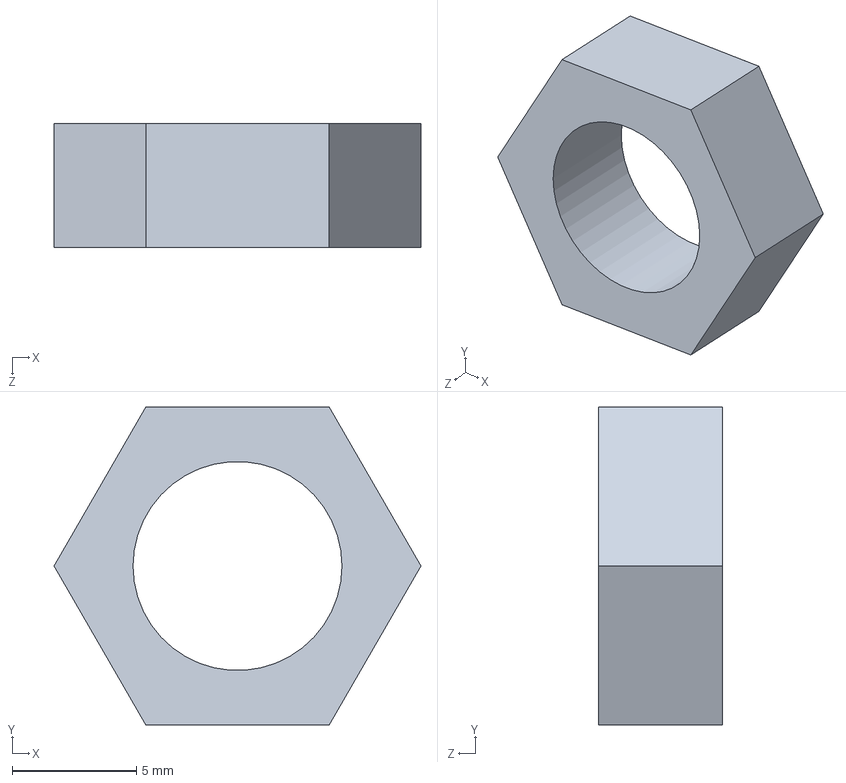
[picture p91: CAD file, 2026-06-09]
new version machine beta/Pièce3.SLDPRT
14.8 x 12.8 x 5.00 mm
