MedAmine-source/Ameloration-of-old-industrial-machinery/new version machine beta/organ intermidiare.SLDPRT

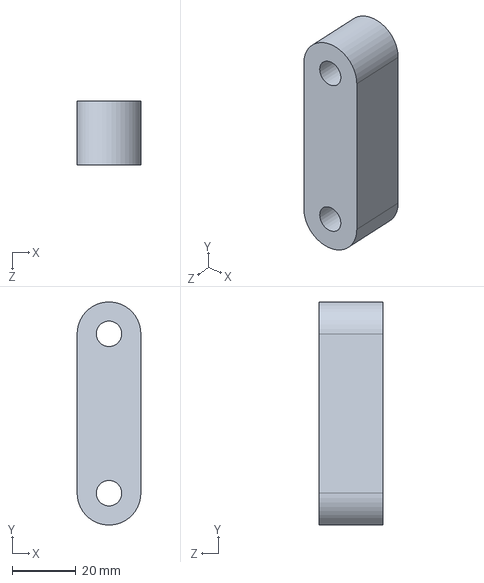
[picture p92: CAD file, 2026-06-09]
new version machine beta/organ intermidiare.SLDPRT
20.0 x 69.9 x 20.0 mm
