MedAmine-source/Ameloration-of-old-industrial-machinery/new version machine beta/gripper v1.SLDPRT

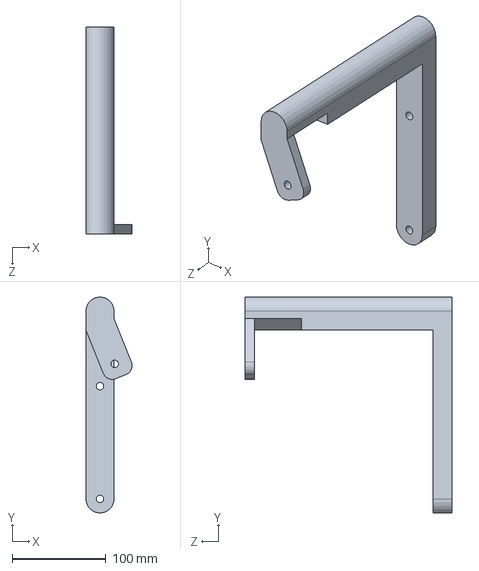
[picture p93: CAD file, 2026-06-09]
new version machine beta/gripper v1.SLDPRT
49.2 x 230.0 x 220.0 mm
