MedAmine-source/Ameloration-of-old-industrial-machinery/new version machine beta/cale v2 gripper.SLDPRT

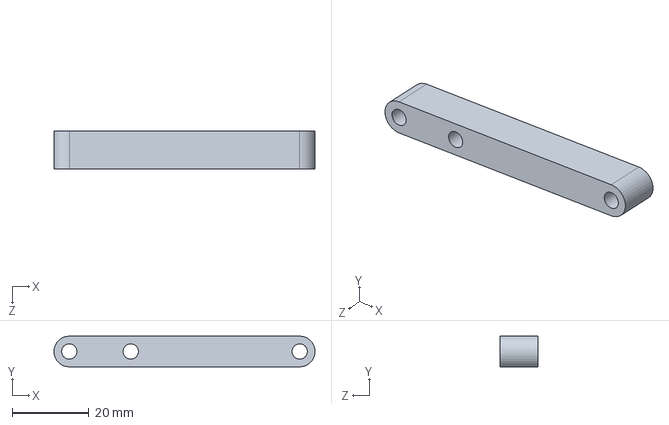
[picture p94: CAD file, 2026-06-09]
new version machine beta/cale v2 gripper.SLDPRT
68.0 x 8.00 x 10.0 mm
