MedAmine-source/Ameloration-of-old-industrial-machinery/new version machine beta/support cale inferieur.SLDPRT

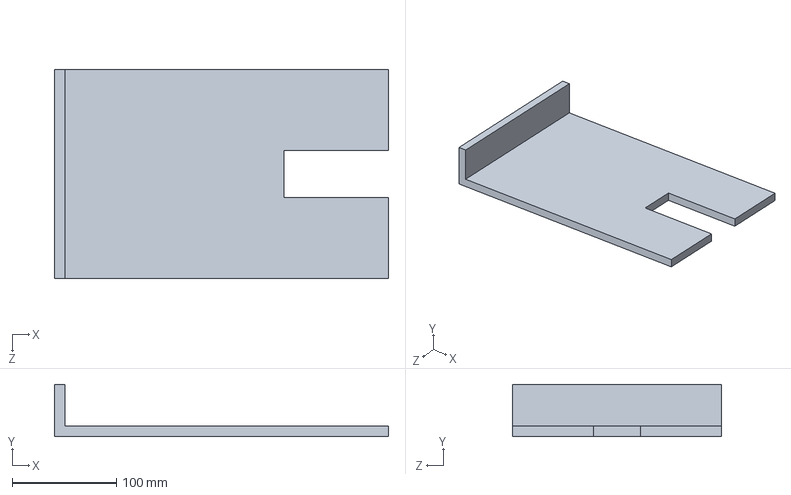
[picture p95: CAD file, 2026-06-09]
new version machine beta/support cale inferieur.SLDPRT
320.0 x 50.0 x 200.0 mm
