MedAmine-source/Ameloration-of-old-industrial-machinery/new version machine beta/porte support.SLDPRT

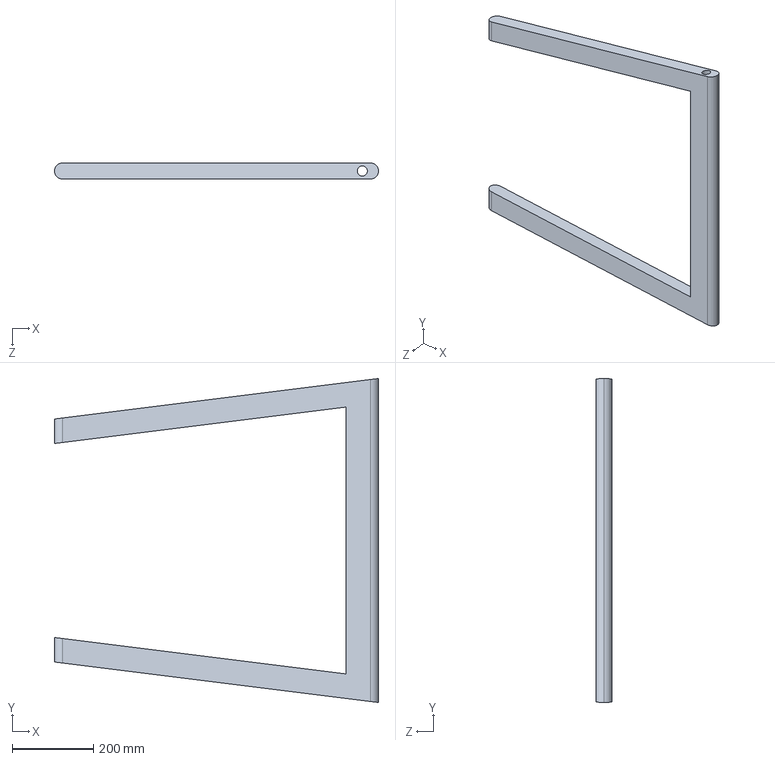
[picture p96: CAD file, 2026-06-09]
new version machine beta/porte support.SLDPRT
800.0 x 800.0 x 40.0 mm
