MedAmine-source/Ameloration-of-old-industrial-machinery/new version machine beta/moteur stip grand.SLDPRT

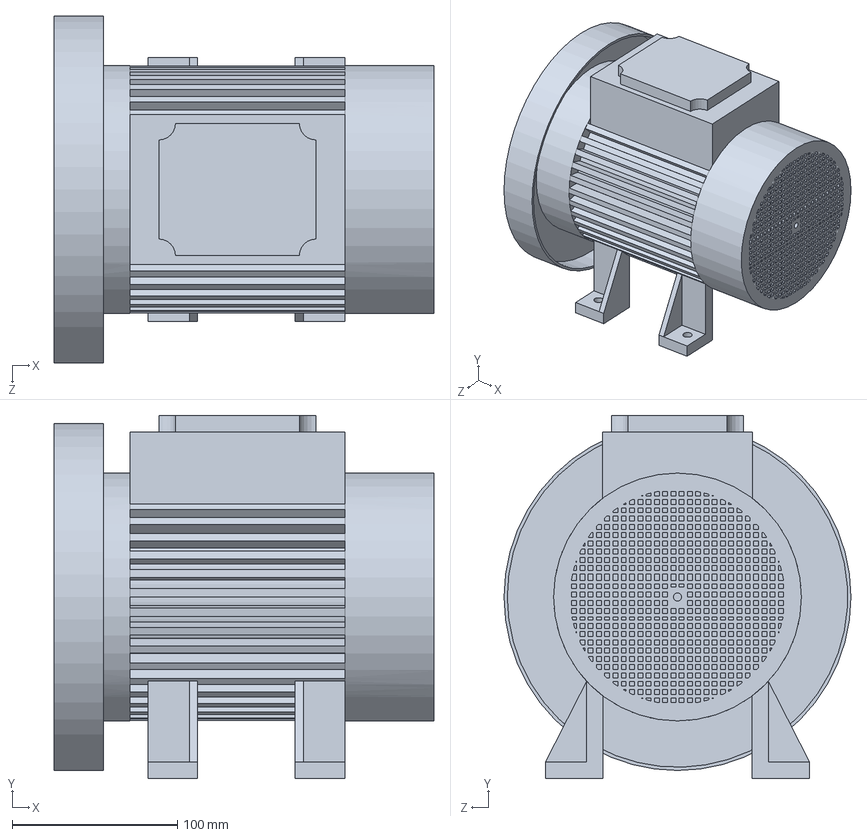
[picture p97: CAD file, 2026-04-25]
new version machine beta/moteur stip grand.SLDPRT
230.0 x 220.0 x 210.0 mm
