MedAmine-source/Ameloration-of-old-industrial-machinery/new version machine beta/reducteur moteur.SLDPRT

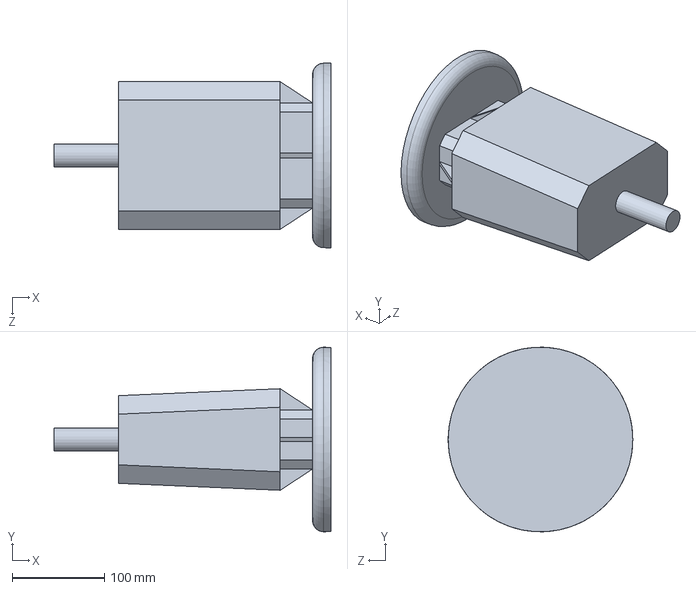
[picture p98: CAD file, 2026-04-25]
new version machine beta/reducteur moteur.SLDPRT
300.0 x 199.9 x 200.0 mm
