MedAmine-source/Ameloration-of-old-industrial-machinery/new version machine beta/3dfindit-Thomson_Linear-1BA04AH0L12.000-0202605140950544545549810e898ce/SOLIDWORKS/1BA04AH0L12_000.sldasm

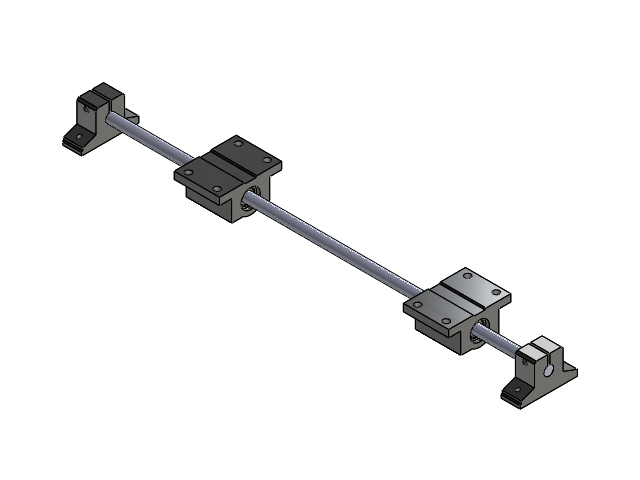
[picture p99: CAD file, 2026-06-09]
new version machine beta/3dfindit-Thomson_Linear-1BA04AH0L12.000-0202605140950544545549810e898ce/SOLIDWORKS/1BA04AH0L12_000.sldasm
H4 x 2
SPB4_3 x 2
RS-4-12
