MedAmine-source/Ameloration-of-old-industrial-machinery/new version machine beta/3dfindit-Kollmorgen-PMX0810-A10-BN0-00-0202605121024541976291610e898ce/SOLIDWORKS/PMX0810-A10-BN0-00.sldasm

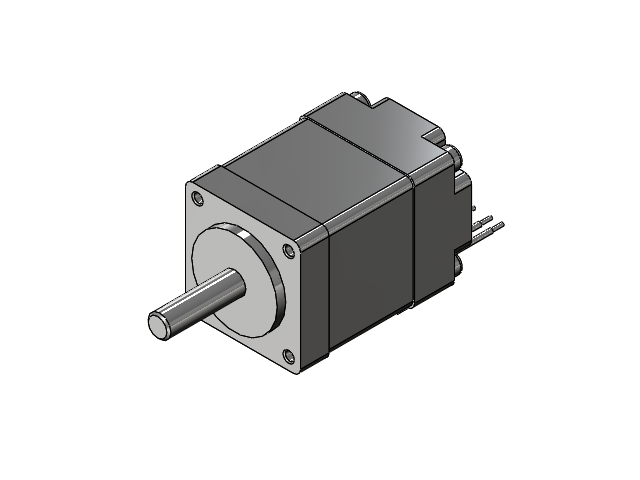
[picture p100: CAD file, 2026-06-09]
new version machine beta/3dfindit-Kollmorgen-PMX0810-A10-BN0-00-0202605121024541976291610e898ce/SOLIDWORKS/PMX0810-A10-BN0-00.sldasm
PMX0810-A10-BN0-00_body
Connector_1A108_
