MedAmine-source/Ameloration-of-old-industrial-machinery/new version machine beta/3dfindit-Kraus-5170-SV50x1.5-B8-IGM5x15-120-ZZ000-0202605021437103792830410e898ce/SOLIDWORKS/5170-SV50x1_5-B8-IGM5x15-120-ZZ000.sldasm

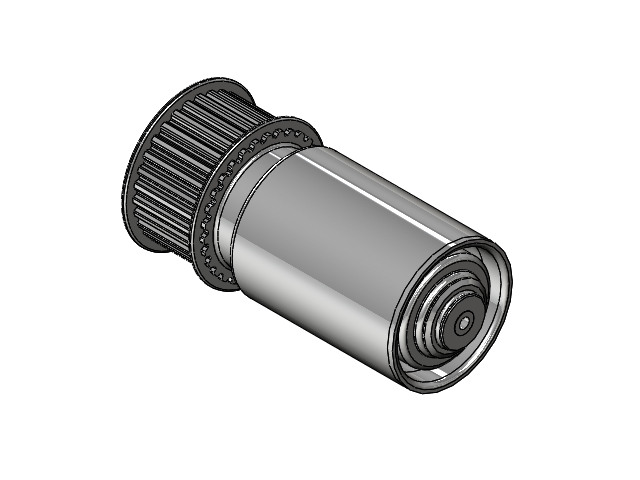
[picture p101: CAD file, 2026-06-09]
new version machine beta/3dfindit-Kraus-5170-SV50x1.5-B8-IGM5x15-120-ZZ000-0202605021437103792830410e898ce/SOLIDWORKS/5170-SV50x1_5-B8-IGM5x15-120-ZZ000.sldasm
5170-SV50x1.5-B8-IGM5x15-120-2600-ZZ0t
Axle D=8 L=120 IGM512065
