MedAmine-source/Ameloration-of-old-industrial-machinery/new version machine beta/3dfindit-Thomson_Linear-1DA08K00L12.000-0202605180919507290442510e898ce/SOLIDWORKS/1DA08K00L12_000.sldasm

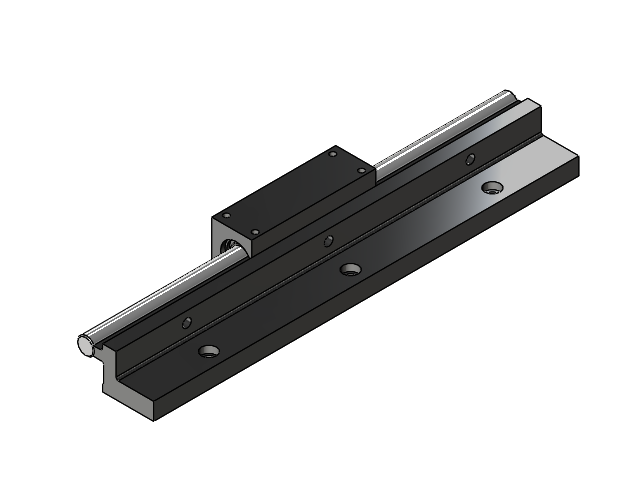
[picture p102: CAD file, 2026-06-09]
new version machine beta/3dfindit-Thomson_Linear-1DA08K00L12.000-0202605180919507290442510e898ce/SOLIDWORKS/1DA08K00L12_000.sldasm
SSRA8L12_d
TWN8_3da
