MedAmine-source/Ameloration-of-old-industrial-machinery/new version machine beta/assembly gripperv1.SLDASM

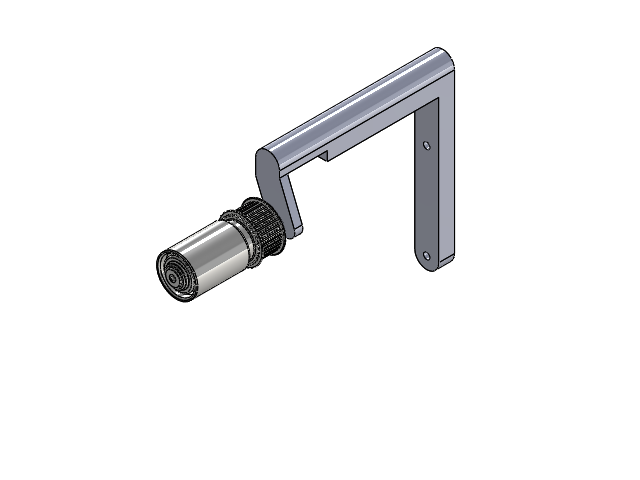
[picture p103: CAD file, 2026-06-09]
new version machine beta/assembly gripperv1.SLDASM
gripper v1
5170-SV50x1.5-B8-IGM5x15-120-2600-ZZ0t
Axle D=8 L=120 IGM512065
