MedAmine-source/Ameloration-of-old-industrial-machinery/new version machine beta/semi_auto_assembly.SLDASM

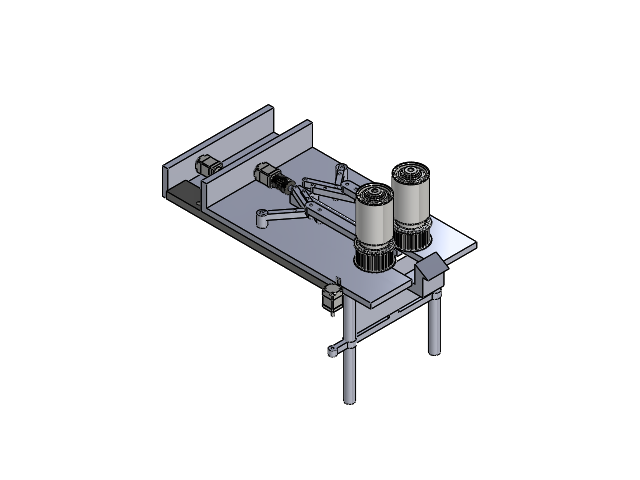
[picture p104: CAD file, 2026-06-09]
new version machine beta/semi_auto_assembly.SLDASM
support cale
cale v2 gripper x 6
MTSBHR10
PMX0810-A10-BN0-00_body x 3
Connector_1A108_ x 3
rouleau support x 2
5170-SV50x1.5-B8-IGM5x15-120-2600-ZZ0t x 2
Axle D=8 L=120 IGM512065 x 2
bene_inox_414653-8X200 x 2
MCJN20-8-4_body x 2
Hexagon socket set screw with flat point DIN 913 - M4x6 x 8
calle verin cauteau
H4
chauffage support
support cale inferieur
SSRA8L12_d
TWN8_3da
