MedAmine-source/Ameloration-of-old-industrial-machinery/new version machine beta/machine apex assembly v2.0.SLDASM

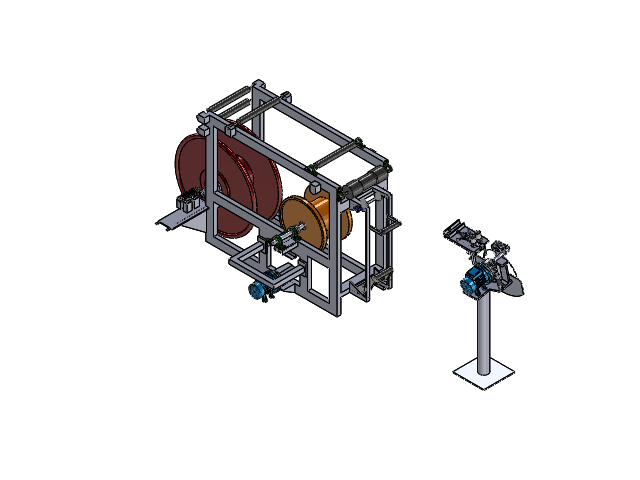
[picture p105: CAD file, 2026-06-09]
new version machine beta/machine apex assembly v2.0.SLDASM
corps machine apex v2.0
roue grande
AST_Bearings_UCP208 x 2
moteur stip
axe grand roue
tige support roue petite
roue petite
verin
piece3verin
piece1verin
verin_piece2
roue_96211-1
tige verin
bas_roue
Inner race x 10
cage x 20
Ball x 80
Rivet pin x 80
Outer race x 10
tige filtée m10
rouleau 190 x 2
UCFL-204 x 2
tige filtee M10 x 3
rouleau 60 x 4
tige trans1 x 2
roue trans1 x 4
AST_Bearings_UCP205 x 4
support trans x 2
trans haut rouleau
tige 20600 x 2
tige roulement x 4
moteur stip grand
reducteur moteur
rauleau basse v2.0 x 2
tige trans3 x 2
163310 DNC-32-125---(ZR)
DNC-32-125---(KS)
DIN-439-B - M10x1.25(F)
176939 CRHNC-50---(F) x 4
DIN-6912 - M8x20(F) x 8
support cale
cale v2 gripper x 6
MTSBHR10
PMX0810-A10-BN0-00_body x 3
Connector_1A108_ x 3
rouleau support x 2
5170-SV50x1.5-B8-IGM5x15-120-2600-ZZ0t x 2
Axle D=8 L=120 IGM512065 x 2
bene_inox_414653-8X200 x 2
MCJN20-8-4_body x 2
Hexagon socket set screw with flat point DIN 913 - M4x6 x 8
calle verin cauteau
H4
chauffage support
support cale inferieur
SSRA8L12_d
TWN8_3da
tringle
roue tang tringle
