MedAmine-source/Ameloration-of-old-industrial-machinery/new version machine beta/Assemblage reauleau basse v2.0.SLDASM

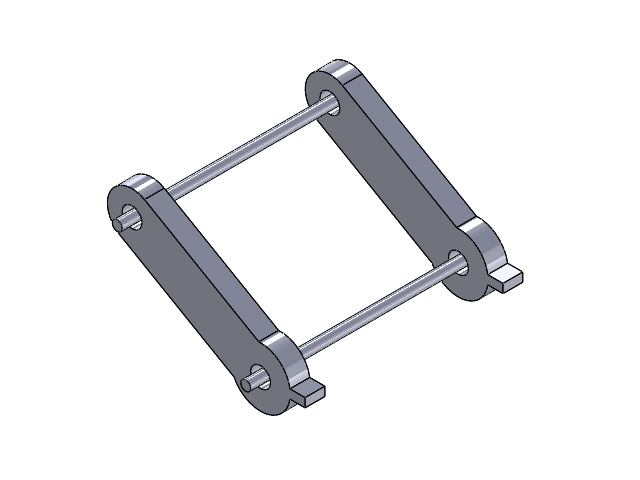
[picture p106: CAD file, 2026-06-09]
new version machine beta/Assemblage reauleau basse v2.0.SLDASM
rauleau basse v2.0 x 2
tige trans3 x 2
