MedAmine-source/Ameloration-of-old-industrial-machinery/(list of files, cad)

Other CAD files:
new version machine beta/3dfindit-AHP_Merkle-Châpe_LB-SD-32_-_Art.Nr._092169-0202605021554076612968710e898ce/clevis LB-SD-32 - Art_Nr_ 092169.sldprt
new version machine beta/3dfindit-Kollmorgen-PMX0810-A10-BN0-00-0202605121024541976291610e898ce/SOLIDWORKS/PMX0810-A10-BN0-00_body.sldprt
new version machine beta/3dfindit-Kraus-5170-SV50x1.5-B8-IGM5x15-120-ZZ000-0202605021437103792830410e898ce/SOLIDWORKS/Axle D=8 L=120 IGM512065.sldprt
new version machine beta/3dfindit-Thomson_Linear-1DA08K00L12.000-0202605180919507290442510e898ce/SOLIDWORKS/TWN8_3da.sldprt
new version machine beta/3dfindit-Vis_à_filetage_Neff-KGF-D-1605-RH-EE-0-0202605111027072841361310e898ce/KGF-D-1605-RH-EE-0.sldprt
new version machine beta/3dfindit-Kraus-5170-SV50x1.5-B8-IGM5x15-120-ZZ000-0202605021437103792830410e898ce/SOLIDWORKS/5170-SV50x1.5-B8-IGM5x15-120-2600-ZZ0t.sldprt
new version machine beta/3dfindit-Thomson_Linear-1BA04AH0L12.000-0202605140950544545549810e898ce/SOLIDWORKS/SPB4_3.sldprt
new version machine beta/3dfindit-Thomson_Linear-1DA08K00L12.000-0202605180919507290442510e898ce/SOLIDWORKS/SSRA8L12_d.sldprt
new version machine beta/3dfindit-Kollmorgen-PMX0810-A10-BN0-00-0202605121024541976291610e898ce/SOLIDWORKS/Connector_1A108_.sldprt
new version machine beta/3dfindit-Thomson_Linear-1BA04AH0L12.000-0202605140950544545549810e898ce/SOLIDWORKS/H4.sldprt
new version machine beta/3dfindit-Misumi-MCJN20-8-4-0202605121111327860566710e898ce/SOLIDWORKS/Hexagon socket set screw with flat point DIN 913 - M4x6.sldprt
new version machine beta/3dfindit-Misumi-MCJN20-8-4-0202605121111327860566710e898ce/SOLIDWORKS/MCJN20-8-4.sldasm
new version machine beta/3dfindit-Misumi-MCJN20-8-4-0202605121111327860566710e898ce/SOLIDWORKS/MCJN20-8-4_body.sldprt
new version machine beta/3dfindit-Misumi-MTSBHR10-0202605121017364866144510e898ce/MTSBHR10.sldprt
new version machine beta/mise en plan/corps machine apex v2.0.SLDDRW
new version machine beta/robot-gripper-mechanism-v2-1.snapshot.5/hvataljka v2.CATProduct
new version machine beta/robot-gripper-mechanism-v2-1.snapshot.5/navojno vreteno.CATPart
new version machine beta/robot-gripper-mechanism-v2-1.snapshot.5/poluga-1.CATPart
new version machine beta/robot-gripper-mechanism-v2-1.snapshot.5/poluga-2.CATPart
new version machine beta/robot-gripper-mechanism-v2-1.snapshot.5/postolje s motorom.CATPart
new version machine beta/robot-gripper-mechanism-v2-1.snapshot.5/prst.CATPart
new version machine beta/robot-gripper-mechanism-v2-1.snapshot.5/vodilica.CATPart
old version machine/mechanical design/axe grand roue.SLDPRT
old version machine/mechanical design/ball-bearing-roulement-2.snapshot.2/roulement.SLDASM
old version machine/mechanical design/bas_roue.SLDPRT
old version machine/mechanical design/bearing-240.snapshot.8/BEARING.SLDASM
old version machine/mechanical design/bearing-240.snapshot.8/Ball.SLDPRT
old version machine/mechanical design/bearing-240.snapshot.8/Inner race.SLDPRT
old version machine/mechanical design/bearing-240.snapshot.8/Outer race.SLDPRT
old version machine/mechanical design/bearing-240.snapshot.8/Rivet pin.SLDPRT
old version machine/mechanical design/bearing-240.snapshot.8/cage.SLDPRT
old version machine/mechanical design/bille de frinage_A.SLDPRT
old version machine/mechanical design/carcase moteur v0.1.SLDPRT
old version machine/mechanical design/complete-library-of-bearings-flange-type-bearing-unit-02-holes-1.snapshot.2/UCFL-201.SLDPRT
old version machine/mechanical design/complete-library-of-bearings-flange-type-bearing-unit-02-holes-1.snapshot.2/UCFL-201.STEP
old version machine/mechanical design/complete-library-of-bearings-flange-type-bearing-unit-02-holes-1.snapshot.2/UCFL-202.SLDPRT
old version machine/mechanical design/complete-library-of-bearings-flange-type-bearing-unit-02-holes-1.snapshot.2/UCFL-202.STEP
old version machine/mechanical design/complete-library-of-bearings-flange-type-bearing-unit-02-holes-1.snapshot.2/UCFL-203.SLDPRT
old version machine/mechanical design/complete-library-of-bearings-flange-type-bearing-unit-02-holes-1.snapshot.2/UCFL-203.STEP
old version machine/mechanical design/complete-library-of-bearings-flange-type-bearing-unit-02-holes-1.snapshot.2/UCFL-204.SLDPRT
old version machine/mechanical design/complete-library-of-bearings-flange-type-bearing-unit-02-holes-1.snapshot.2/UCFL-204.STEP
old version machine/mechanical design/complete-library-of-bearings-flange-type-bearing-unit-02-holes-1.snapshot.2/UCFL-205.SLDPRT
old version machine/mechanical design/complete-library-of-bearings-flange-type-bearing-unit-02-holes-1.snapshot.2/UCFL-205.STEP
old version machine/mechanical design/complete-library-of-bearings-flange-type-bearing-unit-02-holes-1.snapshot.2/UCFL-206.SLDPRT
old version machine/mechanical design/complete-library-of-bearings-flange-type-bearing-unit-02-holes-1.snapshot.2/UCFL-206.STEP
old version machine/mechanical design/complete-library-of-bearings-flange-type-bearing-unit-02-holes-1.snapshot.2/UCFL-207.SLDPRT
old version machine/mechanical design/complete-library-of-bearings-flange-type-bearing-unit-02-holes-1.snapshot.2/UCFL-207.STEP
old version machine/mechanical design/complete-library-of-bearings-flange-type-bearing-unit-02-holes-1.snapshot.2/UCFL-208.SLDPRT
old version machine/mechanical design/complete-library-of-bearings-flange-type-bearing-unit-02-holes-1.snapshot.2/UCFL-208.STEP
old version machine/mechanical design/complete-library-of-bearings-flange-type-bearing-unit-02-holes-1.snapshot.2/UCFL-209.SLDPRT
old version machine/mechanical design/complete-library-of-bearings-flange-type-bearing-unit-02-holes-1.snapshot.2/UCFL-209.STEP
old version machine/mechanical design/complete-library-of-bearings-flange-type-bearing-unit-02-holes-1.snapshot.2/UCFL-210.SLDPRT
old version machine/mechanical design/complete-library-of-bearings-flange-type-bearing-unit-02-holes-1.snapshot.2/UCFL-210.STEP
old version machine/mechanical design/complete-library-of-bearings-flange-type-bearing-unit-02-holes-1.snapshot.2/UCFL-211.SLDPRT
old version machine/mechanical design/complete-library-of-bearings-flange-type-bearing-unit-02-holes-1.snapshot.2/UCFL-211.STEP
old version machine/mechanical design/complete-library-of-bearings-flange-type-bearing-unit-02-holes-1.snapshot.2/UCFL-212.SLDPRT
old version machine/mechanical design/complete-library-of-bearings-flange-type-bearing-unit-02-holes-1.snapshot.2/UCFL-212.STEP
old version machine/mechanical design/complete-library-of-bearings-flange-type-bearing-unit-02-holes-1.snapshot.2/UCFL-213.SLDPRT
old version machine/mechanical design/complete-library-of-bearings-flange-type-bearing-unit-02-holes-1.snapshot.2/UCFL-213.STEP
old version machine/mechanical design/complete-library-of-bearings-flange-type-bearing-unit-02-holes-1.snapshot.2/UCFL-214.SLDPRT
old version machine/mechanical design/complete-library-of-bearings-flange-type-bearing-unit-02-holes-1.snapshot.2/UCFL-214.STEP
old version machine/mechanical design/complete-library-of-bearings-flange-type-bearing-unit-02-holes-1.snapshot.2/UCFL-215.SLDPRT
old version machine/mechanical design/complete-library-of-bearings-flange-type-bearing-unit-02-holes-1.snapshot.2/UCFL-215.STEP
old version machine/mechanical design/complete-library-of-bearings-flange-type-bearing-unit-02-holes-1.snapshot.2/UCFL-216.SLDPRT
old version machine/mechanical design/complete-library-of-bearings-flange-type-bearing-unit-02-holes-1.snapshot.2/UCFL-216.STEP
old version machine/mechanical design/complete-library-of-bearings-flange-type-bearing-unit-02-holes-1.snapshot.2/UCFL-217.SLDPRT
old version machine/mechanical design/complete-library-of-bearings-flange-type-bearing-unit-02-holes-1.snapshot.2/UCFL-217.STEP
old version machine/mechanical design/complete-library-of-bearings-flange-type-bearing-unit-02-holes-1.snapshot.2/UCFL-218.SLDPRT
old version machine/mechanical design/complete-library-of-bearings-flange-type-bearing-unit-02-holes-1.snapshot.2/UCFL-218.STEP
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
