MedAmine-source/Ameloration-of-old-industrial-machinery/old version machine/mechanical design/fiche technique moteur triphasee.pdf

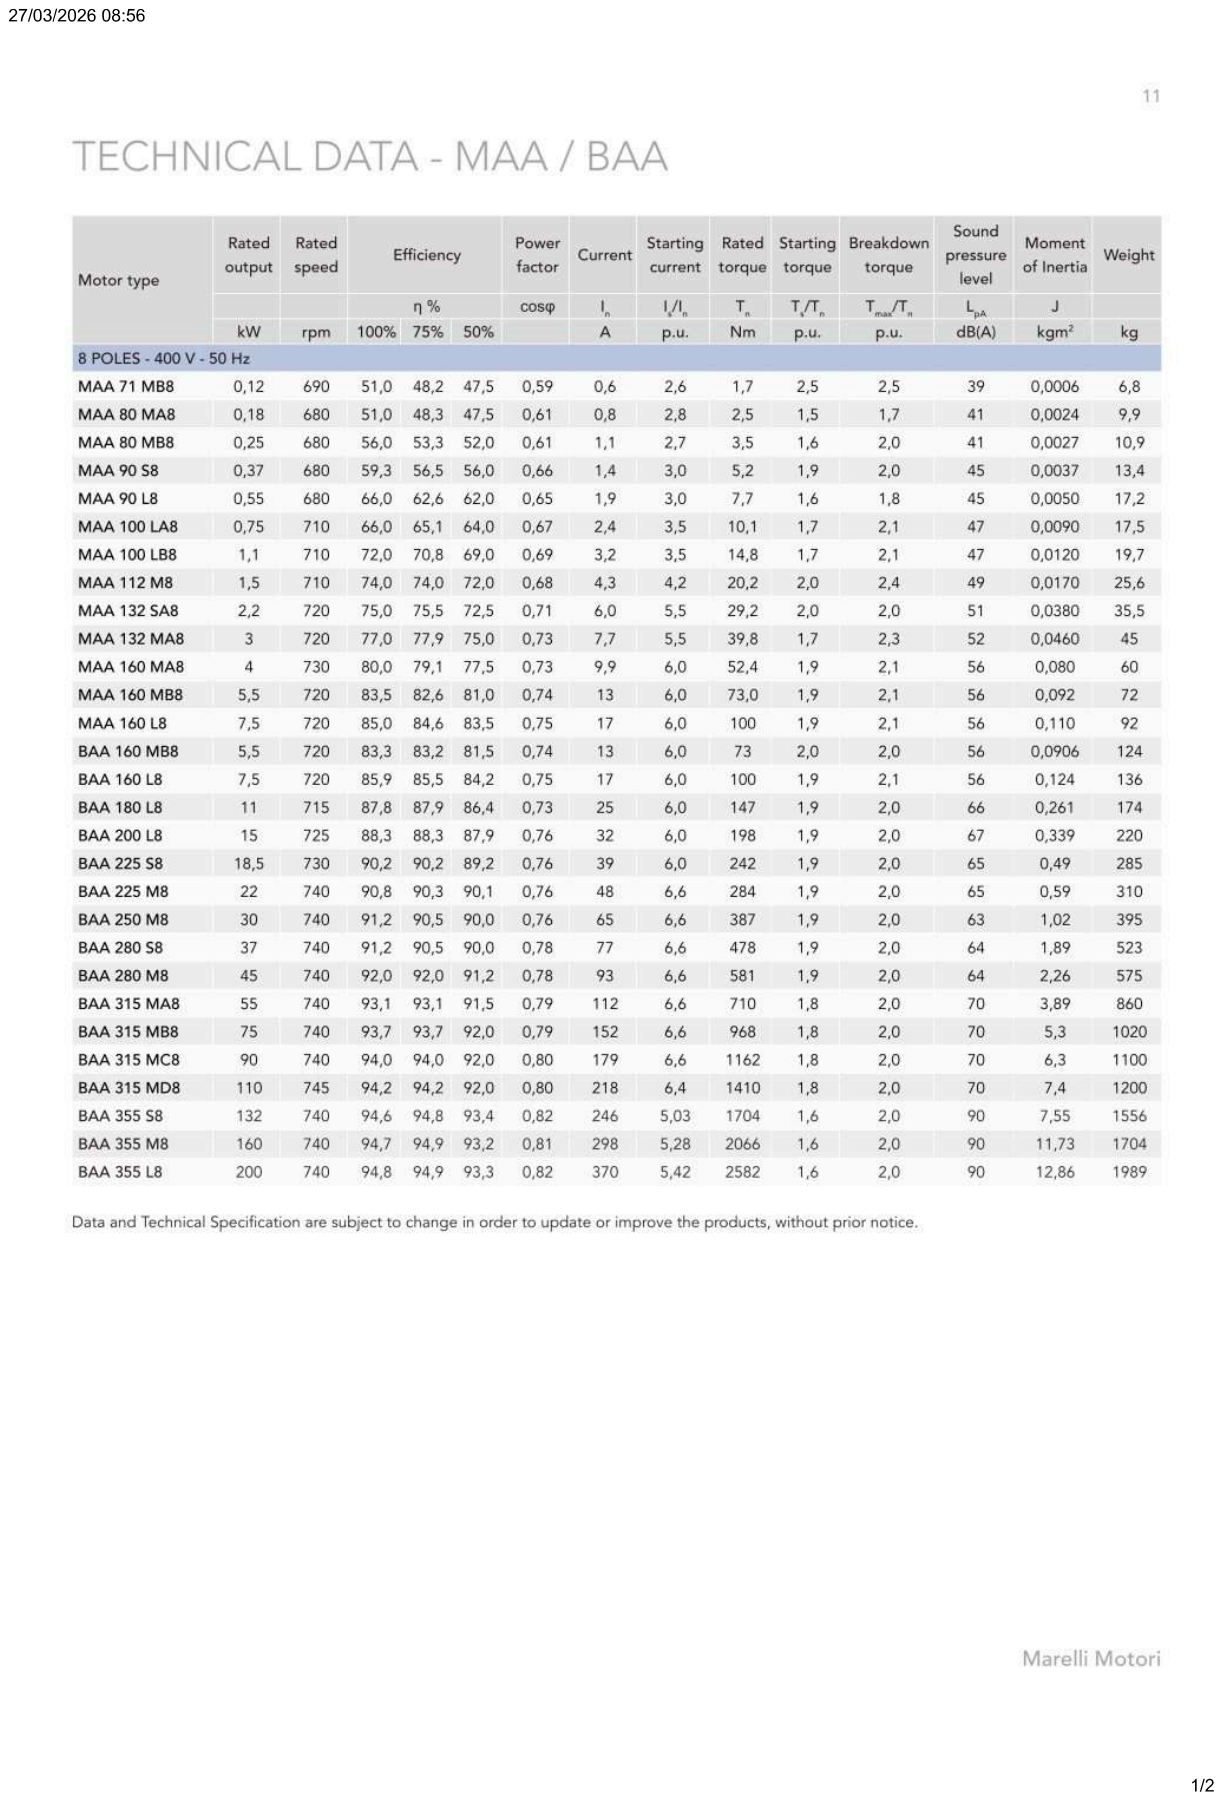
[picture p107: page 1]

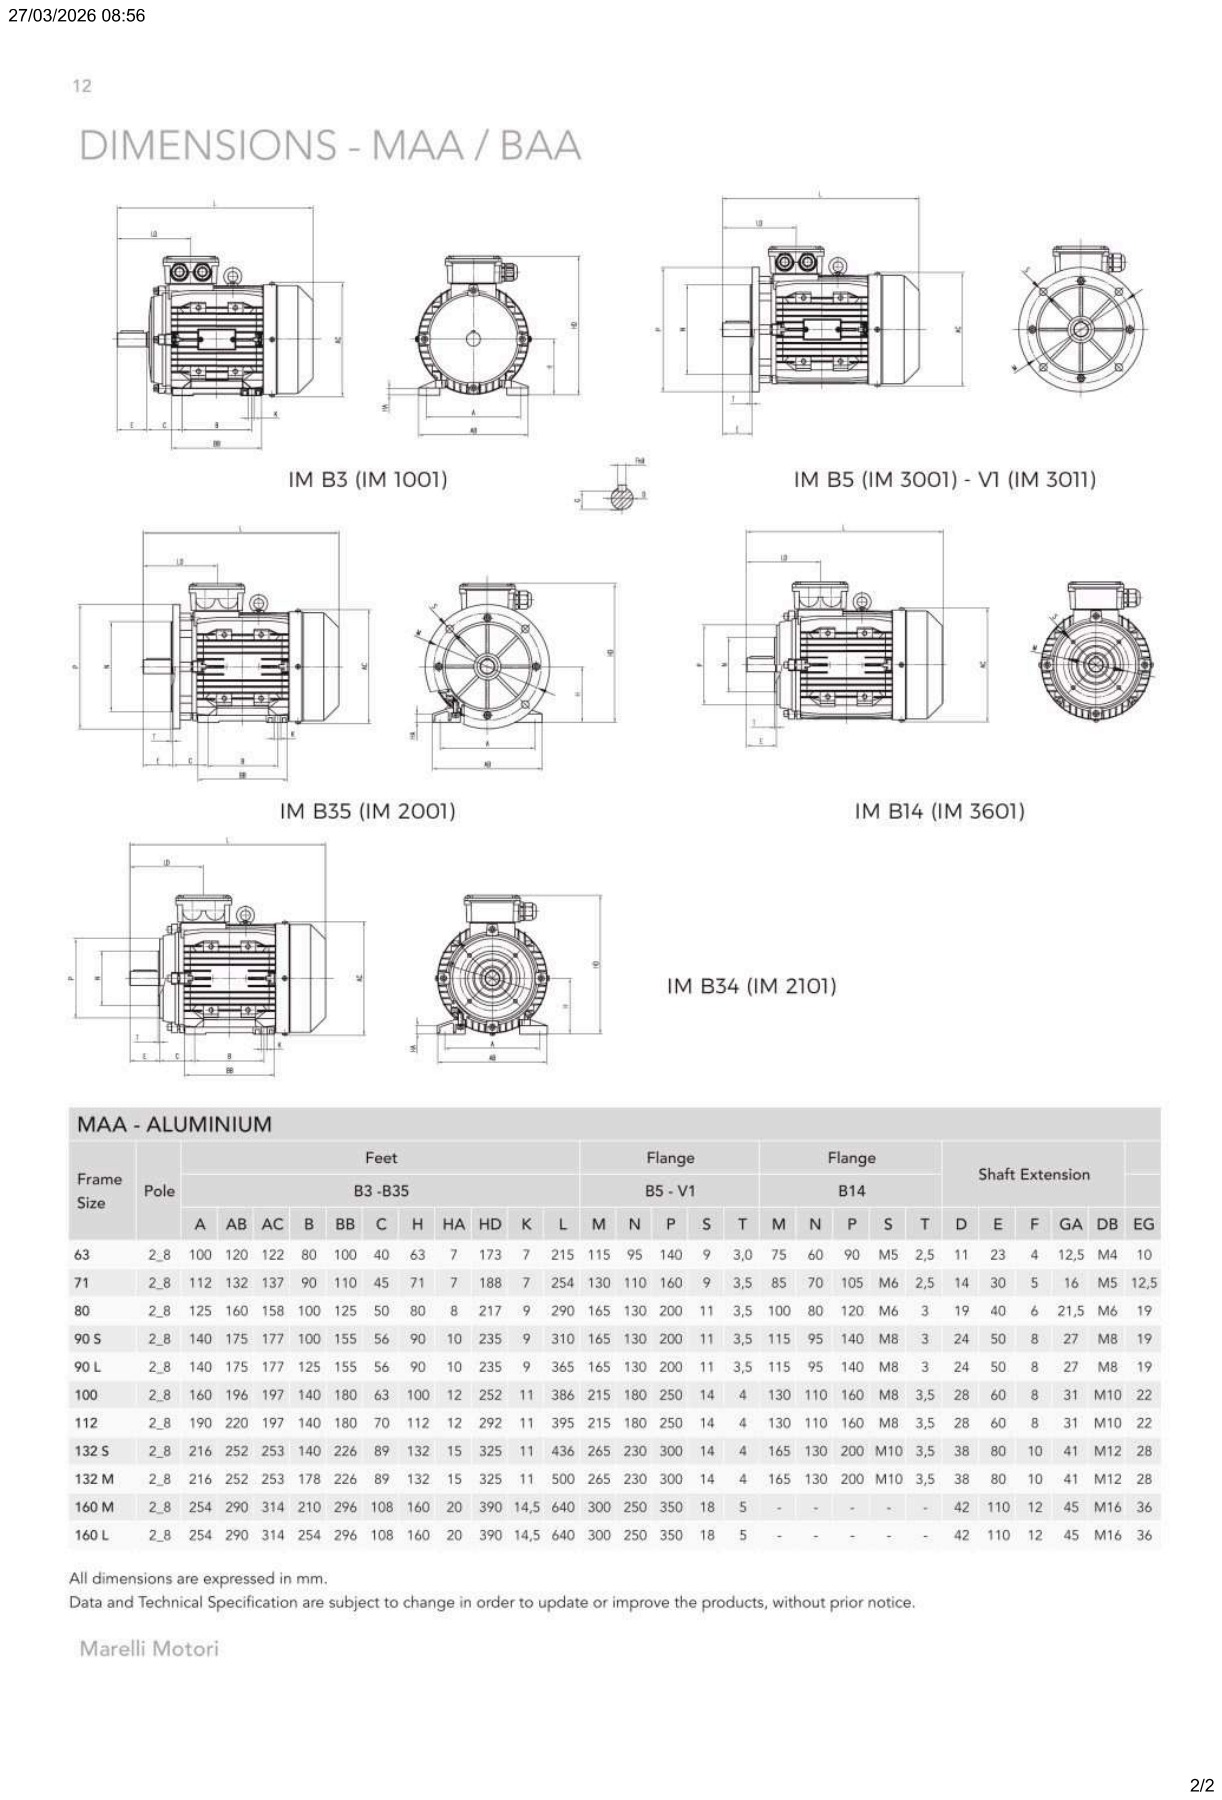
[picture p108: page 2]
