MedAmine-source/Ameloration-of-old-industrial-machinery/(commit log)

2026-04-25 i finish 90% of the old machine's mechanical design
    [AST_Bearings_UCP201.SLDPRT, AST_Bearings_UCP202.SLDPRT, AST_Bearings_UCP203.SLDPRT, AST_Bearings_UCP204.SLDPRT, AST_Bearings_UCP205.SLDPRT, AST_Bearings_UCP206.SLDPRT, AST_Bearings_UCP207.SLDPRT, AST_Bearings_UCP208.SLDPRT]
2026-04-30 old version electrical design and some few update
    [AST_Bearings_UCP201.SLDPRT, AST_Bearings_UCP202.SLDPRT, AST_Bearings_UCP203.SLDPRT, AST_Bearings_UCP204.SLDPRT, AST_Bearings_UCP205.SLDPRT, AST_Bearings_UCP206.SLDPRT, AST_Bearings_UCP207.SLDPRT, AST_Bearings_UCP208.SLDPRT]
2026-06-09 add new mechanical design
    [1BA04AH0L12_000.sldasm, 1DA08K00L12_000.sldasm, 5170-SV50x1.5-B8-IGM5x15-120-2600-ZZ0t.sldprt, 5170-SV50x1_5-B8-IGM5x15-120-ZZ000.sldasm, Assemblage amine guesmi bbb.SLDPRT, Assemblage reauleau basse v2.0.SLDASM, Assemblage1.SLDASM, Axle D=8 L=120 IGM512065.sldprt]
